ATaylorCEngFIET/f14_CADC/original_docs/toc-illustrations.pdf

t-l
t-f

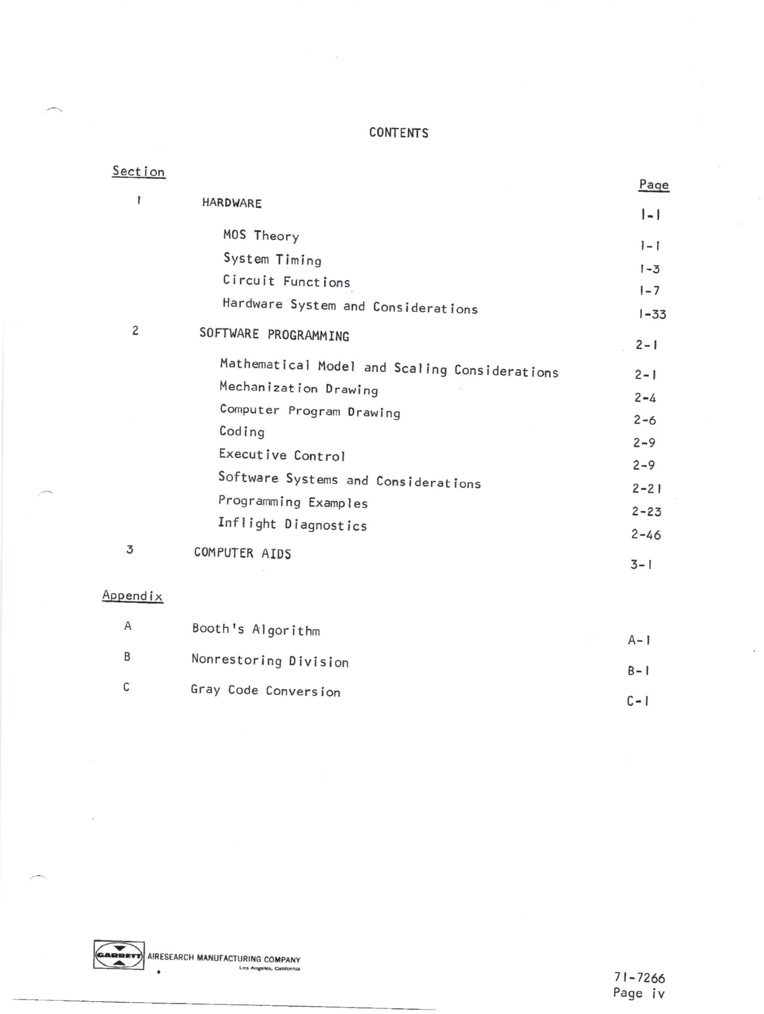
[picture p2: page 1]

Sect i on

I

Append ix

2

CONTE}TTS

HARDWARE

MOS Theory
Systern Timing
Circuit Functions.
Hardware System and Considerat ions

SO FTT,'ARE PROGRAI,IH ING
Mathematical Model and Scal ing Considerations
l.lechan i zat i on D rawi ng
Cornpute.r program Drawing

Cod i ng
Execut ive Control
Software Systems and Considerations Progranrning ExampIes
Infl ight D iagnost ics

COI,IPUTER AIDS

Booth rs Al gor ithm

Nonrestoring Division

Gray Code Convers ion

AIRESEARCH TIAIIUFACTURIT'G COUPA'IY

Paqe

t-5
l-7
t -35
2-l
?-l
2-4
2-6
2-9
2-9
2-?'
2-23
2-46
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
7 t -7266
Page iv

(6^lttq6llMa

t-l

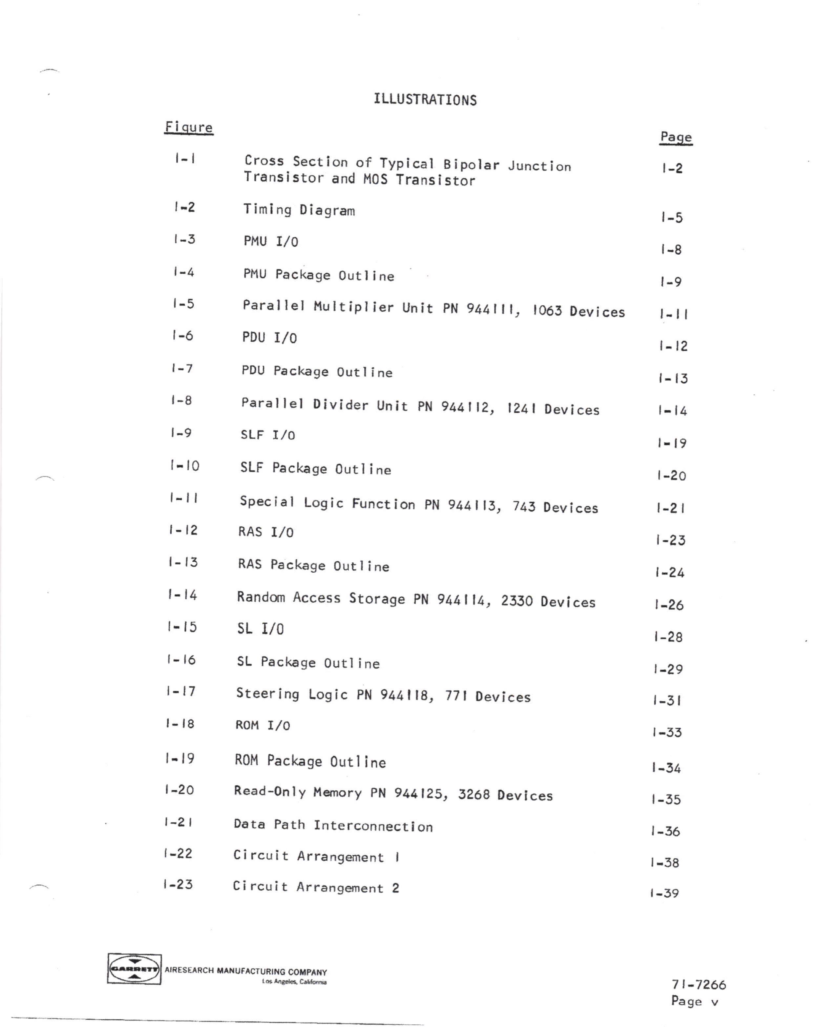
[picture p3: page 2]

Fi oure

ILLUSTRATIONS

### Cross Section of Typical Bipolar Junction Transistor and H0S Transistor

Timi ng Diagram

PMU I/O

PMU Package Outline

## Paral lel ttultipl ier Unit pN g44lll, 1063 Devices

PDU I/O

PDU Package Outline
Paral lel Divider Unit pN gi4llZ, 124 t Devices

SLF I,/O

SLF Package Outl ine
Special Logic Function pN g44llS, 745 Devices

RAS I/O

RAS Package Outline

Randorn Access Storage pN g44l14, Z33O Devices

SL I/O

SL Package 0utl ine
Steering Logic PN g44llg, 771 Devices

ROM I/O

R0t'1 Package Outline
Read-Only Hernory pN 9441A5, 126g Devlces Data Path Interconnection
Ci rcuit Arrange.rnent I
Circuit Arrangement 2

A'RESEARCH MAI{Uf ACTURING COI!PANY

Paqe
t-2

t -?,
l-3
t-4
t-5
t-6
t-7
l-8
t-9
t- l0

## r-il

t- t2
l- t3
t- t4
t- t5
l- t6
t-t7
t- t8
l- t9

t-20
t-2t

1-22
t-23

t-5
l-8
t-9
t- I I
t-t2

t- t3
t- t4
t- t9

I -20
t-2t

| -25
,-24
t-26

| -28
t-29
r-3 I

r -55

I -34
I -35

I -56

I -58
r -59

7 t-7266
Page v

t 6 &edq C.lCorE

2-t

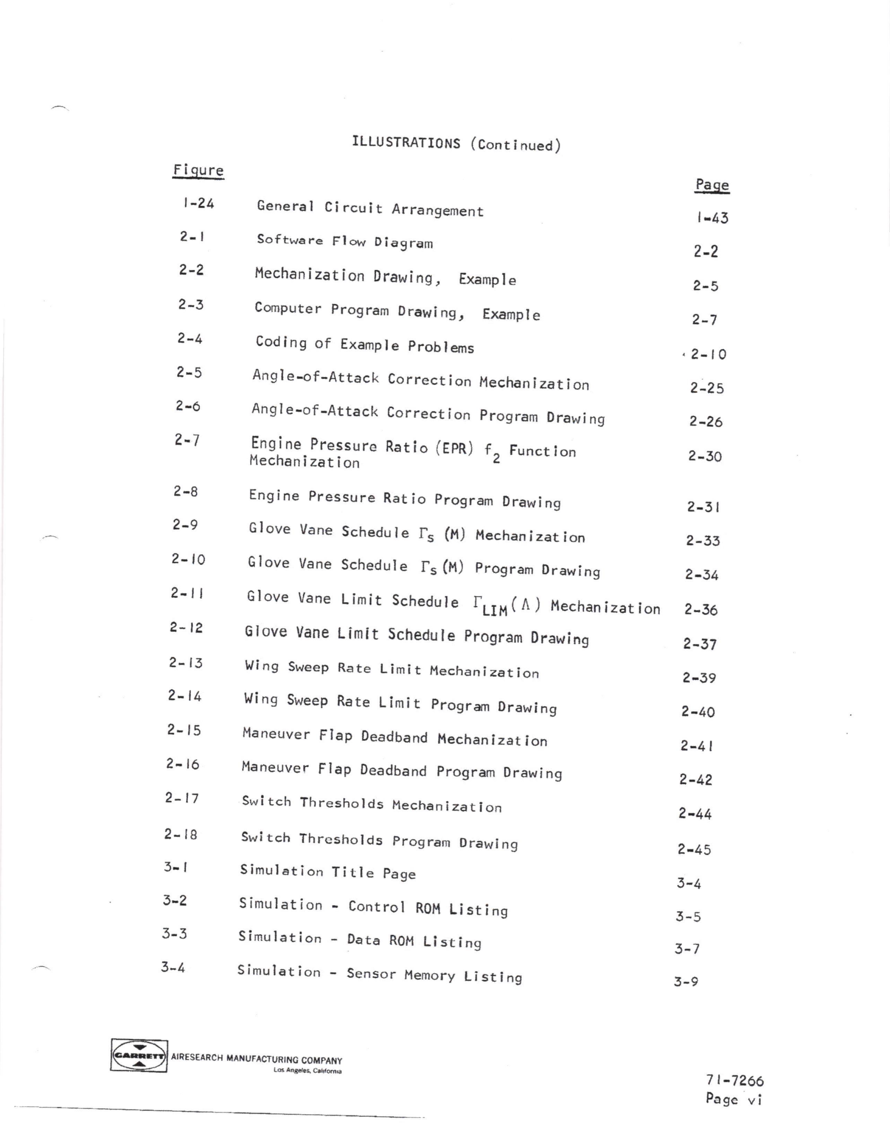
[picture p4: page 3]

Fiqure
t-24

z-2
2-3
2-4

2-5
z-6

2-7

ILLUSTRATIONS (Cont i nued)

General Ci rcuit Arrangement Softwore Flor Diagram

Mechanization Drawing, Example Conrputer program Drawi ng, E:<ampl e

Coding of Example problems Angle-of-Attack Correct ion Mechan izat ion Angle-of-Attack Correction program Drawing

## ,*:;f ,ljff:X." Rat i o (EPR) r, Funct ion

Engine Pressure Ratio program Drawing Glove Vane Schedule fu (H) Hectranization

GIove Vane Schedule f, (m) program Drawing
Glove Vane Limit Schedule lltm ( A ) t{echanizat ion Glove uane Llmlt schedule program Drawing

ly'ing Sweep Rate Limit Hechanization

Wing Sweep Rate Limit progranr Drawing

Haneuver FIap Deadband Mechanizat ion

Haneuver Flap Deadband program Drawing Swi tch Thresholds Hechanizat Ion

Switsh Thresholds program Drawing Simuletion Title page
Simulation - Control R0fi Listing Simulation - Data ROH Listing Simulation - Sensor l.temory Listing

A'RESEANCH MANUFASTURING COTTPATIY

Paqe
| -45
2-2
2-5

2-7
,2-t0

2-2s
2-26

2-30

?-8
2-9
2-t0
2-tI

2- t2

2- 13
2-,4

2- t5
2- t6

2- t7

2- l8
5-t

3-2
3-3
3-4

2-3t

2-33
2-34

2-36

2-37
2-39
2-40
2-4t

2-42

2-44

2-45
3-4
5-5

3-7
5-9

7 t-7266
Page vi

L6 tua+a 61rffi6

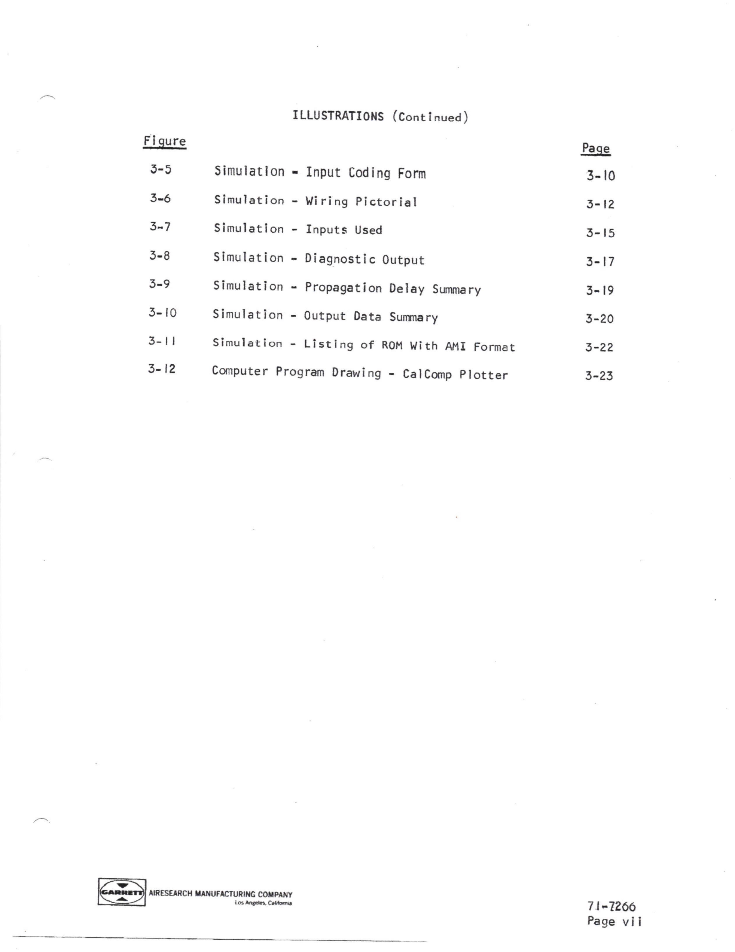
[picture p5: page 4]

Fi qure

5-5

5-6

3-7

5-8
3-9
5- t0
3-il

3- t2

Paqe
3- t0
3- tz
3- 15

3- l7

3- 19

5-20

3-?2
3-23

ILLUSTRATIONS (Cont i nued)

Simulation - Input Coding Form

Simulation - l/i ri n9 pictorial Simulation - Inputs Used
Simulation - Diagnostic Output
Simulation - Propagation Delay Summary Simulation - 0utput Oata Sunmary

### Simulat ion - List i ng of ROl,l u/i th AMI Format

Computer Program Drawing - CalComp plotter

ATRESETRCH tllr{ufAcruRttac collpAr{y
7.1-1266
Page vi i

tG }Eraa C.fbnc
