ATaylorCEngFIET/f14_CADC/sim_results.txt

# ** Note: (vsim-220) 'C:/questa_base64_2025.3/win64/../modelsim.ini' is used as the ini file.
# vsim -batch -t ns work.cadc_top_tb -do "run 50us; quit -f" 
# Start time: 17:16:37 on Feb 21,2026
# ** Note: (vsim-3812) Design is being optimized...
# ** Note: (vopt-220) 'C:/questa_base64_2025.3/win64/../modelsim.ini' is used as the ini file.
# ** Warning: (vopt-133) Unable to remove directory "C:/Users/aptay/Dropbox/adiuvo/f14-CADC/work/@_opt".
# ** Note: (vsim-12126) Error and warning message counts have been restored: Errors=0, Warnings=1.
# //  QuestaSim Base Edition-64
# //  Version 2025.3 win64 Sep 15 2025
# //
# // Unpublished work. Copyright 2025 Siemens
# //
# // This material contains trade secrets or otherwise confidential information
# // owned by Siemens Industry Software Inc. or its affiliates (collectively,
# // "SISW"), or its licensors. Access to and use of this information is strictly
# // limited as set forth in the Customer's applicable agreements with SISW.
# //
# // This material may not be copied, distributed, or otherwise disclosed outside
# // of the Customer's facilities without the express written permission of SISW,
# // and may not be used in any way not expressly authorized by SISW.
# //
# Loading std.standard
# Loading std.textio(body)
# Loading ieee.std_logic_1164(body)
# Loading ieee.numeric_std(body)
# Loading work.cadc_top_tb(bench)#1
# Loading work.cadc_top(structural)#1
# 
# run 50us
# ** Note: ======================================
#    Time: 0 ns  Iteration: 0  Instance: /cadc_top_tb
# ** Note: F-14A CADC Polynomial Computation Test
#    Time: 0 ns  Iteration: 0  Instance: /cadc_top_tb
# ** Note: ======================================
#    Time: 0 ns  Iteration: 0  Instance: /cadc_top_tb
# ** Note: Polynomial: E = a3*X^3 + a2*X^2 + a1*X + a0
#    Time: 0 ns  Iteration: 0  Instance: /cadc_top_tb
# ** Note: Coefficients: a3=0.125, a2=0.25, a1=0.375, a0=0.0625
#    Time: 0 ns  Iteration: 0  Instance: /cadc_top_tb
# ** Note: Input X = sensor_ps (Q1.19 fractional format)
#    Time: 0 ns  Iteration: 0  Instance: /cadc_top_tb
# ** Note: 
#    Time: 0 ns  Iteration: 0  Instance: /cadc_top_tb
# ** Note: TOP-T-001: System Reset Test
#    Time: 0 ns  Iteration: 0  Instance: /cadc_top_tb
# ** Warning: NUMERIC_STD.TO_INTEGER: metavalue detected, returning 0
#    Time: 0 ns  Iteration: 0  Instance: /cadc_top_tb/uut/u_ras
# ** Warning: NUMERIC_STD.TO_INTEGER: metavalue detected, returning 0
#    Time: 0 ns  Iteration: 0  Instance: /cadc_top_tb/uut
# ** Warning: NUMERIC_STD.TO_INTEGER: metavalue detected, returning 0
#    Time: 0 ns  Iteration: 1  Instance: /cadc_top_tb/uut
# ** Warning: NUMERIC_STD.TO_INTEGER: metavalue detected, returning 0
#    Time: 0 ns  Iteration: 1  Instance: /cadc_top_tb/uut/u_ras
# ** Warning: NUMERIC_STD.TO_INTEGER: metavalue detected, returning 0
#    Time: 0 ns  Iteration: 2  Instance: /cadc_top_tb/uut/u_ras
# ** Note:   PASSED: Outputs zero after reset
#    Time: 241 ns  Iteration: 0  Instance: /cadc_top_tb
# ** Note: 
#    Time: 241 ns  Iteration: 0  Instance: /cadc_top_tb
# ** Note: TOP-T-002: Polynomial with X = 0.5 (0x40000)
#    Time: 241 ns  Iteration: 0  Instance: /cadc_top_tb
# ** Note:   Input X = 0x40000 (0.5)
#    Time: 4231 ns  Iteration: 0  Instance: /cadc_top_tb
# ** Note:   Result E = 0x2A000
#    Time: 4231 ns  Iteration: 0  Instance: /cadc_top_tb
# ** Note:   PASSED: Polynomial computed non-zero result
#    Time: 4231 ns  Iteration: 0  Instance: /cadc_top_tb
# ** Note: 
#    Time: 4231 ns  Iteration: 0  Instance: /cadc_top_tb
# ** Note: TOP-T-003: Result Stability Check
#    Time: 4231 ns  Iteration: 0  Instance: /cadc_top_tb
# ** Note:   PASSED: Result stable after halt (0x2A000)
#    Time: 6231 ns  Iteration: 0  Instance: /cadc_top_tb
# ** Note: 
#    Time: 6231 ns  Iteration: 0  Instance: /cadc_top_tb
# ** Note: TOP-T-004: Polynomial with X = 0.25 (0x20000)
#    Time: 6231 ns  Iteration: 0  Instance: /cadc_top_tb
# ** Note:   Input X = 0x20000 (0.25)
#    Time: 10371 ns  Iteration: 0  Instance: /cadc_top_tb
# ** Note:   Result E = 0x16400
#    Time: 10371 ns  Iteration: 0  Instance: /cadc_top_tb
# ** Note:   PASSED: Different input produces different result
#    Time: 10371 ns  Iteration: 0  Instance: /cadc_top_tb
# ** Note: 
#    Time: 10371 ns  Iteration: 0  Instance: /cadc_top_tb
# ** Note: TOP-T-005: Polynomial with X = 0.75 (0x60000)
#    Time: 10371 ns  Iteration: 0  Instance: /cadc_top_tb
# ** Note:   Input X = 0x60000 (0.75)
#    Time: 14511 ns  Iteration: 0  Instance: /cadc_top_tb
# ** Note:   Result E = 0x44C00
#    Time: 14511 ns  Iteration: 0  Instance: /cadc_top_tb
# ** Note:   PASSED: Non-zero result for X=0.75
#    Time: 14511 ns  Iteration: 0  Instance: /cadc_top_tb
# ** Note: 
#    Time: 14511 ns  Iteration: 0  Instance: /cadc_top_tb
# ** Note: TOP-T-006: Channel Inactive Output Gating
#    Time: 14511 ns  Iteration: 0  Instance: /cadc_top_tb
# ** Note:   PASSED: Output gated to zero when channel inactive
#    Time: 14612 ns  Iteration: 0  Instance: /cadc_top_tb
# ** Note: 
#    Time: 14652 ns  Iteration: 0  Instance: /cadc_top_tb
# ** Note: TOP-T-007: Extended Run (1000 cycles)
#    Time: 14652 ns  Iteration: 0  Instance: /cadc_top_tb
# ** Note:   PASSED: System ran 1000 cycles without lockup
#    Time: 34651 ns  Iteration: 0  Instance: /cadc_top_tb
# ** Note: 
#    Time: 34651 ns  Iteration: 0  Instance: /cadc_top_tb
# ** Note: TOP-T-008: Fail Detect Signal
#    Time: 34651 ns  Iteration: 0  Instance: /cadc_top_tb
# ** Note:   PASSED: No failure detected
#    Time: 34651 ns  Iteration: 0  Instance: /cadc_top_tb
# ** Note: 
#    Time: 34851 ns  Iteration: 0  Instance: /cadc_top_tb
# ** Note: ======================================
#    Time: 34851 ns  Iteration: 0  Instance: /cadc_top_tb
# ** Note: CADC Polynomial Testbench Complete
#    Time: 34851 ns  Iteration: 0  Instance: /cadc_top_tb
# ** Note: ======================================
#    Time: 34851 ns  Iteration: 0  Instance: /cadc_top_tb
# ** Note: Tests run: 7
#    Time: 34851 ns  Iteration: 0  Instance: /cadc_top_tb
# ** Note: Failures:  0
#    Time: 34851 ns  Iteration: 0  Instance: /cadc_top_tb
# ** Note: RESULT: ALL TESTS PASSED
#    Time: 34851 ns  Iteration: 0  Instance: /cadc_top_tb
# ** Note: ======================================
#    Time: 34851 ns  Iteration: 0  Instance: /cadc_top_tb
# ** Note: 
#    Time: 34851 ns  Iteration: 0  Instance: /cadc_top_tb
# ** Note: Note: This testbench verifies the polynomial microprogram
#    Time: 34851 ns  Iteration: 0  Instance: /cadc_top_tb
# ** Note: from Section 2 of Ray Holt's CADC documentation.
#    Time: 34851 ns  Iteration: 0  Instance: /cadc_top_tb
# ** Note: E = a3*X^3 + a2*X^2 + a1*X + a0 computed via Horner's method.
#    Time: 34851 ns  Iteration: 0  Instance: /cadc_top_tb
# ** Failure: sim complete
#    Time: 34851 ns  Iteration: 0  Process: /cadc_top_tb/stim File: tb/cadc_top_tb.vhd
# Break in Process stim at tb/cadc_top_tb.vhd line 309
# Stopped at tb/cadc_top_tb.vhd line 309
# quit -f
# End time: 17:16:39 on Feb 21,2026, Elapsed time: 0:00:02
# Errors: 1, Warnings: 6
