ATaylorCEngFIET/f14_CADC/implementation/vivado_proj/cadc_cmoda7.gen/sources_1/bd/cadc_system/ip/cadc_system_jtag_axi_0_0/synth/cadc_system_jtag_axi_0_0.vhd

-- (c) Copyright 1986-2022 Xilinx, Inc. All Rights Reserved.
-- (c) Copyright 2022-2026 Advanced Micro Devices, Inc. All rights reserved.
-- 
-- This file contains confidential and proprietary information
-- of AMD and is protected under U.S. and international copyright
-- and other intellectual property laws.
-- 
-- DISCLAIMER
-- This disclaimer is not a license and does not grant any
-- rights to the materials distributed herewith. Except as
-- otherwise provided in a valid license issued to you by
-- AMD, and to the maximum extent permitted by applicable
-- law: (1) THESE MATERIALS ARE MADE AVAILABLE "AS IS" AND
-- WITH ALL FAULTS, AND AMD HEREBY DISCLAIMS ALL WARRANTIES
-- AND CONDITIONS, EXPRESS, IMPLIED, OR STATUTORY, INCLUDING
-- BUT NOT LIMITED TO WARRANTIES OF MERCHANTABILITY, NON-
-- INFRINGEMENT, OR FITNESS FOR ANY PARTICULAR PURPOSE; and
-- (2) AMD shall not be liable (whether in contract or tort,
-- including negligence, or under any other theory of
-- liability) for any loss or damage of any kind or nature
-- related to, arising under or in connection with these
-- materials, including for any direct, or any indirect,
-- special, incidental, or consequential loss or damage
-- (including loss of data, profits, goodwill, or any type of
-- loss or damage suffered as a result of any action brought
-- by a third party) even if such damage or loss was
-- reasonably foreseeable or AMD had been advised of the
-- possibility of the same.
-- 
-- CRITICAL APPLICATIONS
-- AMD products are not designed or intended to be fail-
-- safe, or for use in any application requiring fail-safe
-- performance, such as life-support or safety devices or
-- systems, Class III medical devices, nuclear facilities,
-- applications related to the deployment of airbags, or any
-- other applications that could lead to death, personal
-- injury, or severe property or environmental damage
-- (individually and collectively, "Critical
-- Applications"). Customer assumes the sole risk and
-- liability of any use of AMD products in Critical
-- Applications, subject only to applicable laws and
-- regulations governing limitations on product liability.
-- 
-- THIS COPYRIGHT NOTICE AND DISCLAIMER MUST BE RETAINED AS
-- PART OF THIS FILE AT ALL TIMES.
-- 
-- DO NOT MODIFY THIS FILE.

-- IP VLNV: xilinx.com:ip:jtag_axi:1.2
-- IP Revision: 22

LIBRARY ieee;
USE ieee.std_logic_1164.ALL;
USE ieee.numeric_std.ALL;

LIBRARY jtag_axi;
USE jtag_axi.jtag_axi_v1_2_22_jtag_axi;

ENTITY cadc_system_jtag_axi_0_0 IS
  PORT (
    aclk : IN STD_LOGIC;
    aresetn : IN STD_LOGIC;
    m_axi_awaddr : OUT STD_LOGIC_VECTOR(31 DOWNTO 0);
    m_axi_awprot : OUT STD_LOGIC_VECTOR(2 DOWNTO 0);
    m_axi_awvalid : OUT STD_LOGIC;
    m_axi_awready : IN STD_LOGIC;
    m_axi_wdata : OUT STD_LOGIC_VECTOR(31 DOWNTO 0);
    m_axi_wstrb : OUT STD_LOGIC_VECTOR(3 DOWNTO 0);
    m_axi_wvalid : OUT STD_LOGIC;
    m_axi_wready : IN STD_LOGIC;
    m_axi_bresp : IN STD_LOGIC_VECTOR(1 DOWNTO 0);
    m_axi_bvalid : IN STD_LOGIC;
    m_axi_bready : OUT STD_LOGIC;
    m_axi_araddr : OUT STD_LOGIC_VECTOR(31 DOWNTO 0);
    m_axi_arprot : OUT STD_LOGIC_VECTOR(2 DOWNTO 0);
    m_axi_arvalid : OUT STD_LOGIC;
    m_axi_arready : IN STD_LOGIC;
    m_axi_rdata : IN STD_LOGIC_VECTOR(31 DOWNTO 0);
    m_axi_rresp : IN STD_LOGIC_VECTOR(1 DOWNTO 0);
    m_axi_rvalid : IN STD_LOGIC;
    m_axi_rready : OUT STD_LOGIC
  );
END cadc_system_jtag_axi_0_0;

ARCHITECTURE cadc_system_jtag_axi_0_0_arch OF cadc_system_jtag_axi_0_0 IS
  ATTRIBUTE DowngradeIPIdentifiedWarnings : STRING;
  ATTRIBUTE DowngradeIPIdentifiedWarnings OF cadc_system_jtag_axi_0_0_arch: ARCHITECTURE IS "yes";
  COMPONENT jtag_axi_v1_2_22_jtag_axi IS
    GENERIC (
      RD_TXN_QUEUE_LENGTH : INTEGER;
      WR_TXN_QUEUE_LENGTH : INTEGER;
      M_AXI_ID_WIDTH : INTEGER;
      M_AXI_ADDR_WIDTH : INTEGER;
      FAMILY : STRING;
      M_AXI_DATA_WIDTH : INTEGER;
      M_HAS_BURST : INTEGER;
      PROTOCOL : INTEGER
    );
    PORT (
      aclk : IN STD_LOGIC;
      aresetn : IN STD_LOGIC;
      m_axi_awid : OUT STD_LOGIC_VECTOR(0 DOWNTO 0);
      m_axi_awaddr : OUT STD_LOGIC_VECTOR(31 DOWNTO 0);
      m_axi_awlen : OUT STD_LOGIC_VECTOR(7 DOWNTO 0);
      m_axi_awsize : OUT STD_LOGIC_VECTOR(2 DOWNTO 0);
      m_axi_awburst : OUT STD_LOGIC_VECTOR(1 DOWNTO 0);
      m_axi_awlock : OUT STD_LOGIC;
      m_axi_awcache : OUT STD_LOGIC_VECTOR(3 DOWNTO 0);
      m_axi_awprot : OUT STD_LOGIC_VECTOR(2 DOWNTO 0);
      m_axi_awqos : OUT STD_LOGIC_VECTOR(3 DOWNTO 0);
      m_axi_awvalid : OUT STD_LOGIC;
      m_axi_awready : IN STD_LOGIC;
      m_axi_wdata : OUT STD_LOGIC_VECTOR(31 DOWNTO 0);
      m_axi_wstrb : OUT STD_LOGIC_VECTOR(3 DOWNTO 0);
      m_axi_wlast : OUT STD_LOGIC;
      m_axi_wvalid : OUT STD_LOGIC;
      m_axi_wready : IN STD_LOGIC;
      m_axi_bid : IN STD_LOGIC_VECTOR(0 DOWNTO 0);
      m_axi_bresp : IN STD_LOGIC_VECTOR(1 DOWNTO 0);
      m_axi_bvalid : IN STD_LOGIC;
      m_axi_bready : OUT STD_LOGIC;
      m_axi_arid : OUT STD_LOGIC_VECTOR(0 DOWNTO 0);
      m_axi_araddr : OUT STD_LOGIC_VECTOR(31 DOWNTO 0);
      m_axi_arlen : OUT STD_LOGIC_VECTOR(7 DOWNTO 0);
      m_axi_arsize : OUT STD_LOGIC_VECTOR(2 DOWNTO 0);
      m_axi_arburst : OUT STD_LOGIC_VECTOR(1 DOWNTO 0);
      m_axi_arlock : OUT STD_LOGIC;
      m_axi_arcache : OUT STD_LOGIC_VECTOR(3 DOWNTO 0);
      m_axi_arprot : OUT STD_LOGIC_VECTOR(2 DOWNTO 0);
      m_axi_arqos : OUT STD_LOGIC_VECTOR(3 DOWNTO 0);
      m_axi_arvalid : OUT STD_LOGIC;
      m_axi_arready : IN STD_LOGIC;
      m_axi_rid : IN STD_LOGIC_VECTOR(0 DOWNTO 0);
      m_axi_rdata : IN STD_LOGIC_VECTOR(31 DOWNTO 0);
      m_axi_rresp : IN STD_LOGIC_VECTOR(1 DOWNTO 0);
      m_axi_rlast : IN STD_LOGIC;
      m_axi_rvalid : IN STD_LOGIC;
      m_axi_rready : OUT STD_LOGIC
    );
  END COMPONENT jtag_axi_v1_2_22_jtag_axi;
  ATTRIBUTE X_CORE_INFO : STRING;
  ATTRIBUTE X_CORE_INFO OF cadc_system_jtag_axi_0_0_arch: ARCHITECTURE IS "jtag_axi_v1_2_22_jtag_axi,Vivado 2025.1";
  ATTRIBUTE CHECK_LICENSE_TYPE : STRING;
  ATTRIBUTE CHECK_LICENSE_TYPE OF cadc_system_jtag_axi_0_0_arch : ARCHITECTURE IS "cadc_system_jtag_axi_0_0,jtag_axi_v1_2_22_jtag_axi,{}";
  ATTRIBUTE CORE_GENERATION_INFO : STRING;
  ATTRIBUTE CORE_GENERATION_INFO OF cadc_system_jtag_axi_0_0_arch: ARCHITECTURE IS "cadc_system_jtag_axi_0_0,jtag_axi_v1_2_22_jtag_axi,{x_ipProduct=Vivado 2025.1,x_ipVendor=xilinx.com,x_ipLibrary=ip,x_ipName=jtag_axi,x_ipVersion=1.2,x_ipCoreRevision=22,x_ipLanguage=VHDL,x_ipSimLanguage=MIXED,RD_TXN_QUEUE_LENGTH=1,WR_TXN_QUEUE_LENGTH=1,M_AXI_ID_WIDTH=1,M_AXI_ADDR_WIDTH=32,FAMILY=artix7,M_AXI_DATA_WIDTH=32,M_HAS_BURST=1,PROTOCOL=2}";
  ATTRIBUTE X_INTERFACE_INFO : STRING;
  ATTRIBUTE X_INTERFACE_MODE : STRING;
  ATTRIBUTE X_INTERFACE_PARAMETER : STRING;
  ATTRIBUTE X_INTERFACE_INFO OF aclk: SIGNAL IS "xilinx.com:signal:clock:1.0 signal_clock CLK";
  ATTRIBUTE X_INTERFACE_MODE OF aclk: SIGNAL IS "slave signal_clock";
  ATTRIBUTE X_INTERFACE_PARAMETER OF aclk: SIGNAL IS "XIL_INTERFACENAME signal_clock, ASSOCIATED_BUSIF M_AXI, ASSOCIATED_RESET aresetn, FREQ_HZ 100000000, FREQ_TOLERANCE_HZ 0, PHASE 0.0, CLK_DOMAIN /clk_wiz_0_clk_out1, INSERT_VIP 0";
  ATTRIBUTE X_INTERFACE_INFO OF aresetn: SIGNAL IS "xilinx.com:signal:reset:1.0 signal_reset RST";
  ATTRIBUTE X_INTERFACE_MODE OF aresetn: SIGNAL IS "slave signal_reset";
  ATTRIBUTE X_INTERFACE_PARAMETER OF aresetn: SIGNAL IS "XIL_INTERFACENAME signal_reset, POLARITY ACTIVE_LOW, INSERT_VIP 0";
  ATTRIBUTE X_INTERFACE_INFO OF m_axi_araddr: SIGNAL IS "xilinx.com:interface:aximm:1.0 M_AXI ARADDR";
  ATTRIBUTE X_INTERFACE_INFO OF m_axi_arprot: SIGNAL IS "xilinx.com:interface:aximm:1.0 M_AXI ARPROT";
  ATTRIBUTE X_INTERFACE_INFO OF m_axi_arready: SIGNAL IS "xilinx.com:interface:aximm:1.0 M_AXI ARREADY";
  ATTRIBUTE X_INTERFACE_INFO OF m_axi_arvalid: SIGNAL IS "xilinx.com:interface:aximm:1.0 M_AXI ARVALID";
  ATTRIBUTE X_INTERFACE_INFO OF m_axi_awaddr: SIGNAL IS "xilinx.com:interface:aximm:1.0 M_AXI AWADDR";
  ATTRIBUTE X_INTERFACE_MODE OF m_axi_awaddr: SIGNAL IS "master M_AXI";
  ATTRIBUTE X_INTERFACE_PARAMETER OF m_axi_awaddr: SIGNAL IS "XIL_INTERFACENAME M_AXI, AWUSER_WIDTH 0, ARUSER_WIDTH 0, WUSER_WIDTH 0, BUSER_WIDTH 0, RUSER_WIDTH 0, SUPPORTS_NARROW_BURST 0, DATA_WIDTH 32, PROTOCOL AXI4LITE, FREQ_HZ 100000000, ID_WIDTH 0, ADDR_WIDTH 32, READ_WRITE_MODE READ_WRITE, HAS_BURST 0, HAS_LOCK 0, HAS_PROT 1, HAS_CACHE 0, HAS_QOS 0, HAS_REGION 0, HAS_WSTRB 1, HAS_BRESP 1, HAS_RRESP 1, NUM_READ_OUTSTANDING 1, NUM_WRITE_OUTSTANDING 1, MAX_BURST_LENGTH 1, PHASE 0.0, CLK_DOMAIN /clk_wiz_0_clk_out1, NUM_READ_THREADS 1, NUM_WRITE_THREADS 1" & 
", RUSER_BITS_PER_BYTE 0, WUSER_BITS_PER_BYTE 0, INSERT_VIP 0";
  ATTRIBUTE X_INTERFACE_INFO OF m_axi_awprot: SIGNAL IS "xilinx.com:interface:aximm:1.0 M_AXI AWPROT";
  ATTRIBUTE X_INTERFACE_INFO OF m_axi_awready: SIGNAL IS "xilinx.com:interface:aximm:1.0 M_AXI AWREADY";
  ATTRIBUTE X_INTERFACE_INFO OF m_axi_awvalid: SIGNAL IS "xilinx.com:interface:aximm:1.0 M_AXI AWVALID";
  ATTRIBUTE X_INTERFACE_INFO OF m_axi_bready: SIGNAL IS "xilinx.com:interface:aximm:1.0 M_AXI BREADY";
  ATTRIBUTE X_INTERFACE_INFO OF m_axi_bresp: SIGNAL IS "xilinx.com:interface:aximm:1.0 M_AXI BRESP";
  ATTRIBUTE X_INTERFACE_INFO OF m_axi_bvalid: SIGNAL IS "xilinx.com:interface:aximm:1.0 M_AXI BVALID";
  ATTRIBUTE X_INTERFACE_INFO OF m_axi_rdata: SIGNAL IS "xilinx.com:interface:aximm:1.0 M_AXI RDATA";
  ATTRIBUTE X_INTERFACE_INFO OF m_axi_rready: SIGNAL IS "xilinx.com:interface:aximm:1.0 M_AXI RREADY";
  ATTRIBUTE X_INTERFACE_INFO OF m_axi_rresp: SIGNAL IS "xilinx.com:interface:aximm:1.0 M_AXI RRESP";
  ATTRIBUTE X_INTERFACE_INFO OF m_axi_rvalid: SIGNAL IS "xilinx.com:interface:aximm:1.0 M_AXI RVALID";
  ATTRIBUTE X_INTERFACE_INFO OF m_axi_wdata: SIGNAL IS "xilinx.com:interface:aximm:1.0 M_AXI WDATA";
  ATTRIBUTE X_INTERFACE_INFO OF m_axi_wready: SIGNAL IS "xilinx.com:interface:aximm:1.0 M_AXI WREADY";
  ATTRIBUTE X_INTERFACE_INFO OF m_axi_wstrb: SIGNAL IS "xilinx.com:interface:aximm:1.0 M_AXI WSTRB";
  ATTRIBUTE X_INTERFACE_INFO OF m_axi_wvalid: SIGNAL IS "xilinx.com:interface:aximm:1.0 M_AXI WVALID";
BEGIN
  U0 : jtag_axi_v1_2_22_jtag_axi
    GENERIC MAP (
      RD_TXN_QUEUE_LENGTH => 1,
      WR_TXN_QUEUE_LENGTH => 1,
      M_AXI_ID_WIDTH => 1,
      M_AXI_ADDR_WIDTH => 32,
      FAMILY => "artix7",
      M_AXI_DATA_WIDTH => 32,
      M_HAS_BURST => 1,
      PROTOCOL => 2
    )
    PORT MAP (
      aclk => aclk,
      aresetn => aresetn,
      m_axi_awaddr => m_axi_awaddr,
      m_axi_awprot => m_axi_awprot,
      m_axi_awvalid => m_axi_awvalid,
      m_axi_awready => m_axi_awready,
      m_axi_wdata => m_axi_wdata,
      m_axi_wstrb => m_axi_wstrb,
      m_axi_wvalid => m_axi_wvalid,
      m_axi_wready => m_axi_wready,
      m_axi_bid => STD_LOGIC_VECTOR(TO_UNSIGNED(0, 1)),
      m_axi_bresp => m_axi_bresp,
      m_axi_bvalid => m_axi_bvalid,
      m_axi_bready => m_axi_bready,
      m_axi_araddr => m_axi_araddr,
      m_axi_arprot => m_axi_arprot,
      m_axi_arvalid => m_axi_arvalid,
      m_axi_arready => m_axi_arready,
      m_axi_rid => STD_LOGIC_VECTOR(TO_UNSIGNED(0, 1)),
      m_axi_rdata => m_axi_rdata,
      m_axi_rresp => m_axi_rresp,
      m_axi_rlast => '0',
      m_axi_rvalid => m_axi_rvalid,
      m_axi_rready => m_axi_rready
    );
END cadc_system_jtag_axi_0_0_arch;
