ATaylorCEngFIET/f14_CADC/implementation/vivado_proj/cadc_cmoda7.gen/sources_1/bd/cadc_system/ipshared/7557/hdl/jtag_axi_v1_2_rfs.v

`pragma protect begin_protected
`pragma protect version = 1
`pragma protect encrypt_agent = "XILINX"
`pragma protect encrypt_agent_info = "Xilinx Encryption Tool 2025.1"
`pragma protect key_keyowner = "Synopsys", key_keyname = "SNPS-VCS-RSA-2", key_method = "rsa"
`pragma protect encoding = (enctype = "BASE64", line_length = 76, bytes = 128)
`pragma protect key_block
ZGBOdjFNDZWih9i7dViy5O4mfCX+KM+Jpl4+JuIUXGEIPd5EPpiX8YepIw1J/GGQxY7KBQyt/UwM
0B+6RXHqRFr8BO1f55n3qZpqcjwILhKKKiiUX/GJztyetWYOkSSv74/XryytAfQsJq+Cr5ncBP51
zHhuoBwfCs4BAlHvj6U=

`pragma protect key_keyowner = "Aldec", key_keyname = "ALDEC15_001", key_method = "rsa"
`pragma protect encoding = (enctype = "BASE64", line_length = 76, bytes = 256)
`pragma protect key_block
XKLNMtQJsKxqBqkNTtiRIK8u7HvyPgw/vy5O5sWmLIf+es+o57mVUxIPbv0qZnI4zrl58aly0iRT
znUwMjY4d+9FkVAy+sbofwK/+wQ0AzBNoIIC0Ct01GgqGxyo6m1NlpZMpKcsKpjKNOMANrjMyPA7
+XKn4nADd2rZE0fEYMJsrjLJwhGXQEgEiPUFOQb2LIRNtgG54Bb/U4VWqZazQb25ITGJR+yyKeX6
LmEiH3JxSncA9FEVQIoL8HiX1U+EfV5TgPzR3w12rqqR5/XqG/N7Pqe2vzlgi8+Ve77IsujtPYF6
Ik4foGpcOrp5q8pHa0o+TEGkEO6EL3dQ1+S0FQ==

`pragma protect key_keyowner = "Mentor Graphics Corporation", key_keyname = "MGC-VELOCE-RSA", key_method = "rsa"
`pragma protect encoding = (enctype = "BASE64", line_length = 76, bytes = 128)
`pragma protect key_block
RhbWOpxu+RTRy58hi6+6V12xRfpvM9cFoN9is+mo8a7cAwL6XA+8oz0UE6sSHS/3+AcYSp2AJS+O
eAkGZQ4IA7LCxILlEasaC0d3j61mE4XOmJ0Q+LEKKf5u9RXx7FDMKlJ4rXwhRjZm60/88FEx/rKR
EIqiTPA2XdTJtolGNzQ=

`pragma protect key_keyowner = "Mentor Graphics Corporation", key_keyname = "MGC-VERIF-SIM-RSA-2", key_method = "rsa"
`pragma protect encoding = (enctype = "BASE64", line_length = 76, bytes = 256)
`pragma protect key_block
EGb0g7u4UEditTgM0lWo5kj2nxkYrbql3HeYfdAuONOmKoktkCsw4KYtUz2vxunr4RN4LphzR2dC
L9Ts5SEuCBeR8f0TQrN9u1bVJea//siuk/8Dv4PXCE+fR+Ef6ukh8nLoCdQhJo+ljZsUAmQiX618
DQDg/7Yox2gTc0gPeSsaz/ikaw1IFZfNyI12dGDCjXjHTW9hiwTv0NB42S0PT5OYFlMk03SkgVtP
oehfv3W3ceZBjGjgvsz3tP8e8tkrEU0bZfC1DbpW4V21ZKblYCKvpLVszXubFHA26FbYSTpw7+0n
qahu5ggFvGaqTW6H99/iHPaIRx47IgLFDsW26A==

`pragma protect key_keyowner = "Real Intent", key_keyname = "RI-RSA-KEY-1", key_method = "rsa"
`pragma protect encoding = (enctype = "BASE64", line_length = 76, bytes = 256)
`pragma protect key_block
cWzuEgz57Qfhb7y9vZdxqR2RGRWDk1aU2fpqFwXKfcLh7dlGCtkVTjII8kuZVnCvx4XJsH5w6+Qi
2yQ293hI3YvdpHA77xb4JhFkI8hgQZ/ADHW2nbV6q2Vab90IJ9NIX8EnczmzXqsSGDXV3moALtjw
AszbwoSXSnbRp2WFgeSyPlGU1LObNZcRh3DC8V0R59kWaulbFa8O8WWt+/7BUBTnD4UDT0ZuDC1C
McX+vuQ6UmSX+fawfef+Cp9axdb0Pc46Boq/OCYR5w7UDKwGbfDag2zxiSbfnQB0pbcMlSa499Zp
t8C8BdugAIX7pIG6bGvMgt6Ey4v2dKsK7ronPQ==

`pragma protect key_keyowner = "Metrics Technologies Inc.", key_keyname = "DSim", key_method = "rsa"
`pragma protect encoding = (enctype = "BASE64", line_length = 76, bytes = 256)
`pragma protect key_block
eJpJBQrWFdi/Yf4LplAk08EjhOZ1lGNFXhEgWCPtV/2rR6xrZwzFLPfDl2JwKIeG+B0s18jzt1wO
vwpOeXSJ0pxAeDwOaaqo+/mLNal8FiYtTRuOGSW2vStq9+EEghPDB+e/N1l+r7buqGEymqxmPjM/
vb3SNwD5/RDQUlagcB/ywVM79LTLXKN6QoviMDEP2OcTq7YgMwqkad7reJHhQlKFoa3qjsGzph3t
xyzIbKswlBOSxCWs2oCXpLhdIkJ7Dwfg9IeIXpzlePKqrfpt/pkIKUcXHwWlw/4Zy1ACIp4mu+63
AOkDKoFg9MdhwEj/rpEX5YUqPR/oA5o1GYXHzw==

`pragma protect key_keyowner = "Xilinx", key_keyname = "xilinxt_2025.1-2029.x", key_method = "rsa"
`pragma protect encoding = (enctype = "BASE64", line_length = 76, bytes = 256)
`pragma protect key_block
YN3VSrgq7xJ8XenE6gJGJY45gUYLxm5QlMbBhoSkScHAUya/mrLJMCHE27K31Lck0bJ+kSpiZbj9
t+w7WNxw58bp1LVekANKRksd30YGfaVx+t9Fjef3AIkFQaMmKVq7gGkT22wzzWBM4E0B3fGFpnRL
rzJpPxFjI76OD3vX0ub/5mdz/WzbMZeYWO/SeOI1wcCY2O2mCP5+ncM+XMQSlf2uIZ7SsiqqUgPJ
MldlN10QmE+TawDq20qDexERSxEyKabKF/SQLj9AnjnfJ2yeQINGd9dAkS3B1y145ydQzTbzFlT0
cQ9oT3JF7sV+51gqugfvfX8M7lLEicCHLTPy+A==

`pragma protect key_keyowner = "Atrenta", key_keyname = "ATR-SG-RSA-1", key_method = "rsa"
`pragma protect encoding = (enctype = "BASE64", line_length = 76, bytes = 384)
`pragma protect key_block
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

`pragma protect key_keyowner = "Cadence Design Systems.", key_keyname = "CDS_RSA_KEY_VER_1", key_method = "rsa"
`pragma protect encoding = (enctype = "BASE64", line_length = 76, bytes = 256)
`pragma protect key_block
OYyuyiJyPFjJkLQA6ixRFr2ZOidh6L3PfY4uAneYpAy2Bz0Hlo29QclVVOUgyKANidTyBhD0wHnM
EQnd+TJhHwah60Zr6UE4mJdyFmlynPrajfLjrhvwkAfV9OYULoDW6Qqb/lubEZrK2M55yLJJ9Y3Q
S8baFI4eLS4uFF5IIcz+vNNt8ZO2jjQRBXEAnF7NNC6u+tfHf5QpuRmWumhTy3ANLkcY7xWdRSVC
fNHPzatD9bLCPGSWMeJQywDsCzx1nbq+qdsNui27GEEl8VM+1bNJlCXgE8mz0ex66mitc9LBRSxk
FYwtb80GCX6zwdynbKtcMWNjHPbrM15LUllFIQ==

`pragma protect key_keyowner = "Synplicity", key_keyname = "SYNP15_1", key_method = "rsa"
`pragma protect encoding = (enctype = "BASE64", line_length = 76, bytes = 256)
`pragma protect key_block
tdU03a9p5sZtsIuBz/RlwGGAcNGokSnO+97OJUXiO/UbQ7rztkm11m8sD+zo6Kuo46jlA0T1APkx
FwPzNVAPIaM8FrMoNjb1VGvp27EODfGSsckGgP4gTMXJwSEB4inxHk2pdxQTsoykASSI78NRtIVA
ZF1mR4Z4MXkXapmKk9si/Qv8pr+a+RpbVRUvm7umr9+37YY9shu+1icEJ7WAAPKDWbxD9awwiCA3
DndTD0DYL+wdx4kQr/CHbUxoSm7DjahJLaSAYl/TSCJBQtb1Zr1YDwLHbw9RNkKXGWHzg0yQJHCE
dPtR/t+gTOI0knXEQ81hHZXeY1L4jMTQXhQAtA==

`pragma protect key_keyowner = "Mentor Graphics Corporation", key_keyname = "MGC-PREC-RSA", key_method = "rsa"
`pragma protect encoding = (enctype = "BASE64", line_length = 76, bytes = 256)
`pragma protect key_block
eIC98GX7EhBlHCxKJEJZ5bcsL4Wqeuy/QJRYgB2PSXAVMe+JQKNxZxUOgQ51ItJXdvF1lfLe2Ney
jOUpOVu3ZQGxWlAsUtYFDxy9Qhu3QpeZsuMSwYrB3L6+yxKmshhRpt3VpUWogdWBzN+7DJAo8ltA
faqawMjbNxwnZu2rytQrkU4pHrg64FgDn6ONsmX4zKmHL+o+eb5GVuecPrNp/cwU5piwR9Mz1ihV
hGSshnJFdu2nRFLH9lLNxMV414oe4s4mD0IUuraNvE0dUAEAHJU+5RMqIEOqfAAdOzs91nPsBZDb
H/EjD1DgmACBNT4Lt5eGTgrXjwBsTDkXk33yHQ==

`pragma protect data_method = "AES128-CBC"
`pragma protect encoding = (enctype = "BASE64", line_length = 76, bytes = 8080)
`pragma protect data_block
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
`pragma protect end_protected
