ATaylorCEngFIET/f14_CADC/implementation/vivado_proj/cadc_cmoda7.gen/sources_1/bd/cadc_system/synth/cadc_system.vhd

--Copyright 1986-2022 Xilinx, Inc. All Rights Reserved.
--Copyright 2022-2025 Advanced Micro Devices, Inc. All Rights Reserved.
----------------------------------------------------------------------------------
--Tool Version: Vivado v.2025.1 (win64) Build 6140274 Thu May 22 00:12:29 MDT 2025
--Date        : Sun Feb 22 20:57:40 2026
--Host        : Adiuvo_Adam running 64-bit major release  (build 9200)
--Command     : generate_target cadc_system.bd
--Design      : cadc_system
--Purpose     : IP block netlist
----------------------------------------------------------------------------------
library IEEE;
use IEEE.STD_LOGIC_1164.ALL;
library UNISIM;
use UNISIM.VCOMPONENTS.ALL;
entity m00_couplers_imp_1D76A4Z is
  port (
    M_ACLK : in STD_LOGIC;
    M_ARESETN : in STD_LOGIC;
    M_AXI_araddr : out STD_LOGIC_VECTOR ( 31 downto 0 );
    M_AXI_arready : in STD_LOGIC;
    M_AXI_arvalid : out STD_LOGIC;
    M_AXI_awaddr : out STD_LOGIC_VECTOR ( 31 downto 0 );
    M_AXI_awready : in STD_LOGIC;
    M_AXI_awvalid : out STD_LOGIC;
    M_AXI_bready : out STD_LOGIC;
    M_AXI_bresp : in STD_LOGIC_VECTOR ( 1 downto 0 );
    M_AXI_bvalid : in STD_LOGIC;
    M_AXI_rdata : in STD_LOGIC_VECTOR ( 31 downto 0 );
    M_AXI_rready : out STD_LOGIC;
    M_AXI_rresp : in STD_LOGIC_VECTOR ( 1 downto 0 );
    M_AXI_rvalid : in STD_LOGIC;
    M_AXI_wdata : out STD_LOGIC_VECTOR ( 31 downto 0 );
    M_AXI_wready : in STD_LOGIC;
    M_AXI_wstrb : out STD_LOGIC_VECTOR ( 3 downto 0 );
    M_AXI_wvalid : out STD_LOGIC;
    S_ACLK : in STD_LOGIC;
    S_ARESETN : in STD_LOGIC;
    S_AXI_araddr : in STD_LOGIC_VECTOR ( 31 downto 0 );
    S_AXI_arready : out STD_LOGIC;
    S_AXI_arvalid : in STD_LOGIC;
    S_AXI_awaddr : in STD_LOGIC_VECTOR ( 31 downto 0 );
    S_AXI_awready : out STD_LOGIC;
    S_AXI_awvalid : in STD_LOGIC;
    S_AXI_bready : in STD_LOGIC;
    S_AXI_bresp : out STD_LOGIC_VECTOR ( 1 downto 0 );
    S_AXI_bvalid : out STD_LOGIC;
    S_AXI_rdata : out STD_LOGIC_VECTOR ( 31 downto 0 );
    S_AXI_rready : in STD_LOGIC;
    S_AXI_rresp : out STD_LOGIC_VECTOR ( 1 downto 0 );
    S_AXI_rvalid : out STD_LOGIC;
    S_AXI_wdata : in STD_LOGIC_VECTOR ( 31 downto 0 );
    S_AXI_wready : out STD_LOGIC;
    S_AXI_wstrb : in STD_LOGIC_VECTOR ( 3 downto 0 );
    S_AXI_wvalid : in STD_LOGIC
  );
end m00_couplers_imp_1D76A4Z;

architecture STRUCTURE of m00_couplers_imp_1D76A4Z is
  signal \^m_axi_araddr\ : STD_LOGIC_VECTOR ( 31 downto 0 );
  signal \^m_axi_arvalid\ : STD_LOGIC;
  signal \^m_axi_awaddr\ : STD_LOGIC_VECTOR ( 31 downto 0 );
  signal \^m_axi_awvalid\ : STD_LOGIC;
  signal \^m_axi_bready\ : STD_LOGIC;
  signal \^m_axi_rready\ : STD_LOGIC;
  signal \^m_axi_wdata\ : STD_LOGIC_VECTOR ( 31 downto 0 );
  signal \^m_axi_wstrb\ : STD_LOGIC_VECTOR ( 3 downto 0 );
  signal \^m_axi_wvalid\ : STD_LOGIC;
  signal \^s_axi_arready\ : STD_LOGIC;
  signal \^s_axi_awready\ : STD_LOGIC;
  signal \^s_axi_bresp\ : STD_LOGIC_VECTOR ( 1 downto 0 );
  signal \^s_axi_bvalid\ : STD_LOGIC;
  signal \^s_axi_rdata\ : STD_LOGIC_VECTOR ( 31 downto 0 );
  signal \^s_axi_rresp\ : STD_LOGIC_VECTOR ( 1 downto 0 );
  signal \^s_axi_rvalid\ : STD_LOGIC;
  signal \^s_axi_wready\ : STD_LOGIC;
begin
  M_AXI_araddr(31 downto 0) <= \^m_axi_araddr\(31 downto 0);
  M_AXI_arvalid <= \^m_axi_arvalid\;
  M_AXI_awaddr(31 downto 0) <= \^m_axi_awaddr\(31 downto 0);
  M_AXI_awvalid <= \^m_axi_awvalid\;
  M_AXI_bready <= \^m_axi_bready\;
  M_AXI_rready <= \^m_axi_rready\;
  M_AXI_wdata(31 downto 0) <= \^m_axi_wdata\(31 downto 0);
  M_AXI_wstrb(3 downto 0) <= \^m_axi_wstrb\(3 downto 0);
  M_AXI_wvalid <= \^m_axi_wvalid\;
  S_AXI_arready <= \^s_axi_arready\;
  S_AXI_awready <= \^s_axi_awready\;
  S_AXI_bresp(1 downto 0) <= \^s_axi_bresp\(1 downto 0);
  S_AXI_bvalid <= \^s_axi_bvalid\;
  S_AXI_rdata(31 downto 0) <= \^s_axi_rdata\(31 downto 0);
  S_AXI_rresp(1 downto 0) <= \^s_axi_rresp\(1 downto 0);
  S_AXI_rvalid <= \^s_axi_rvalid\;
  S_AXI_wready <= \^s_axi_wready\;
  \^m_axi_araddr\(31 downto 0) <= S_AXI_araddr(31 downto 0);
  \^m_axi_arvalid\ <= S_AXI_arvalid;
  \^m_axi_awaddr\(31 downto 0) <= S_AXI_awaddr(31 downto 0);
  \^m_axi_awvalid\ <= S_AXI_awvalid;
  \^m_axi_bready\ <= S_AXI_bready;
  \^m_axi_rready\ <= S_AXI_rready;
  \^m_axi_wdata\(31 downto 0) <= S_AXI_wdata(31 downto 0);
  \^m_axi_wstrb\(3 downto 0) <= S_AXI_wstrb(3 downto 0);
  \^m_axi_wvalid\ <= S_AXI_wvalid;
  \^s_axi_arready\ <= M_AXI_arready;
  \^s_axi_awready\ <= M_AXI_awready;
  \^s_axi_bresp\(1 downto 0) <= M_AXI_bresp(1 downto 0);
  \^s_axi_bvalid\ <= M_AXI_bvalid;
  \^s_axi_rdata\(31 downto 0) <= M_AXI_rdata(31 downto 0);
  \^s_axi_rresp\(1 downto 0) <= M_AXI_rresp(1 downto 0);
  \^s_axi_rvalid\ <= M_AXI_rvalid;
  \^s_axi_wready\ <= M_AXI_wready;
end STRUCTURE;
library IEEE;
use IEEE.STD_LOGIC_1164.ALL;
library UNISIM;
use UNISIM.VCOMPONENTS.ALL;
entity m01_couplers_imp_CWXMJ1 is
  port (
    M_ACLK : in STD_LOGIC;
    M_ARESETN : in STD_LOGIC;
    M_AXI_araddr : out STD_LOGIC_VECTOR ( 31 downto 0 );
    M_AXI_arready : in STD_LOGIC;
    M_AXI_arvalid : out STD_LOGIC;
    M_AXI_awaddr : out STD_LOGIC_VECTOR ( 31 downto 0 );
    M_AXI_awready : in STD_LOGIC;
    M_AXI_awvalid : out STD_LOGIC;
    M_AXI_bready : out STD_LOGIC;
    M_AXI_bresp : in STD_LOGIC_VECTOR ( 1 downto 0 );
    M_AXI_bvalid : in STD_LOGIC;
    M_AXI_rdata : in STD_LOGIC_VECTOR ( 31 downto 0 );
    M_AXI_rready : out STD_LOGIC;
    M_AXI_rresp : in STD_LOGIC_VECTOR ( 1 downto 0 );
    M_AXI_rvalid : in STD_LOGIC;
    M_AXI_wdata : out STD_LOGIC_VECTOR ( 31 downto 0 );
    M_AXI_wready : in STD_LOGIC;
    M_AXI_wstrb : out STD_LOGIC_VECTOR ( 3 downto 0 );
    M_AXI_wvalid : out STD_LOGIC;
    S_ACLK : in STD_LOGIC;
    S_ARESETN : in STD_LOGIC;
    S_AXI_araddr : in STD_LOGIC_VECTOR ( 31 downto 0 );
    S_AXI_arready : out STD_LOGIC;
    S_AXI_arvalid : in STD_LOGIC;
    S_AXI_awaddr : in STD_LOGIC_VECTOR ( 31 downto 0 );
    S_AXI_awready : out STD_LOGIC;
    S_AXI_awvalid : in STD_LOGIC;
    S_AXI_bready : in STD_LOGIC;
    S_AXI_bresp : out STD_LOGIC_VECTOR ( 1 downto 0 );
    S_AXI_bvalid : out STD_LOGIC;
    S_AXI_rdata : out STD_LOGIC_VECTOR ( 31 downto 0 );
    S_AXI_rready : in STD_LOGIC;
    S_AXI_rresp : out STD_LOGIC_VECTOR ( 1 downto 0 );
    S_AXI_rvalid : out STD_LOGIC;
    S_AXI_wdata : in STD_LOGIC_VECTOR ( 31 downto 0 );
    S_AXI_wready : out STD_LOGIC;
    S_AXI_wstrb : in STD_LOGIC_VECTOR ( 3 downto 0 );
    S_AXI_wvalid : in STD_LOGIC
  );
end m01_couplers_imp_CWXMJ1;

architecture STRUCTURE of m01_couplers_imp_CWXMJ1 is
  signal \^m_axi_araddr\ : STD_LOGIC_VECTOR ( 31 downto 0 );
  signal \^m_axi_arvalid\ : STD_LOGIC;
  signal \^m_axi_awaddr\ : STD_LOGIC_VECTOR ( 31 downto 0 );
  signal \^m_axi_awvalid\ : STD_LOGIC;
  signal \^m_axi_bready\ : STD_LOGIC;
  signal \^m_axi_rready\ : STD_LOGIC;
  signal \^m_axi_wdata\ : STD_LOGIC_VECTOR ( 31 downto 0 );
  signal \^m_axi_wstrb\ : STD_LOGIC_VECTOR ( 3 downto 0 );
  signal \^m_axi_wvalid\ : STD_LOGIC;
  signal \^s_axi_arready\ : STD_LOGIC;
  signal \^s_axi_awready\ : STD_LOGIC;
  signal \^s_axi_bresp\ : STD_LOGIC_VECTOR ( 1 downto 0 );
  signal \^s_axi_bvalid\ : STD_LOGIC;
  signal \^s_axi_rdata\ : STD_LOGIC_VECTOR ( 31 downto 0 );
  signal \^s_axi_rresp\ : STD_LOGIC_VECTOR ( 1 downto 0 );
  signal \^s_axi_rvalid\ : STD_LOGIC;
  signal \^s_axi_wready\ : STD_LOGIC;
begin
  M_AXI_araddr(31 downto 0) <= \^m_axi_araddr\(31 downto 0);
  M_AXI_arvalid <= \^m_axi_arvalid\;
  M_AXI_awaddr(31 downto 0) <= \^m_axi_awaddr\(31 downto 0);
  M_AXI_awvalid <= \^m_axi_awvalid\;
  M_AXI_bready <= \^m_axi_bready\;
  M_AXI_rready <= \^m_axi_rready\;
  M_AXI_wdata(31 downto 0) <= \^m_axi_wdata\(31 downto 0);
  M_AXI_wstrb(3 downto 0) <= \^m_axi_wstrb\(3 downto 0);
  M_AXI_wvalid <= \^m_axi_wvalid\;
  S_AXI_arready <= \^s_axi_arready\;
  S_AXI_awready <= \^s_axi_awready\;
  S_AXI_bresp(1 downto 0) <= \^s_axi_bresp\(1 downto 0);
  S_AXI_bvalid <= \^s_axi_bvalid\;
  S_AXI_rdata(31 downto 0) <= \^s_axi_rdata\(31 downto 0);
  S_AXI_rresp(1 downto 0) <= \^s_axi_rresp\(1 downto 0);
  S_AXI_rvalid <= \^s_axi_rvalid\;
  S_AXI_wready <= \^s_axi_wready\;
  \^m_axi_araddr\(31 downto 0) <= S_AXI_araddr(31 downto 0);
  \^m_axi_arvalid\ <= S_AXI_arvalid;
  \^m_axi_awaddr\(31 downto 0) <= S_AXI_awaddr(31 downto 0);
  \^m_axi_awvalid\ <= S_AXI_awvalid;
  \^m_axi_bready\ <= S_AXI_bready;
  \^m_axi_rready\ <= S_AXI_rready;
  \^m_axi_wdata\(31 downto 0) <= S_AXI_wdata(31 downto 0);
  \^m_axi_wstrb\(3 downto 0) <= S_AXI_wstrb(3 downto 0);
  \^m_axi_wvalid\ <= S_AXI_wvalid;
  \^s_axi_arready\ <= M_AXI_arready;
  \^s_axi_awready\ <= M_AXI_awready;
  \^s_axi_bresp\(1 downto 0) <= M_AXI_bresp(1 downto 0);
  \^s_axi_bvalid\ <= M_AXI_bvalid;
  \^s_axi_rdata\(31 downto 0) <= M_AXI_rdata(31 downto 0);
  \^s_axi_rresp\(1 downto 0) <= M_AXI_rresp(1 downto 0);
  \^s_axi_rvalid\ <= M_AXI_rvalid;
  \^s_axi_wready\ <= M_AXI_wready;
end STRUCTURE;
library IEEE;
use IEEE.STD_LOGIC_1164.ALL;
library UNISIM;
use UNISIM.VCOMPONENTS.ALL;
entity m02_couplers_imp_NQV5BI is
  port (
    M_ACLK : in STD_LOGIC;
    M_ARESETN : in STD_LOGIC;
    M_AXI_araddr : out STD_LOGIC_VECTOR ( 31 downto 0 );
    M_AXI_arready : in STD_LOGIC;
    M_AXI_arvalid : out STD_LOGIC;
    M_AXI_awaddr : out STD_LOGIC_VECTOR ( 31 downto 0 );
    M_AXI_awready : in STD_LOGIC;
    M_AXI_awvalid : out STD_LOGIC;
    M_AXI_bready : out STD_LOGIC;
    M_AXI_bresp : in STD_LOGIC_VECTOR ( 1 downto 0 );
    M_AXI_bvalid : in STD_LOGIC;
    M_AXI_rdata : in STD_LOGIC_VECTOR ( 31 downto 0 );
    M_AXI_rready : out STD_LOGIC;
    M_AXI_rresp : in STD_LOGIC_VECTOR ( 1 downto 0 );
    M_AXI_rvalid : in STD_LOGIC;
    M_AXI_wdata : out STD_LOGIC_VECTOR ( 31 downto 0 );
    M_AXI_wready : in STD_LOGIC;
    M_AXI_wstrb : out STD_LOGIC_VECTOR ( 3 downto 0 );
    M_AXI_wvalid : out STD_LOGIC;
    S_ACLK : in STD_LOGIC;
    S_ARESETN : in STD_LOGIC;
    S_AXI_araddr : in STD_LOGIC_VECTOR ( 31 downto 0 );
    S_AXI_arready : out STD_LOGIC;
    S_AXI_arvalid : in STD_LOGIC;
    S_AXI_awaddr : in STD_LOGIC_VECTOR ( 31 downto 0 );
    S_AXI_awready : out STD_LOGIC;
    S_AXI_awvalid : in STD_LOGIC;
    S_AXI_bready : in STD_LOGIC;
    S_AXI_bresp : out STD_LOGIC_VECTOR ( 1 downto 0 );
    S_AXI_bvalid : out STD_LOGIC;
    S_AXI_rdata : out STD_LOGIC_VECTOR ( 31 downto 0 );
    S_AXI_rready : in STD_LOGIC;
    S_AXI_rresp : out STD_LOGIC_VECTOR ( 1 downto 0 );
    S_AXI_rvalid : out STD_LOGIC;
    S_AXI_wdata : in STD_LOGIC_VECTOR ( 31 downto 0 );
    S_AXI_wready : out STD_LOGIC;
    S_AXI_wstrb : in STD_LOGIC_VECTOR ( 3 downto 0 );
    S_AXI_wvalid : in STD_LOGIC
  );
end m02_couplers_imp_NQV5BI;

architecture STRUCTURE of m02_couplers_imp_NQV5BI is
  signal \^m_axi_araddr\ : STD_LOGIC_VECTOR ( 31 downto 0 );
  signal \^m_axi_arvalid\ : STD_LOGIC;
  signal \^m_axi_awaddr\ : STD_LOGIC_VECTOR ( 31 downto 0 );
  signal \^m_axi_awvalid\ : STD_LOGIC;
  signal \^m_axi_bready\ : STD_LOGIC;
  signal \^m_axi_rready\ : STD_LOGIC;
  signal \^m_axi_wdata\ : STD_LOGIC_VECTOR ( 31 downto 0 );
  signal \^m_axi_wstrb\ : STD_LOGIC_VECTOR ( 3 downto 0 );
  signal \^m_axi_wvalid\ : STD_LOGIC;
  signal \^s_axi_arready\ : STD_LOGIC;
  signal \^s_axi_awready\ : STD_LOGIC;
  signal \^s_axi_bresp\ : STD_LOGIC_VECTOR ( 1 downto 0 );
  signal \^s_axi_bvalid\ : STD_LOGIC;
  signal \^s_axi_rdata\ : STD_LOGIC_VECTOR ( 31 downto 0 );
  signal \^s_axi_rresp\ : STD_LOGIC_VECTOR ( 1 downto 0 );
  signal \^s_axi_rvalid\ : STD_LOGIC;
  signal \^s_axi_wready\ : STD_LOGIC;
begin
  M_AXI_araddr(31 downto 0) <= \^m_axi_araddr\(31 downto 0);
  M_AXI_arvalid <= \^m_axi_arvalid\;
  M_AXI_awaddr(31 downto 0) <= \^m_axi_awaddr\(31 downto 0);
  M_AXI_awvalid <= \^m_axi_awvalid\;
  M_AXI_bready <= \^m_axi_bready\;
  M_AXI_rready <= \^m_axi_rready\;
  M_AXI_wdata(31 downto 0) <= \^m_axi_wdata\(31 downto 0);
  M_AXI_wstrb(3 downto 0) <= \^m_axi_wstrb\(3 downto 0);
  M_AXI_wvalid <= \^m_axi_wvalid\;
  S_AXI_arready <= \^s_axi_arready\;
  S_AXI_awready <= \^s_axi_awready\;
  S_AXI_bresp(1 downto 0) <= \^s_axi_bresp\(1 downto 0);
  S_AXI_bvalid <= \^s_axi_bvalid\;
  S_AXI_rdata(31 downto 0) <= \^s_axi_rdata\(31 downto 0);
  S_AXI_rresp(1 downto 0) <= \^s_axi_rresp\(1 downto 0);
  S_AXI_rvalid <= \^s_axi_rvalid\;
  S_AXI_wready <= \^s_axi_wready\;
  \^m_axi_araddr\(31 downto 0) <= S_AXI_araddr(31 downto 0);
  \^m_axi_arvalid\ <= S_AXI_arvalid;
  \^m_axi_awaddr\(31 downto 0) <= S_AXI_awaddr(31 downto 0);
  \^m_axi_awvalid\ <= S_AXI_awvalid;
  \^m_axi_bready\ <= S_AXI_bready;
  \^m_axi_rready\ <= S_AXI_rready;
  \^m_axi_wdata\(31 downto 0) <= S_AXI_wdata(31 downto 0);
  \^m_axi_wstrb\(3 downto 0) <= S_AXI_wstrb(3 downto 0);
  \^m_axi_wvalid\ <= S_AXI_wvalid;
  \^s_axi_arready\ <= M_AXI_arready;
  \^s_axi_awready\ <= M_AXI_awready;
  \^s_axi_bresp\(1 downto 0) <= M_AXI_bresp(1 downto 0);
  \^s_axi_bvalid\ <= M_AXI_bvalid;
  \^s_axi_rdata\(31 downto 0) <= M_AXI_rdata(31 downto 0);
  \^s_axi_rresp\(1 downto 0) <= M_AXI_rresp(1 downto 0);
  \^s_axi_rvalid\ <= M_AXI_rvalid;
  \^s_axi_wready\ <= M_AXI_wready;
end STRUCTURE;
library IEEE;
use IEEE.STD_LOGIC_1164.ALL;
library UNISIM;
use UNISIM.VCOMPONENTS.ALL;
entity m03_couplers_imp_1K4U0C0 is
  port (
    M_ACLK : in STD_LOGIC;
    M_ARESETN : in STD_LOGIC;
    M_AXI_araddr : out STD_LOGIC_VECTOR ( 31 downto 0 );
    M_AXI_arready : in STD_LOGIC;
    M_AXI_arvalid : out STD_LOGIC;
    M_AXI_awaddr : out STD_LOGIC_VECTOR ( 31 downto 0 );
    M_AXI_awready : in STD_LOGIC;
    M_AXI_awvalid : out STD_LOGIC;
    M_AXI_bready : out STD_LOGIC;
    M_AXI_bresp : in STD_LOGIC_VECTOR ( 1 downto 0 );
    M_AXI_bvalid : in STD_LOGIC;
    M_AXI_rdata : in STD_LOGIC_VECTOR ( 31 downto 0 );
    M_AXI_rready : out STD_LOGIC;
    M_AXI_rresp : in STD_LOGIC_VECTOR ( 1 downto 0 );
    M_AXI_rvalid : in STD_LOGIC;
    M_AXI_wdata : out STD_LOGIC_VECTOR ( 31 downto 0 );
    M_AXI_wready : in STD_LOGIC;
    M_AXI_wstrb : out STD_LOGIC_VECTOR ( 3 downto 0 );
    M_AXI_wvalid : out STD_LOGIC;
    S_ACLK : in STD_LOGIC;
    S_ARESETN : in STD_LOGIC;
    S_AXI_araddr : in STD_LOGIC_VECTOR ( 31 downto 0 );
    S_AXI_arready : out STD_LOGIC;
    S_AXI_arvalid : in STD_LOGIC;
    S_AXI_awaddr : in STD_LOGIC_VECTOR ( 31 downto 0 );
    S_AXI_awready : out STD_LOGIC;
    S_AXI_awvalid : in STD_LOGIC;
    S_AXI_bready : in STD_LOGIC;
    S_AXI_bresp : out STD_LOGIC_VECTOR ( 1 downto 0 );
    S_AXI_bvalid : out STD_LOGIC;
    S_AXI_rdata : out STD_LOGIC_VECTOR ( 31 downto 0 );
    S_AXI_rready : in STD_LOGIC;
    S_AXI_rresp : out STD_LOGIC_VECTOR ( 1 downto 0 );
    S_AXI_rvalid : out STD_LOGIC;
    S_AXI_wdata : in STD_LOGIC_VECTOR ( 31 downto 0 );
    S_AXI_wready : out STD_LOGIC;
    S_AXI_wstrb : in STD_LOGIC_VECTOR ( 3 downto 0 );
    S_AXI_wvalid : in STD_LOGIC
  );
end m03_couplers_imp_1K4U0C0;

architecture STRUCTURE of m03_couplers_imp_1K4U0C0 is
  signal \^m_axi_araddr\ : STD_LOGIC_VECTOR ( 31 downto 0 );
  signal \^m_axi_arvalid\ : STD_LOGIC;
  signal \^m_axi_awaddr\ : STD_LOGIC_VECTOR ( 31 downto 0 );
  signal \^m_axi_awvalid\ : STD_LOGIC;
  signal \^m_axi_bready\ : STD_LOGIC;
  signal \^m_axi_rready\ : STD_LOGIC;
  signal \^m_axi_wdata\ : STD_LOGIC_VECTOR ( 31 downto 0 );
  signal \^m_axi_wstrb\ : STD_LOGIC_VECTOR ( 3 downto 0 );
  signal \^m_axi_wvalid\ : STD_LOGIC;
  signal \^s_axi_arready\ : STD_LOGIC;
  signal \^s_axi_awready\ : STD_LOGIC;
  signal \^s_axi_bresp\ : STD_LOGIC_VECTOR ( 1 downto 0 );
  signal \^s_axi_bvalid\ : STD_LOGIC;
  signal \^s_axi_rdata\ : STD_LOGIC_VECTOR ( 31 downto 0 );
  signal \^s_axi_rresp\ : STD_LOGIC_VECTOR ( 1 downto 0 );
  signal \^s_axi_rvalid\ : STD_LOGIC;
  signal \^s_axi_wready\ : STD_LOGIC;
begin
  M_AXI_araddr(31 downto 0) <= \^m_axi_araddr\(31 downto 0);
  M_AXI_arvalid <= \^m_axi_arvalid\;
  M_AXI_awaddr(31 downto 0) <= \^m_axi_awaddr\(31 downto 0);
  M_AXI_awvalid <= \^m_axi_awvalid\;
  M_AXI_bready <= \^m_axi_bready\;
  M_AXI_rready <= \^m_axi_rready\;
  M_AXI_wdata(31 downto 0) <= \^m_axi_wdata\(31 downto 0);
  M_AXI_wstrb(3 downto 0) <= \^m_axi_wstrb\(3 downto 0);
  M_AXI_wvalid <= \^m_axi_wvalid\;
  S_AXI_arready <= \^s_axi_arready\;
  S_AXI_awready <= \^s_axi_awready\;
  S_AXI_bresp(1 downto 0) <= \^s_axi_bresp\(1 downto 0);
  S_AXI_bvalid <= \^s_axi_bvalid\;
  S_AXI_rdata(31 downto 0) <= \^s_axi_rdata\(31 downto 0);
  S_AXI_rresp(1 downto 0) <= \^s_axi_rresp\(1 downto 0);
  S_AXI_rvalid <= \^s_axi_rvalid\;
  S_AXI_wready <= \^s_axi_wready\;
  \^m_axi_araddr\(31 downto 0) <= S_AXI_araddr(31 downto 0);
  \^m_axi_arvalid\ <= S_AXI_arvalid;
  \^m_axi_awaddr\(31 downto 0) <= S_AXI_awaddr(31 downto 0);
  \^m_axi_awvalid\ <= S_AXI_awvalid;
  \^m_axi_bready\ <= S_AXI_bready;
  \^m_axi_rready\ <= S_AXI_rready;
  \^m_axi_wdata\(31 downto 0) <= S_AXI_wdata(31 downto 0);
  \^m_axi_wstrb\(3 downto 0) <= S_AXI_wstrb(3 downto 0);
  \^m_axi_wvalid\ <= S_AXI_wvalid;
  \^s_axi_arready\ <= M_AXI_arready;
  \^s_axi_awready\ <= M_AXI_awready;
  \^s_axi_bresp\(1 downto 0) <= M_AXI_bresp(1 downto 0);
  \^s_axi_bvalid\ <= M_AXI_bvalid;
  \^s_axi_rdata\(31 downto 0) <= M_AXI_rdata(31 downto 0);
  \^s_axi_rresp\(1 downto 0) <= M_AXI_rresp(1 downto 0);
  \^s_axi_rvalid\ <= M_AXI_rvalid;
  \^s_axi_wready\ <= M_AXI_wready;
end STRUCTURE;
library IEEE;
use IEEE.STD_LOGIC_1164.ALL;
library UNISIM;
use UNISIM.VCOMPONENTS.ALL;
entity m04_couplers_imp_19EQ6W8 is
  port (
    M_ACLK : in STD_LOGIC;
    M_ARESETN : in STD_LOGIC;
    M_AXI_araddr : out STD_LOGIC_VECTOR ( 31 downto 0 );
    M_AXI_arready : in STD_LOGIC;
    M_AXI_arvalid : out STD_LOGIC;
    M_AXI_awaddr : out STD_LOGIC_VECTOR ( 31 downto 0 );
    M_AXI_awready : in STD_LOGIC;
    M_AXI_awvalid : out STD_LOGIC;
    M_AXI_bready : out STD_LOGIC;
    M_AXI_bresp : in STD_LOGIC_VECTOR ( 1 downto 0 );
    M_AXI_bvalid : in STD_LOGIC;
    M_AXI_rdata : in STD_LOGIC_VECTOR ( 31 downto 0 );
    M_AXI_rready : out STD_LOGIC;
    M_AXI_rresp : in STD_LOGIC_VECTOR ( 1 downto 0 );
    M_AXI_rvalid : in STD_LOGIC;
    M_AXI_wdata : out STD_LOGIC_VECTOR ( 31 downto 0 );
    M_AXI_wready : in STD_LOGIC;
    M_AXI_wstrb : out STD_LOGIC_VECTOR ( 3 downto 0 );
    M_AXI_wvalid : out STD_LOGIC;
    S_ACLK : in STD_LOGIC;
    S_ARESETN : in STD_LOGIC;
    S_AXI_araddr : in STD_LOGIC_VECTOR ( 31 downto 0 );
    S_AXI_arready : out STD_LOGIC;
    S_AXI_arvalid : in STD_LOGIC;
    S_AXI_awaddr : in STD_LOGIC_VECTOR ( 31 downto 0 );
    S_AXI_awready : out STD_LOGIC;
    S_AXI_awvalid : in STD_LOGIC;
    S_AXI_bready : in STD_LOGIC;
    S_AXI_bresp : out STD_LOGIC_VECTOR ( 1 downto 0 );
    S_AXI_bvalid : out STD_LOGIC;
    S_AXI_rdata : out STD_LOGIC_VECTOR ( 31 downto 0 );
    S_AXI_rready : in STD_LOGIC;
    S_AXI_rresp : out STD_LOGIC_VECTOR ( 1 downto 0 );
    S_AXI_rvalid : out STD_LOGIC;
    S_AXI_wdata : in STD_LOGIC_VECTOR ( 31 downto 0 );
    S_AXI_wready : out STD_LOGIC;
    S_AXI_wstrb : in STD_LOGIC_VECTOR ( 3 downto 0 );
    S_AXI_wvalid : in STD_LOGIC
  );
end m04_couplers_imp_19EQ6W8;

architecture STRUCTURE of m04_couplers_imp_19EQ6W8 is
  signal \^m_axi_araddr\ : STD_LOGIC_VECTOR ( 31 downto 0 );
  signal \^m_axi_arvalid\ : STD_LOGIC;
  signal \^m_axi_awaddr\ : STD_LOGIC_VECTOR ( 31 downto 0 );
  signal \^m_axi_awvalid\ : STD_LOGIC;
  signal \^m_axi_bready\ : STD_LOGIC;
  signal \^m_axi_rready\ : STD_LOGIC;
  signal \^m_axi_wdata\ : STD_LOGIC_VECTOR ( 31 downto 0 );
  signal \^m_axi_wstrb\ : STD_LOGIC_VECTOR ( 3 downto 0 );
  signal \^m_axi_wvalid\ : STD_LOGIC;
  signal \^s_axi_arready\ : STD_LOGIC;
  signal \^s_axi_awready\ : STD_LOGIC;
  signal \^s_axi_bresp\ : STD_LOGIC_VECTOR ( 1 downto 0 );
  signal \^s_axi_bvalid\ : STD_LOGIC;
  signal \^s_axi_rdata\ : STD_LOGIC_VECTOR ( 31 downto 0 );
  signal \^s_axi_rresp\ : STD_LOGIC_VECTOR ( 1 downto 0 );
  signal \^s_axi_rvalid\ : STD_LOGIC;
  signal \^s_axi_wready\ : STD_LOGIC;
begin
  M_AXI_araddr(31 downto 0) <= \^m_axi_araddr\(31 downto 0);
  M_AXI_arvalid <= \^m_axi_arvalid\;
  M_AXI_awaddr(31 downto 0) <= \^m_axi_awaddr\(31 downto 0);
  M_AXI_awvalid <= \^m_axi_awvalid\;
  M_AXI_bready <= \^m_axi_bready\;
  M_AXI_rready <= \^m_axi_rready\;
  M_AXI_wdata(31 downto 0) <= \^m_axi_wdata\(31 downto 0);
  M_AXI_wstrb(3 downto 0) <= \^m_axi_wstrb\(3 downto 0);
  M_AXI_wvalid <= \^m_axi_wvalid\;
  S_AXI_arready <= \^s_axi_arready\;
  S_AXI_awready <= \^s_axi_awready\;
  S_AXI_bresp(1 downto 0) <= \^s_axi_bresp\(1 downto 0);
  S_AXI_bvalid <= \^s_axi_bvalid\;
  S_AXI_rdata(31 downto 0) <= \^s_axi_rdata\(31 downto 0);
  S_AXI_rresp(1 downto 0) <= \^s_axi_rresp\(1 downto 0);
  S_AXI_rvalid <= \^s_axi_rvalid\;
  S_AXI_wready <= \^s_axi_wready\;
  \^m_axi_araddr\(31 downto 0) <= S_AXI_araddr(31 downto 0);
  \^m_axi_arvalid\ <= S_AXI_arvalid;
  \^m_axi_awaddr\(31 downto 0) <= S_AXI_awaddr(31 downto 0);
  \^m_axi_awvalid\ <= S_AXI_awvalid;
  \^m_axi_bready\ <= S_AXI_bready;
  \^m_axi_rready\ <= S_AXI_rready;
  \^m_axi_wdata\(31 downto 0) <= S_AXI_wdata(31 downto 0);
  \^m_axi_wstrb\(3 downto 0) <= S_AXI_wstrb(3 downto 0);
  \^m_axi_wvalid\ <= S_AXI_wvalid;
  \^s_axi_arready\ <= M_AXI_arready;
  \^s_axi_awready\ <= M_AXI_awready;
  \^s_axi_bresp\(1 downto 0) <= M_AXI_bresp(1 downto 0);
  \^s_axi_bvalid\ <= M_AXI_bvalid;
  \^s_axi_rdata\(31 downto 0) <= M_AXI_rdata(31 downto 0);
  \^s_axi_rresp\(1 downto 0) <= M_AXI_rresp(1 downto 0);
  \^s_axi_rvalid\ <= M_AXI_rvalid;
  \^s_axi_wready\ <= M_AXI_wready;
end STRUCTURE;
library IEEE;
use IEEE.STD_LOGIC_1164.ALL;
library UNISIM;
use UNISIM.VCOMPONENTS.ALL;
entity s00_couplers_imp_PW3YDF is
  port (
    M_ACLK : in STD_LOGIC;
    M_ARESETN : in STD_LOGIC;
    M_AXI_araddr : out STD_LOGIC_VECTOR ( 31 downto 0 );
    M_AXI_arprot : out STD_LOGIC_VECTOR ( 2 downto 0 );
    M_AXI_arready : in STD_LOGIC_VECTOR ( 0 to 0 );
    M_AXI_arvalid : out STD_LOGIC_VECTOR ( 0 to 0 );
    M_AXI_awaddr : out STD_LOGIC_VECTOR ( 31 downto 0 );
    M_AXI_awprot : out STD_LOGIC_VECTOR ( 2 downto 0 );
    M_AXI_awready : in STD_LOGIC_VECTOR ( 0 to 0 );
    M_AXI_awvalid : out STD_LOGIC_VECTOR ( 0 to 0 );
    M_AXI_bready : out STD_LOGIC_VECTOR ( 0 to 0 );
    M_AXI_bresp : in STD_LOGIC_VECTOR ( 1 downto 0 );
    M_AXI_bvalid : in STD_LOGIC_VECTOR ( 0 to 0 );
    M_AXI_rdata : in STD_LOGIC_VECTOR ( 31 downto 0 );
    M_AXI_rready : out STD_LOGIC_VECTOR ( 0 to 0 );
    M_AXI_rresp : in STD_LOGIC_VECTOR ( 1 downto 0 );
    M_AXI_rvalid : in STD_LOGIC_VECTOR ( 0 to 0 );
    M_AXI_wdata : out STD_LOGIC_VECTOR ( 31 downto 0 );
    M_AXI_wready : in STD_LOGIC_VECTOR ( 0 to 0 );
    M_AXI_wstrb : out STD_LOGIC_VECTOR ( 3 downto 0 );
    M_AXI_wvalid : out STD_LOGIC_VECTOR ( 0 to 0 );
    S_ACLK : in STD_LOGIC;
    S_ARESETN : in STD_LOGIC;
    S_AXI_araddr : in STD_LOGIC_VECTOR ( 31 downto 0 );
    S_AXI_arprot : in STD_LOGIC_VECTOR ( 2 downto 0 );
    S_AXI_arready : out STD_LOGIC_VECTOR ( 0 to 0 );
    S_AXI_arvalid : in STD_LOGIC_VECTOR ( 0 to 0 );
    S_AXI_awaddr : in STD_LOGIC_VECTOR ( 31 downto 0 );
    S_AXI_awprot : in STD_LOGIC_VECTOR ( 2 downto 0 );
    S_AXI_awready : out STD_LOGIC_VECTOR ( 0 to 0 );
    S_AXI_awvalid : in STD_LOGIC_VECTOR ( 0 to 0 );
    S_AXI_bready : in STD_LOGIC_VECTOR ( 0 to 0 );
    S_AXI_bresp : out STD_LOGIC_VECTOR ( 1 downto 0 );
    S_AXI_bvalid : out STD_LOGIC_VECTOR ( 0 to 0 );
    S_AXI_rdata : out STD_LOGIC_VECTOR ( 31 downto 0 );
    S_AXI_rready : in STD_LOGIC_VECTOR ( 0 to 0 );
    S_AXI_rresp : out STD_LOGIC_VECTOR ( 1 downto 0 );
    S_AXI_rvalid : out STD_LOGIC_VECTOR ( 0 to 0 );
    S_AXI_wdata : in STD_LOGIC_VECTOR ( 31 downto 0 );
    S_AXI_wready : out STD_LOGIC_VECTOR ( 0 to 0 );
    S_AXI_wstrb : in STD_LOGIC_VECTOR ( 3 downto 0 );
    S_AXI_wvalid : in STD_LOGIC_VECTOR ( 0 to 0 )
  );
end s00_couplers_imp_PW3YDF;

architecture STRUCTURE of s00_couplers_imp_PW3YDF is
  signal \^m_axi_araddr\ : STD_LOGIC_VECTOR ( 31 downto 0 );
  signal \^m_axi_arprot\ : STD_LOGIC_VECTOR ( 2 downto 0 );
  signal \^m_axi_arvalid\ : STD_LOGIC_VECTOR ( 0 to 0 );
  signal \^m_axi_awaddr\ : STD_LOGIC_VECTOR ( 31 downto 0 );
  signal \^m_axi_awprot\ : STD_LOGIC_VECTOR ( 2 downto 0 );
  signal \^m_axi_awvalid\ : STD_LOGIC_VECTOR ( 0 to 0 );
  signal \^m_axi_bready\ : STD_LOGIC_VECTOR ( 0 to 0 );
  signal \^m_axi_rready\ : STD_LOGIC_VECTOR ( 0 to 0 );
  signal \^m_axi_wdata\ : STD_LOGIC_VECTOR ( 31 downto 0 );
  signal \^m_axi_wstrb\ : STD_LOGIC_VECTOR ( 3 downto 0 );
  signal \^m_axi_wvalid\ : STD_LOGIC_VECTOR ( 0 to 0 );
  signal \^s_axi_arready\ : STD_LOGIC_VECTOR ( 0 to 0 );
  signal \^s_axi_awready\ : STD_LOGIC_VECTOR ( 0 to 0 );
  signal \^s_axi_bresp\ : STD_LOGIC_VECTOR ( 1 downto 0 );
  signal \^s_axi_bvalid\ : STD_LOGIC_VECTOR ( 0 to 0 );
  signal \^s_axi_rdata\ : STD_LOGIC_VECTOR ( 31 downto 0 );
  signal \^s_axi_rresp\ : STD_LOGIC_VECTOR ( 1 downto 0 );
  signal \^s_axi_rvalid\ : STD_LOGIC_VECTOR ( 0 to 0 );
  signal \^s_axi_wready\ : STD_LOGIC_VECTOR ( 0 to 0 );
begin
  M_AXI_araddr(31 downto 0) <= \^m_axi_araddr\(31 downto 0);
  M_AXI_arprot(2 downto 0) <= \^m_axi_arprot\(2 downto 0);
  M_AXI_arvalid(0) <= \^m_axi_arvalid\(0);
  M_AXI_awaddr(31 downto 0) <= \^m_axi_awaddr\(31 downto 0);
  M_AXI_awprot(2 downto 0) <= \^m_axi_awprot\(2 downto 0);
  M_AXI_awvalid(0) <= \^m_axi_awvalid\(0);
  M_AXI_bready(0) <= \^m_axi_bready\(0);
  M_AXI_rready(0) <= \^m_axi_rready\(0);
  M_AXI_wdata(31 downto 0) <= \^m_axi_wdata\(31 downto 0);
  M_AXI_wstrb(3 downto 0) <= \^m_axi_wstrb\(3 downto 0);
  M_AXI_wvalid(0) <= \^m_axi_wvalid\(0);
  S_AXI_arready(0) <= \^s_axi_arready\(0);
  S_AXI_awready(0) <= \^s_axi_awready\(0);
  S_AXI_bresp(1 downto 0) <= \^s_axi_bresp\(1 downto 0);
  S_AXI_bvalid(0) <= \^s_axi_bvalid\(0);
  S_AXI_rdata(31 downto 0) <= \^s_axi_rdata\(31 downto 0);
  S_AXI_rresp(1 downto 0) <= \^s_axi_rresp\(1 downto 0);
  S_AXI_rvalid(0) <= \^s_axi_rvalid\(0);
  S_AXI_wready(0) <= \^s_axi_wready\(0);
  \^m_axi_araddr\(31 downto 0) <= S_AXI_araddr(31 downto 0);
  \^m_axi_arprot\(2 downto 0) <= S_AXI_arprot(2 downto 0);
  \^m_axi_arvalid\(0) <= S_AXI_arvalid(0);
  \^m_axi_awaddr\(31 downto 0) <= S_AXI_awaddr(31 downto 0);
  \^m_axi_awprot\(2 downto 0) <= S_AXI_awprot(2 downto 0);
  \^m_axi_awvalid\(0) <= S_AXI_awvalid(0);
  \^m_axi_bready\(0) <= S_AXI_bready(0);
  \^m_axi_rready\(0) <= S_AXI_rready(0);
  \^m_axi_wdata\(31 downto 0) <= S_AXI_wdata(31 downto 0);
  \^m_axi_wstrb\(3 downto 0) <= S_AXI_wstrb(3 downto 0);
  \^m_axi_wvalid\(0) <= S_AXI_wvalid(0);
  \^s_axi_arready\(0) <= M_AXI_arready(0);
  \^s_axi_awready\(0) <= M_AXI_awready(0);
  \^s_axi_bresp\(1 downto 0) <= M_AXI_bresp(1 downto 0);
  \^s_axi_bvalid\(0) <= M_AXI_bvalid(0);
  \^s_axi_rdata\(31 downto 0) <= M_AXI_rdata(31 downto 0);
  \^s_axi_rresp\(1 downto 0) <= M_AXI_rresp(1 downto 0);
  \^s_axi_rvalid\(0) <= M_AXI_rvalid(0);
  \^s_axi_wready\(0) <= M_AXI_wready(0);
end STRUCTURE;
library IEEE;
use IEEE.STD_LOGIC_1164.ALL;
library UNISIM;
use UNISIM.VCOMPONENTS.ALL;
entity cadc_system_axi_interconnect_0_0 is
  port (
    ACLK : in STD_LOGIC;
    ARESETN : in STD_LOGIC;
    M00_ACLK : in STD_LOGIC;
    M00_ARESETN : in STD_LOGIC;
    M00_AXI_araddr : out STD_LOGIC_VECTOR ( 31 downto 0 );
    M00_AXI_arready : in STD_LOGIC;
    M00_AXI_arvalid : out STD_LOGIC;
    M00_AXI_awaddr : out STD_LOGIC_VECTOR ( 31 downto 0 );
    M00_AXI_awready : in STD_LOGIC;
    M00_AXI_awvalid : out STD_LOGIC;
    M00_AXI_bready : out STD_LOGIC;
    M00_AXI_bresp : in STD_LOGIC_VECTOR ( 1 downto 0 );
    M00_AXI_bvalid : in STD_LOGIC;
    M00_AXI_rdata : in STD_LOGIC_VECTOR ( 31 downto 0 );
    M00_AXI_rready : out STD_LOGIC;
    M00_AXI_rresp : in STD_LOGIC_VECTOR ( 1 downto 0 );
    M00_AXI_rvalid : in STD_LOGIC;
    M00_AXI_wdata : out STD_LOGIC_VECTOR ( 31 downto 0 );
    M00_AXI_wready : in STD_LOGIC;
    M00_AXI_wstrb : out STD_LOGIC_VECTOR ( 3 downto 0 );
    M00_AXI_wvalid : out STD_LOGIC;
    M01_ACLK : in STD_LOGIC;
    M01_ARESETN : in STD_LOGIC;
    M01_AXI_araddr : out STD_LOGIC_VECTOR ( 31 downto 0 );
    M01_AXI_arready : in STD_LOGIC;
    M01_AXI_arvalid : out STD_LOGIC;
    M01_AXI_awaddr : out STD_LOGIC_VECTOR ( 31 downto 0 );
    M01_AXI_awready : in STD_LOGIC;
    M01_AXI_awvalid : out STD_LOGIC;
    M01_AXI_bready : out STD_LOGIC;
    M01_AXI_bresp : in STD_LOGIC_VECTOR ( 1 downto 0 );
    M01_AXI_bvalid : in STD_LOGIC;
    M01_AXI_rdata : in STD_LOGIC_VECTOR ( 31 downto 0 );
    M01_AXI_rready : out STD_LOGIC;
    M01_AXI_rresp : in STD_LOGIC_VECTOR ( 1 downto 0 );
    M01_AXI_rvalid : in STD_LOGIC;
    M01_AXI_wdata : out STD_LOGIC_VECTOR ( 31 downto 0 );
    M01_AXI_wready : in STD_LOGIC;
    M01_AXI_wstrb : out STD_LOGIC_VECTOR ( 3 downto 0 );
    M01_AXI_wvalid : out STD_LOGIC;
    M02_ACLK : in STD_LOGIC;
    M02_ARESETN : in STD_LOGIC;
    M02_AXI_araddr : out STD_LOGIC_VECTOR ( 31 downto 0 );
    M02_AXI_arready : in STD_LOGIC;
    M02_AXI_arvalid : out STD_LOGIC;
    M02_AXI_awaddr : out STD_LOGIC_VECTOR ( 31 downto 0 );
    M02_AXI_awready : in STD_LOGIC;
    M02_AXI_awvalid : out STD_LOGIC;
    M02_AXI_bready : out STD_LOGIC;
    M02_AXI_bresp : in STD_LOGIC_VECTOR ( 1 downto 0 );
    M02_AXI_bvalid : in STD_LOGIC;
    M02_AXI_rdata : in STD_LOGIC_VECTOR ( 31 downto 0 );
    M02_AXI_rready : out STD_LOGIC;
    M02_AXI_rresp : in STD_LOGIC_VECTOR ( 1 downto 0 );
    M02_AXI_rvalid : in STD_LOGIC;
    M02_AXI_wdata : out STD_LOGIC_VECTOR ( 31 downto 0 );
    M02_AXI_wready : in STD_LOGIC;
    M02_AXI_wstrb : out STD_LOGIC_VECTOR ( 3 downto 0 );
    M02_AXI_wvalid : out STD_LOGIC;
    M03_ACLK : in STD_LOGIC;
    M03_ARESETN : in STD_LOGIC;
    M03_AXI_araddr : out STD_LOGIC_VECTOR ( 31 downto 0 );
    M03_AXI_arready : in STD_LOGIC;
    M03_AXI_arvalid : out STD_LOGIC;
    M03_AXI_awaddr : out STD_LOGIC_VECTOR ( 31 downto 0 );
    M03_AXI_awready : in STD_LOGIC;
    M03_AXI_awvalid : out STD_LOGIC;
    M03_AXI_bready : out STD_LOGIC;
    M03_AXI_bresp : in STD_LOGIC_VECTOR ( 1 downto 0 );
    M03_AXI_bvalid : in STD_LOGIC;
    M03_AXI_rdata : in STD_LOGIC_VECTOR ( 31 downto 0 );
    M03_AXI_rready : out STD_LOGIC;
    M03_AXI_rresp : in STD_LOGIC_VECTOR ( 1 downto 0 );
    M03_AXI_rvalid : in STD_LOGIC;
    M03_AXI_wdata : out STD_LOGIC_VECTOR ( 31 downto 0 );
    M03_AXI_wready : in STD_LOGIC;
    M03_AXI_wstrb : out STD_LOGIC_VECTOR ( 3 downto 0 );
    M03_AXI_wvalid : out STD_LOGIC;
    M04_ACLK : in STD_LOGIC;
    M04_ARESETN : in STD_LOGIC;
    M04_AXI_araddr : out STD_LOGIC_VECTOR ( 31 downto 0 );
    M04_AXI_arready : in STD_LOGIC;
    M04_AXI_arvalid : out STD_LOGIC;
    M04_AXI_awaddr : out STD_LOGIC_VECTOR ( 31 downto 0 );
    M04_AXI_awready : in STD_LOGIC;
    M04_AXI_awvalid : out STD_LOGIC;
    M04_AXI_bready : out STD_LOGIC;
    M04_AXI_bresp : in STD_LOGIC_VECTOR ( 1 downto 0 );
    M04_AXI_bvalid : in STD_LOGIC;
    M04_AXI_rdata : in STD_LOGIC_VECTOR ( 31 downto 0 );
    M04_AXI_rready : out STD_LOGIC;
    M04_AXI_rresp : in STD_LOGIC_VECTOR ( 1 downto 0 );
    M04_AXI_rvalid : in STD_LOGIC;
    M04_AXI_wdata : out STD_LOGIC_VECTOR ( 31 downto 0 );
    M04_AXI_wready : in STD_LOGIC;
    M04_AXI_wstrb : out STD_LOGIC_VECTOR ( 3 downto 0 );
    M04_AXI_wvalid : out STD_LOGIC;
    S00_ACLK : in STD_LOGIC;
    S00_ARESETN : in STD_LOGIC;
    S00_AXI_araddr : in STD_LOGIC_VECTOR ( 31 downto 0 );
    S00_AXI_arprot : in STD_LOGIC_VECTOR ( 2 downto 0 );
    S00_AXI_arready : out STD_LOGIC_VECTOR ( 0 to 0 );
    S00_AXI_arvalid : in STD_LOGIC_VECTOR ( 0 to 0 );
    S00_AXI_awaddr : in STD_LOGIC_VECTOR ( 31 downto 0 );
    S00_AXI_awprot : in STD_LOGIC_VECTOR ( 2 downto 0 );
    S00_AXI_awready : out STD_LOGIC_VECTOR ( 0 to 0 );
    S00_AXI_awvalid : in STD_LOGIC_VECTOR ( 0 to 0 );
    S00_AXI_bready : in STD_LOGIC_VECTOR ( 0 to 0 );
    S00_AXI_bresp : out STD_LOGIC_VECTOR ( 1 downto 0 );
    S00_AXI_bvalid : out STD_LOGIC_VECTOR ( 0 to 0 );
    S00_AXI_rdata : out STD_LOGIC_VECTOR ( 31 downto 0 );
    S00_AXI_rready : in STD_LOGIC_VECTOR ( 0 to 0 );
    S00_AXI_rresp : out STD_LOGIC_VECTOR ( 1 downto 0 );
    S00_AXI_rvalid : out STD_LOGIC_VECTOR ( 0 to 0 );
    S00_AXI_wdata : in STD_LOGIC_VECTOR ( 31 downto 0 );
    S00_AXI_wready : out STD_LOGIC_VECTOR ( 0 to 0 );
    S00_AXI_wstrb : in STD_LOGIC_VECTOR ( 3 downto 0 );
    S00_AXI_wvalid : in STD_LOGIC_VECTOR ( 0 to 0 )
  );
end cadc_system_axi_interconnect_0_0;

architecture STRUCTURE of cadc_system_axi_interconnect_0_0 is
  component cadc_system_axi_interconnect_0_imp_xbar_0 is
  port (
    aclk : in STD_LOGIC;
    aresetn : in STD_LOGIC;
    s_axi_awaddr : in STD_LOGIC_VECTOR ( 31 downto 0 );
    s_axi_awprot : in STD_LOGIC_VECTOR ( 2 downto 0 );
    s_axi_awvalid : in STD_LOGIC_VECTOR ( 0 to 0 );
    s_axi_awready : out STD_LOGIC_VECTOR ( 0 to 0 );
    s_axi_wdata : in STD_LOGIC_VECTOR ( 31 downto 0 );
    s_axi_wstrb : in STD_LOGIC_VECTOR ( 3 downto 0 );
    s_axi_wvalid : in STD_LOGIC_VECTOR ( 0 to 0 );
    s_axi_wready : out STD_LOGIC_VECTOR ( 0 to 0 );
    s_axi_bresp : out STD_LOGIC_VECTOR ( 1 downto 0 );
    s_axi_bvalid : out STD_LOGIC_VECTOR ( 0 to 0 );
    s_axi_bready : in STD_LOGIC_VECTOR ( 0 to 0 );
    s_axi_araddr : in STD_LOGIC_VECTOR ( 31 downto 0 );
    s_axi_arprot : in STD_LOGIC_VECTOR ( 2 downto 0 );
    s_axi_arvalid : in STD_LOGIC_VECTOR ( 0 to 0 );
    s_axi_arready : out STD_LOGIC_VECTOR ( 0 to 0 );
    s_axi_rdata : out STD_LOGIC_VECTOR ( 31 downto 0 );
    s_axi_rresp : out STD_LOGIC_VECTOR ( 1 downto 0 );
    s_axi_rvalid : out STD_LOGIC_VECTOR ( 0 to 0 );
    s_axi_rready : in STD_LOGIC_VECTOR ( 0 to 0 );
    m_axi_awaddr : out STD_LOGIC_VECTOR ( 159 downto 0 );
    m_axi_awprot : out STD_LOGIC_VECTOR ( 14 downto 0 );
    m_axi_awvalid : out STD_LOGIC_VECTOR ( 4 downto 0 );
    m_axi_awready : in STD_LOGIC_VECTOR ( 4 downto 0 );
    m_axi_wdata : out STD_LOGIC_VECTOR ( 159 downto 0 );
    m_axi_wstrb : out STD_LOGIC_VECTOR ( 19 downto 0 );
    m_axi_wvalid : out STD_LOGIC_VECTOR ( 4 downto 0 );
    m_axi_wready : in STD_LOGIC_VECTOR ( 4 downto 0 );
    m_axi_bresp : in STD_LOGIC_VECTOR ( 9 downto 0 );
    m_axi_bvalid : in STD_LOGIC_VECTOR ( 4 downto 0 );
    m_axi_bready : out STD_LOGIC_VECTOR ( 4 downto 0 );
    m_axi_araddr : out STD_LOGIC_VECTOR ( 159 downto 0 );
    m_axi_arprot : out STD_LOGIC_VECTOR ( 14 downto 0 );
    m_axi_arvalid : out STD_LOGIC_VECTOR ( 4 downto 0 );
    m_axi_arready : in STD_LOGIC_VECTOR ( 4 downto 0 );
    m_axi_rdata : in STD_LOGIC_VECTOR ( 159 downto 0 );
    m_axi_rresp : in STD_LOGIC_VECTOR ( 9 downto 0 );
    m_axi_rvalid : in STD_LOGIC_VECTOR ( 4 downto 0 );
    m_axi_rready : out STD_LOGIC_VECTOR ( 4 downto 0 )
  );
  end component cadc_system_axi_interconnect_0_imp_xbar_0;
  signal s00_couplers_to_xbar_ARADDR : STD_LOGIC_VECTOR ( 31 downto 0 );
  signal s00_couplers_to_xbar_ARPROT : STD_LOGIC_VECTOR ( 2 downto 0 );
  signal s00_couplers_to_xbar_ARREADY : STD_LOGIC_VECTOR ( 0 to 0 );
  signal s00_couplers_to_xbar_ARVALID : STD_LOGIC_VECTOR ( 0 to 0 );
  signal s00_couplers_to_xbar_AWADDR : STD_LOGIC_VECTOR ( 31 downto 0 );
  signal s00_couplers_to_xbar_AWPROT : STD_LOGIC_VECTOR ( 2 downto 0 );
  signal s00_couplers_to_xbar_AWREADY : STD_LOGIC_VECTOR ( 0 to 0 );
  signal s00_couplers_to_xbar_AWVALID : STD_LOGIC_VECTOR ( 0 to 0 );
  signal s00_couplers_to_xbar_BREADY : STD_LOGIC_VECTOR ( 0 to 0 );
  signal s00_couplers_to_xbar_BRESP : STD_LOGIC_VECTOR ( 1 downto 0 );
  signal s00_couplers_to_xbar_BVALID : STD_LOGIC_VECTOR ( 0 to 0 );
  signal s00_couplers_to_xbar_RDATA : STD_LOGIC_VECTOR ( 31 downto 0 );
  signal s00_couplers_to_xbar_RREADY : STD_LOGIC_VECTOR ( 0 to 0 );
  signal s00_couplers_to_xbar_RRESP : STD_LOGIC_VECTOR ( 1 downto 0 );
  signal s00_couplers_to_xbar_RVALID : STD_LOGIC_VECTOR ( 0 to 0 );
  signal s00_couplers_to_xbar_WDATA : STD_LOGIC_VECTOR ( 31 downto 0 );
  signal s00_couplers_to_xbar_WREADY : STD_LOGIC_VECTOR ( 0 to 0 );
  signal s00_couplers_to_xbar_WSTRB : STD_LOGIC_VECTOR ( 3 downto 0 );
  signal s00_couplers_to_xbar_WVALID : STD_LOGIC_VECTOR ( 0 to 0 );
  signal xbar_to_m00_couplers_ARADDR : STD_LOGIC_VECTOR ( 31 downto 0 );
  signal xbar_to_m00_couplers_ARREADY : STD_LOGIC;
  signal xbar_to_m00_couplers_ARVALID : STD_LOGIC_VECTOR ( 0 to 0 );
  signal xbar_to_m00_couplers_AWADDR : STD_LOGIC_VECTOR ( 31 downto 0 );
  signal xbar_to_m00_couplers_AWREADY : STD_LOGIC;
  signal xbar_to_m00_couplers_AWVALID : STD_LOGIC_VECTOR ( 0 to 0 );
  signal xbar_to_m00_couplers_BREADY : STD_LOGIC_VECTOR ( 0 to 0 );
  signal xbar_to_m00_couplers_BRESP : STD_LOGIC_VECTOR ( 1 downto 0 );
  signal xbar_to_m00_couplers_BVALID : STD_LOGIC;
  signal xbar_to_m00_couplers_RDATA : STD_LOGIC_VECTOR ( 31 downto 0 );
  signal xbar_to_m00_couplers_RREADY : STD_LOGIC_VECTOR ( 0 to 0 );
  signal xbar_to_m00_couplers_RRESP : STD_LOGIC_VECTOR ( 1 downto 0 );
  signal xbar_to_m00_couplers_RVALID : STD_LOGIC;
  signal xbar_to_m00_couplers_WDATA : STD_LOGIC_VECTOR ( 31 downto 0 );
  signal xbar_to_m00_couplers_WREADY : STD_LOGIC;
  signal xbar_to_m00_couplers_WSTRB : STD_LOGIC_VECTOR ( 3 downto 0 );
  signal xbar_to_m00_couplers_WVALID : STD_LOGIC_VECTOR ( 0 to 0 );
  signal xbar_to_m01_couplers_ARADDR : STD_LOGIC_VECTOR ( 63 downto 32 );
  signal xbar_to_m01_couplers_ARREADY : STD_LOGIC;
  signal xbar_to_m01_couplers_ARVALID : STD_LOGIC_VECTOR ( 1 to 1 );
  signal xbar_to_m01_couplers_AWADDR : STD_LOGIC_VECTOR ( 63 downto 32 );
  signal xbar_to_m01_couplers_AWREADY : STD_LOGIC;
  signal xbar_to_m01_couplers_AWVALID : STD_LOGIC_VECTOR ( 1 to 1 );
  signal xbar_to_m01_couplers_BREADY : STD_LOGIC_VECTOR ( 1 to 1 );
  signal xbar_to_m01_couplers_BRESP : STD_LOGIC_VECTOR ( 1 downto 0 );
  signal xbar_to_m01_couplers_BVALID : STD_LOGIC;
  signal xbar_to_m01_couplers_RDATA : STD_LOGIC_VECTOR ( 31 downto 0 );
  signal xbar_to_m01_couplers_RREADY : STD_LOGIC_VECTOR ( 1 to 1 );
  signal xbar_to_m01_couplers_RRESP : STD_LOGIC_VECTOR ( 1 downto 0 );
  signal xbar_to_m01_couplers_RVALID : STD_LOGIC;
  signal xbar_to_m01_couplers_WDATA : STD_LOGIC_VECTOR ( 63 downto 32 );
  signal xbar_to_m01_couplers_WREADY : STD_LOGIC;
  signal xbar_to_m01_couplers_WSTRB : STD_LOGIC_VECTOR ( 7 downto 4 );
  signal xbar_to_m01_couplers_WVALID : STD_LOGIC_VECTOR ( 1 to 1 );
  signal xbar_to_m02_couplers_ARADDR : STD_LOGIC_VECTOR ( 95 downto 64 );
  signal xbar_to_m02_couplers_ARREADY : STD_LOGIC;
  signal xbar_to_m02_couplers_ARVALID : STD_LOGIC_VECTOR ( 2 to 2 );
  signal xbar_to_m02_couplers_AWADDR : STD_LOGIC_VECTOR ( 95 downto 64 );
  signal xbar_to_m02_couplers_AWREADY : STD_LOGIC;
  signal xbar_to_m02_couplers_AWVALID : STD_LOGIC_VECTOR ( 2 to 2 );
  signal xbar_to_m02_couplers_BREADY : STD_LOGIC_VECTOR ( 2 to 2 );
  signal xbar_to_m02_couplers_BRESP : STD_LOGIC_VECTOR ( 1 downto 0 );
  signal xbar_to_m02_couplers_BVALID : STD_LOGIC;
  signal xbar_to_m02_couplers_RDATA : STD_LOGIC_VECTOR ( 31 downto 0 );
  signal xbar_to_m02_couplers_RREADY : STD_LOGIC_VECTOR ( 2 to 2 );
  signal xbar_to_m02_couplers_RRESP : STD_LOGIC_VECTOR ( 1 downto 0 );
  signal xbar_to_m02_couplers_RVALID : STD_LOGIC;
  signal xbar_to_m02_couplers_WDATA : STD_LOGIC_VECTOR ( 95 downto 64 );
  signal xbar_to_m02_couplers_WREADY : STD_LOGIC;
  signal xbar_to_m02_couplers_WSTRB : STD_LOGIC_VECTOR ( 11 downto 8 );
  signal xbar_to_m02_couplers_WVALID : STD_LOGIC_VECTOR ( 2 to 2 );
  signal xbar_to_m03_couplers_ARADDR : STD_LOGIC_VECTOR ( 127 downto 96 );
  signal xbar_to_m03_couplers_ARREADY : STD_LOGIC;
  signal xbar_to_m03_couplers_ARVALID : STD_LOGIC_VECTOR ( 3 to 3 );
  signal xbar_to_m03_couplers_AWADDR : STD_LOGIC_VECTOR ( 127 downto 96 );
  signal xbar_to_m03_couplers_AWREADY : STD_LOGIC;
  signal xbar_to_m03_couplers_AWVALID : STD_LOGIC_VECTOR ( 3 to 3 );
  signal xbar_to_m03_couplers_BREADY : STD_LOGIC_VECTOR ( 3 to 3 );
  signal xbar_to_m03_couplers_BRESP : STD_LOGIC_VECTOR ( 1 downto 0 );
  signal xbar_to_m03_couplers_BVALID : STD_LOGIC;
  signal xbar_to_m03_couplers_RDATA : STD_LOGIC_VECTOR ( 31 downto 0 );
  signal xbar_to_m03_couplers_RREADY : STD_LOGIC_VECTOR ( 3 to 3 );
  signal xbar_to_m03_couplers_RRESP : STD_LOGIC_VECTOR ( 1 downto 0 );
  signal xbar_to_m03_couplers_RVALID : STD_LOGIC;
  signal xbar_to_m03_couplers_WDATA : STD_LOGIC_VECTOR ( 127 downto 96 );
  signal xbar_to_m03_couplers_WREADY : STD_LOGIC;
  signal xbar_to_m03_couplers_WSTRB : STD_LOGIC_VECTOR ( 15 downto 12 );
  signal xbar_to_m03_couplers_WVALID : STD_LOGIC_VECTOR ( 3 to 3 );
  signal xbar_to_m04_couplers_ARADDR : STD_LOGIC_VECTOR ( 159 downto 128 );
  signal xbar_to_m04_couplers_ARREADY : STD_LOGIC;
  signal xbar_to_m04_couplers_ARVALID : STD_LOGIC_VECTOR ( 4 to 4 );
  signal xbar_to_m04_couplers_AWADDR : STD_LOGIC_VECTOR ( 159 downto 128 );
  signal xbar_to_m04_couplers_AWREADY : STD_LOGIC;
  signal xbar_to_m04_couplers_AWVALID : STD_LOGIC_VECTOR ( 4 to 4 );
  signal xbar_to_m04_couplers_BREADY : STD_LOGIC_VECTOR ( 4 to 4 );
  signal xbar_to_m04_couplers_BRESP : STD_LOGIC_VECTOR ( 1 downto 0 );
  signal xbar_to_m04_couplers_BVALID : STD_LOGIC;
  signal xbar_to_m04_couplers_RDATA : STD_LOGIC_VECTOR ( 31 downto 0 );
  signal xbar_to_m04_couplers_RREADY : STD_LOGIC_VECTOR ( 4 to 4 );
  signal xbar_to_m04_couplers_RRESP : STD_LOGIC_VECTOR ( 1 downto 0 );
  signal xbar_to_m04_couplers_RVALID : STD_LOGIC;
  signal xbar_to_m04_couplers_WDATA : STD_LOGIC_VECTOR ( 159 downto 128 );
  signal xbar_to_m04_couplers_WREADY : STD_LOGIC;
  signal xbar_to_m04_couplers_WSTRB : STD_LOGIC_VECTOR ( 19 downto 16 );
  signal xbar_to_m04_couplers_WVALID : STD_LOGIC_VECTOR ( 4 to 4 );
  signal NLW_xbar_m_axi_arprot_UNCONNECTED : STD_LOGIC_VECTOR ( 14 downto 0 );
  signal NLW_xbar_m_axi_awprot_UNCONNECTED : STD_LOGIC_VECTOR ( 14 downto 0 );
begin
m00_couplers: entity work.m00_couplers_imp_1D76A4Z
     port map (
      M_ACLK => M00_ACLK,
      M_ARESETN => M00_ARESETN,
      M_AXI_araddr(31 downto 0) => M00_AXI_araddr(31 downto 0),
      M_AXI_arready => M00_AXI_arready,
      M_AXI_arvalid => M00_AXI_arvalid,
      M_AXI_awaddr(31 downto 0) => M00_AXI_awaddr(31 downto 0),
      M_AXI_awready => M00_AXI_awready,
      M_AXI_awvalid => M00_AXI_awvalid,
      M_AXI_bready => M00_AXI_bready,
      M_AXI_bresp(1 downto 0) => M00_AXI_bresp(1 downto 0),
      M_AXI_bvalid => M00_AXI_bvalid,
      M_AXI_rdata(31 downto 0) => M00_AXI_rdata(31 downto 0),
      M_AXI_rready => M00_AXI_rready,
      M_AXI_rresp(1 downto 0) => M00_AXI_rresp(1 downto 0),
      M_AXI_rvalid => M00_AXI_rvalid,
      M_AXI_wdata(31 downto 0) => M00_AXI_wdata(31 downto 0),
      M_AXI_wready => M00_AXI_wready,
      M_AXI_wstrb(3 downto 0) => M00_AXI_wstrb(3 downto 0),
      M_AXI_wvalid => M00_AXI_wvalid,
      S_ACLK => ACLK,
      S_ARESETN => ARESETN,
      S_AXI_araddr(31 downto 0) => xbar_to_m00_couplers_ARADDR(31 downto 0),
      S_AXI_arready => xbar_to_m00_couplers_ARREADY,
      S_AXI_arvalid => xbar_to_m00_couplers_ARVALID(0),
      S_AXI_awaddr(31 downto 0) => xbar_to_m00_couplers_AWADDR(31 downto 0),
      S_AXI_awready => xbar_to_m00_couplers_AWREADY,
      S_AXI_awvalid => xbar_to_m00_couplers_AWVALID(0),
      S_AXI_bready => xbar_to_m00_couplers_BREADY(0),
      S_AXI_bresp(1 downto 0) => xbar_to_m00_couplers_BRESP(1 downto 0),
      S_AXI_bvalid => xbar_to_m00_couplers_BVALID,
      S_AXI_rdata(31 downto 0) => xbar_to_m00_couplers_RDATA(31 downto 0),
      S_AXI_rready => xbar_to_m00_couplers_RREADY(0),
      S_AXI_rresp(1 downto 0) => xbar_to_m00_couplers_RRESP(1 downto 0),
      S_AXI_rvalid => xbar_to_m00_couplers_RVALID,
      S_AXI_wdata(31 downto 0) => xbar_to_m00_couplers_WDATA(31 downto 0),
      S_AXI_wready => xbar_to_m00_couplers_WREADY,
      S_AXI_wstrb(3 downto 0) => xbar_to_m00_couplers_WSTRB(3 downto 0),
      S_AXI_wvalid => xbar_to_m00_couplers_WVALID(0)
    );
m01_couplers: entity work.m01_couplers_imp_CWXMJ1
     port map (
      M_ACLK => M01_ACLK,
      M_ARESETN => M01_ARESETN,
      M_AXI_araddr(31 downto 0) => M01_AXI_araddr(31 downto 0),
      M_AXI_arready => M01_AXI_arready,
      M_AXI_arvalid => M01_AXI_arvalid,
      M_AXI_awaddr(31 downto 0) => M01_AXI_awaddr(31 downto 0),
      M_AXI_awready => M01_AXI_awready,
      M_AXI_awvalid => M01_AXI_awvalid,
      M_AXI_bready => M01_AXI_bready,
      M_AXI_bresp(1 downto 0) => M01_AXI_bresp(1 downto 0),
      M_AXI_bvalid => M01_AXI_bvalid,
      M_AXI_rdata(31 downto 0) => M01_AXI_rdata(31 downto 0),
      M_AXI_rready => M01_AXI_rready,
      M_AXI_rresp(1 downto 0) => M01_AXI_rresp(1 downto 0),
      M_AXI_rvalid => M01_AXI_rvalid,
      M_AXI_wdata(31 downto 0) => M01_AXI_wdata(31 downto 0),
      M_AXI_wready => M01_AXI_wready,
      M_AXI_wstrb(3 downto 0) => M01_AXI_wstrb(3 downto 0),
      M_AXI_wvalid => M01_AXI_wvalid,
      S_ACLK => ACLK,
      S_ARESETN => ARESETN,
      S_AXI_araddr(31 downto 0) => xbar_to_m01_couplers_ARADDR(63 downto 32),
      S_AXI_arready => xbar_to_m01_couplers_ARREADY,
      S_AXI_arvalid => xbar_to_m01_couplers_ARVALID(1),
      S_AXI_awaddr(31 downto 0) => xbar_to_m01_couplers_AWADDR(63 downto 32),
      S_AXI_awready => xbar_to_m01_couplers_AWREADY,
      S_AXI_awvalid => xbar_to_m01_couplers_AWVALID(1),
      S_AXI_bready => xbar_to_m01_couplers_BREADY(1),
      S_AXI_bresp(1 downto 0) => xbar_to_m01_couplers_BRESP(1 downto 0),
      S_AXI_bvalid => xbar_to_m01_couplers_BVALID,
      S_AXI_rdata(31 downto 0) => xbar_to_m01_couplers_RDATA(31 downto 0),
      S_AXI_rready => xbar_to_m01_couplers_RREADY(1),
      S_AXI_rresp(1 downto 0) => xbar_to_m01_couplers_RRESP(1 downto 0),
      S_AXI_rvalid => xbar_to_m01_couplers_RVALID,
      S_AXI_wdata(31 downto 0) => xbar_to_m01_couplers_WDATA(63 downto 32),
      S_AXI_wready => xbar_to_m01_couplers_WREADY,
      S_AXI_wstrb(3 downto 0) => xbar_to_m01_couplers_WSTRB(7 downto 4),
      S_AXI_wvalid => xbar_to_m01_couplers_WVALID(1)
    );
m02_couplers: entity work.m02_couplers_imp_NQV5BI
     port map (
      M_ACLK => M02_ACLK,
      M_ARESETN => M02_ARESETN,
      M_AXI_araddr(31 downto 0) => M02_AXI_araddr(31 downto 0),
      M_AXI_arready => M02_AXI_arready,
      M_AXI_arvalid => M02_AXI_arvalid,
      M_AXI_awaddr(31 downto 0) => M02_AXI_awaddr(31 downto 0),
      M_AXI_awready => M02_AXI_awready,
      M_AXI_awvalid => M02_AXI_awvalid,
      M_AXI_bready => M02_AXI_bready,
      M_AXI_bresp(1 downto 0) => M02_AXI_bresp(1 downto 0),
      M_AXI_bvalid => M02_AXI_bvalid,
      M_AXI_rdata(31 downto 0) => M02_AXI_rdata(31 downto 0),
      M_AXI_rready => M02_AXI_rready,
      M_AXI_rresp(1 downto 0) => M02_AXI_rresp(1 downto 0),
      M_AXI_rvalid => M02_AXI_rvalid,
      M_AXI_wdata(31 downto 0) => M02_AXI_wdata(31 downto 0),
      M_AXI_wready => M02_AXI_wready,
      M_AXI_wstrb(3 downto 0) => M02_AXI_wstrb(3 downto 0),
      M_AXI_wvalid => M02_AXI_wvalid,
      S_ACLK => ACLK,
      S_ARESETN => ARESETN,
      S_AXI_araddr(31 downto 0) => xbar_to_m02_couplers_ARADDR(95 downto 64),
      S_AXI_arready => xbar_to_m02_couplers_ARREADY,
      S_AXI_arvalid => xbar_to_m02_couplers_ARVALID(2),
      S_AXI_awaddr(31 downto 0) => xbar_to_m02_couplers_AWADDR(95 downto 64),
      S_AXI_awready => xbar_to_m02_couplers_AWREADY,
      S_AXI_awvalid => xbar_to_m02_couplers_AWVALID(2),
      S_AXI_bready => xbar_to_m02_couplers_BREADY(2),
      S_AXI_bresp(1 downto 0) => xbar_to_m02_couplers_BRESP(1 downto 0),
      S_AXI_bvalid => xbar_to_m02_couplers_BVALID,
      S_AXI_rdata(31 downto 0) => xbar_to_m02_couplers_RDATA(31 downto 0),
      S_AXI_rready => xbar_to_m02_couplers_RREADY(2),
      S_AXI_rresp(1 downto 0) => xbar_to_m02_couplers_RRESP(1 downto 0),
      S_AXI_rvalid => xbar_to_m02_couplers_RVALID,
      S_AXI_wdata(31 downto 0) => xbar_to_m02_couplers_WDATA(95 downto 64),
      S_AXI_wready => xbar_to_m02_couplers_WREADY,
      S_AXI_wstrb(3 downto 0) => xbar_to_m02_couplers_WSTRB(11 downto 8),
      S_AXI_wvalid => xbar_to_m02_couplers_WVALID(2)
    );
m03_couplers: entity work.m03_couplers_imp_1K4U0C0
     port map (
      M_ACLK => M03_ACLK,
      M_ARESETN => M03_ARESETN,
      M_AXI_araddr(31 downto 0) => M03_AXI_araddr(31 downto 0),
      M_AXI_arready => M03_AXI_arready,
      M_AXI_arvalid => M03_AXI_arvalid,
      M_AXI_awaddr(31 downto 0) => M03_AXI_awaddr(31 downto 0),
      M_AXI_awready => M03_AXI_awready,
      M_AXI_awvalid => M03_AXI_awvalid,
      M_AXI_bready => M03_AXI_bready,
      M_AXI_bresp(1 downto 0) => M03_AXI_bresp(1 downto 0),
      M_AXI_bvalid => M03_AXI_bvalid,
      M_AXI_rdata(31 downto 0) => M03_AXI_rdata(31 downto 0),
      M_AXI_rready => M03_AXI_rready,
      M_AXI_rresp(1 downto 0) => M03_AXI_rresp(1 downto 0),
      M_AXI_rvalid => M03_AXI_rvalid,
      M_AXI_wdata(31 downto 0) => M03_AXI_wdata(31 downto 0),
      M_AXI_wready => M03_AXI_wready,
      M_AXI_wstrb(3 downto 0) => M03_AXI_wstrb(3 downto 0),
      M_AXI_wvalid => M03_AXI_wvalid,
      S_ACLK => ACLK,
      S_ARESETN => ARESETN,
      S_AXI_araddr(31 downto 0) => xbar_to_m03_couplers_ARADDR(127 downto 96),
      S_AXI_arready => xbar_to_m03_couplers_ARREADY,
      S_AXI_arvalid => xbar_to_m03_couplers_ARVALID(3),
      S_AXI_awaddr(31 downto 0) => xbar_to_m03_couplers_AWADDR(127 downto 96),
      S_AXI_awready => xbar_to_m03_couplers_AWREADY,
      S_AXI_awvalid => xbar_to_m03_couplers_AWVALID(3),
      S_AXI_bready => xbar_to_m03_couplers_BREADY(3),
      S_AXI_bresp(1 downto 0) => xbar_to_m03_couplers_BRESP(1 downto 0),
      S_AXI_bvalid => xbar_to_m03_couplers_BVALID,
      S_AXI_rdata(31 downto 0) => xbar_to_m03_couplers_RDATA(31 downto 0),
      S_AXI_rready => xbar_to_m03_couplers_RREADY(3),
      S_AXI_rresp(1 downto 0) => xbar_to_m03_couplers_RRESP(1 downto 0),
      S_AXI_rvalid => xbar_to_m03_couplers_RVALID,
      S_AXI_wdata(31 downto 0) => xbar_to_m03_couplers_WDATA(127 downto 96),
      S_AXI_wready => xbar_to_m03_couplers_WREADY,
      S_AXI_wstrb(3 downto 0) => xbar_to_m03_couplers_WSTRB(15 downto 12),
      S_AXI_wvalid => xbar_to_m03_couplers_WVALID(3)
    );
m04_couplers: entity work.m04_couplers_imp_19EQ6W8
     port map (
      M_ACLK => M04_ACLK,
      M_ARESETN => M04_ARESETN,
      M_AXI_araddr(31 downto 0) => M04_AXI_araddr(31 downto 0),
      M_AXI_arready => M04_AXI_arready,
      M_AXI_arvalid => M04_AXI_arvalid,
      M_AXI_awaddr(31 downto 0) => M04_AXI_awaddr(31 downto 0),
      M_AXI_awready => M04_AXI_awready,
      M_AXI_awvalid => M04_AXI_awvalid,
      M_AXI_bready => M04_AXI_bready,
      M_AXI_bresp(1 downto 0) => M04_AXI_bresp(1 downto 0),
      M_AXI_bvalid => M04_AXI_bvalid,
      M_AXI_rdata(31 downto 0) => M04_AXI_rdata(31 downto 0),
      M_AXI_rready => M04_AXI_rready,
      M_AXI_rresp(1 downto 0) => M04_AXI_rresp(1 downto 0),
      M_AXI_rvalid => M04_AXI_rvalid,
      M_AXI_wdata(31 downto 0) => M04_AXI_wdata(31 downto 0),
      M_AXI_wready => M04_AXI_wready,
      M_AXI_wstrb(3 downto 0) => M04_AXI_wstrb(3 downto 0),
      M_AXI_wvalid => M04_AXI_wvalid,
      S_ACLK => ACLK,
      S_ARESETN => ARESETN,
      S_AXI_araddr(31 downto 0) => xbar_to_m04_couplers_ARADDR(159 downto 128),
      S_AXI_arready => xbar_to_m04_couplers_ARREADY,
      S_AXI_arvalid => xbar_to_m04_couplers_ARVALID(4),
      S_AXI_awaddr(31 downto 0) => xbar_to_m04_couplers_AWADDR(159 downto 128),
      S_AXI_awready => xbar_to_m04_couplers_AWREADY,
      S_AXI_awvalid => xbar_to_m04_couplers_AWVALID(4),
      S_AXI_bready => xbar_to_m04_couplers_BREADY(4),
      S_AXI_bresp(1 downto 0) => xbar_to_m04_couplers_BRESP(1 downto 0),
      S_AXI_bvalid => xbar_to_m04_couplers_BVALID,
      S_AXI_rdata(31 downto 0) => xbar_to_m04_couplers_RDATA(31 downto 0),
      S_AXI_rready => xbar_to_m04_couplers_RREADY(4),
      S_AXI_rresp(1 downto 0) => xbar_to_m04_couplers_RRESP(1 downto 0),
      S_AXI_rvalid => xbar_to_m04_couplers_RVALID,
      S_AXI_wdata(31 downto 0) => xbar_to_m04_couplers_WDATA(159 downto 128),
      S_AXI_wready => xbar_to_m04_couplers_WREADY,
      S_AXI_wstrb(3 downto 0) => xbar_to_m04_couplers_WSTRB(19 downto 16),
      S_AXI_wvalid => xbar_to_m04_couplers_WVALID(4)
    );
s00_couplers: entity work.s00_couplers_imp_PW3YDF
     port map (
      M_ACLK => ACLK,
      M_ARESETN => ARESETN,
      M_AXI_araddr(31 downto 0) => s00_couplers_to_xbar_ARADDR(31 downto 0),
      M_AXI_arprot(2 downto 0) => s00_couplers_to_xbar_ARPROT(2 downto 0),
      M_AXI_arready(0) => s00_couplers_to_xbar_ARREADY(0),
      M_AXI_arvalid(0) => s00_couplers_to_xbar_ARVALID(0),
      M_AXI_awaddr(31 downto 0) => s00_couplers_to_xbar_AWADDR(31 downto 0),
      M_AXI_awprot(2 downto 0) => s00_couplers_to_xbar_AWPROT(2 downto 0),
      M_AXI_awready(0) => s00_couplers_to_xbar_AWREADY(0),
      M_AXI_awvalid(0) => s00_couplers_to_xbar_AWVALID(0),
      M_AXI_bready(0) => s00_couplers_to_xbar_BREADY(0),
      M_AXI_bresp(1 downto 0) => s00_couplers_to_xbar_BRESP(1 downto 0),
      M_AXI_bvalid(0) => s00_couplers_to_xbar_BVALID(0),
      M_AXI_rdata(31 downto 0) => s00_couplers_to_xbar_RDATA(31 downto 0),
      M_AXI_rready(0) => s00_couplers_to_xbar_RREADY(0),
      M_AXI_rresp(1 downto 0) => s00_couplers_to_xbar_RRESP(1 downto 0),
      M_AXI_rvalid(0) => s00_couplers_to_xbar_RVALID(0),
      M_AXI_wdata(31 downto 0) => s00_couplers_to_xbar_WDATA(31 downto 0),
      M_AXI_wready(0) => s00_couplers_to_xbar_WREADY(0),
      M_AXI_wstrb(3 downto 0) => s00_couplers_to_xbar_WSTRB(3 downto 0),
      M_AXI_wvalid(0) => s00_couplers_to_xbar_WVALID(0),
      S_ACLK => S00_ACLK,
      S_ARESETN => S00_ARESETN,
      S_AXI_araddr(31 downto 0) => S00_AXI_araddr(31 downto 0),
      S_AXI_arprot(2 downto 0) => S00_AXI_arprot(2 downto 0),
      S_AXI_arready(0) => S00_AXI_arready(0),
      S_AXI_arvalid(0) => S00_AXI_arvalid(0),
      S_AXI_awaddr(31 downto 0) => S00_AXI_awaddr(31 downto 0),
      S_AXI_awprot(2 downto 0) => S00_AXI_awprot(2 downto 0),
      S_AXI_awready(0) => S00_AXI_awready(0),
      S_AXI_awvalid(0) => S00_AXI_awvalid(0),
      S_AXI_bready(0) => S00_AXI_bready(0),
      S_AXI_bresp(1 downto 0) => S00_AXI_bresp(1 downto 0),
      S_AXI_bvalid(0) => S00_AXI_bvalid(0),
      S_AXI_rdata(31 downto 0) => S00_AXI_rdata(31 downto 0),
      S_AXI_rready(0) => S00_AXI_rready(0),
      S_AXI_rresp(1 downto 0) => S00_AXI_rresp(1 downto 0),
      S_AXI_rvalid(0) => S00_AXI_rvalid(0),
      S_AXI_wdata(31 downto 0) => S00_AXI_wdata(31 downto 0),
      S_AXI_wready(0) => S00_AXI_wready(0),
      S_AXI_wstrb(3 downto 0) => S00_AXI_wstrb(3 downto 0),
      S_AXI_wvalid(0) => S00_AXI_wvalid(0)
    );
xbar: component cadc_system_axi_interconnect_0_imp_xbar_0
     port map (
      aclk => ACLK,
      aresetn => ARESETN,
      m_axi_araddr(159 downto 128) => xbar_to_m04_couplers_ARADDR(159 downto 128),
      m_axi_araddr(127 downto 96) => xbar_to_m03_couplers_ARADDR(127 downto 96),
      m_axi_araddr(95 downto 64) => xbar_to_m02_couplers_ARADDR(95 downto 64),
      m_axi_araddr(63 downto 32) => xbar_to_m01_couplers_ARADDR(63 downto 32),
      m_axi_araddr(31 downto 0) => xbar_to_m00_couplers_ARADDR(31 downto 0),
      m_axi_arprot(14 downto 0) => NLW_xbar_m_axi_arprot_UNCONNECTED(14 downto 0),
      m_axi_arready(4) => xbar_to_m04_couplers_ARREADY,
      m_axi_arready(3) => xbar_to_m03_couplers_ARREADY,
      m_axi_arready(2) => xbar_to_m02_couplers_ARREADY,
      m_axi_arready(1) => xbar_to_m01_couplers_ARREADY,
      m_axi_arready(0) => xbar_to_m00_couplers_ARREADY,
      m_axi_arvalid(4) => xbar_to_m04_couplers_ARVALID(4),
      m_axi_arvalid(3) => xbar_to_m03_couplers_ARVALID(3),
      m_axi_arvalid(2) => xbar_to_m02_couplers_ARVALID(2),
      m_axi_arvalid(1) => xbar_to_m01_couplers_ARVALID(1),
      m_axi_arvalid(0) => xbar_to_m00_couplers_ARVALID(0),
      m_axi_awaddr(159 downto 128) => xbar_to_m04_couplers_AWADDR(159 downto 128),
      m_axi_awaddr(127 downto 96) => xbar_to_m03_couplers_AWADDR(127 downto 96),
      m_axi_awaddr(95 downto 64) => xbar_to_m02_couplers_AWADDR(95 downto 64),
      m_axi_awaddr(63 downto 32) => xbar_to_m01_couplers_AWADDR(63 downto 32),
      m_axi_awaddr(31 downto 0) => xbar_to_m00_couplers_AWADDR(31 downto 0),
      m_axi_awprot(14 downto 0) => NLW_xbar_m_axi_awprot_UNCONNECTED(14 downto 0),
      m_axi_awready(4) => xbar_to_m04_couplers_AWREADY,
      m_axi_awready(3) => xbar_to_m03_couplers_AWREADY,
      m_axi_awready(2) => xbar_to_m02_couplers_AWREADY,
      m_axi_awready(1) => xbar_to_m01_couplers_AWREADY,
      m_axi_awready(0) => xbar_to_m00_couplers_AWREADY,
      m_axi_awvalid(4) => xbar_to_m04_couplers_AWVALID(4),
      m_axi_awvalid(3) => xbar_to_m03_couplers_AWVALID(3),
      m_axi_awvalid(2) => xbar_to_m02_couplers_AWVALID(2),
      m_axi_awvalid(1) => xbar_to_m01_couplers_AWVALID(1),
      m_axi_awvalid(0) => xbar_to_m00_couplers_AWVALID(0),
      m_axi_bready(4) => xbar_to_m04_couplers_BREADY(4),
      m_axi_bready(3) => xbar_to_m03_couplers_BREADY(3),
      m_axi_bready(2) => xbar_to_m02_couplers_BREADY(2),
      m_axi_bready(1) => xbar_to_m01_couplers_BREADY(1),
      m_axi_bready(0) => xbar_to_m00_couplers_BREADY(0),
      m_axi_bresp(9 downto 8) => xbar_to_m04_couplers_BRESP(1 downto 0),
      m_axi_bresp(7 downto 6) => xbar_to_m03_couplers_BRESP(1 downto 0),
      m_axi_bresp(5 downto 4) => xbar_to_m02_couplers_BRESP(1 downto 0),
      m_axi_bresp(3 downto 2) => xbar_to_m01_couplers_BRESP(1 downto 0),
      m_axi_bresp(1 downto 0) => xbar_to_m00_couplers_BRESP(1 downto 0),
      m_axi_bvalid(4) => xbar_to_m04_couplers_BVALID,
      m_axi_bvalid(3) => xbar_to_m03_couplers_BVALID,
      m_axi_bvalid(2) => xbar_to_m02_couplers_BVALID,
      m_axi_bvalid(1) => xbar_to_m01_couplers_BVALID,
      m_axi_bvalid(0) => xbar_to_m00_couplers_BVALID,
      m_axi_rdata(159 downto 128) => xbar_to_m04_couplers_RDATA(31 downto 0),
      m_axi_rdata(127 downto 96) => xbar_to_m03_couplers_RDATA(31 downto 0),
      m_axi_rdata(95 downto 64) => xbar_to_m02_couplers_RDATA(31 downto 0),
      m_axi_rdata(63 downto 32) => xbar_to_m01_couplers_RDATA(31 downto 0),
      m_axi_rdata(31 downto 0) => xbar_to_m00_couplers_RDATA(31 downto 0),
      m_axi_rready(4) => xbar_to_m04_couplers_RREADY(4),
      m_axi_rready(3) => xbar_to_m03_couplers_RREADY(3),
      m_axi_rready(2) => xbar_to_m02_couplers_RREADY(2),
      m_axi_rready(1) => xbar_to_m01_couplers_RREADY(1),
      m_axi_rready(0) => xbar_to_m00_couplers_RREADY(0),
      m_axi_rresp(9 downto 8) => xbar_to_m04_couplers_RRESP(1 downto 0),
      m_axi_rresp(7 downto 6) => xbar_to_m03_couplers_RRESP(1 downto 0),
      m_axi_rresp(5 downto 4) => xbar_to_m02_couplers_RRESP(1 downto 0),
      m_axi_rresp(3 downto 2) => xbar_to_m01_couplers_RRESP(1 downto 0),
      m_axi_rresp(1 downto 0) => xbar_to_m00_couplers_RRESP(1 downto 0),
      m_axi_rvalid(4) => xbar_to_m04_couplers_RVALID,
      m_axi_rvalid(3) => xbar_to_m03_couplers_RVALID,
      m_axi_rvalid(2) => xbar_to_m02_couplers_RVALID,
      m_axi_rvalid(1) => xbar_to_m01_couplers_RVALID,
      m_axi_rvalid(0) => xbar_to_m00_couplers_RVALID,
      m_axi_wdata(159 downto 128) => xbar_to_m04_couplers_WDATA(159 downto 128),
      m_axi_wdata(127 downto 96) => xbar_to_m03_couplers_WDATA(127 downto 96),
      m_axi_wdata(95 downto 64) => xbar_to_m02_couplers_WDATA(95 downto 64),
      m_axi_wdata(63 downto 32) => xbar_to_m01_couplers_WDATA(63 downto 32),
      m_axi_wdata(31 downto 0) => xbar_to_m00_couplers_WDATA(31 downto 0),
      m_axi_wready(4) => xbar_to_m04_couplers_WREADY,
      m_axi_wready(3) => xbar_to_m03_couplers_WREADY,
      m_axi_wready(2) => xbar_to_m02_couplers_WREADY,
      m_axi_wready(1) => xbar_to_m01_couplers_WREADY,
      m_axi_wready(0) => xbar_to_m00_couplers_WREADY,
      m_axi_wstrb(19 downto 16) => xbar_to_m04_couplers_WSTRB(19 downto 16),
      m_axi_wstrb(15 downto 12) => xbar_to_m03_couplers_WSTRB(15 downto 12),
      m_axi_wstrb(11 downto 8) => xbar_to_m02_couplers_WSTRB(11 downto 8),
      m_axi_wstrb(7 downto 4) => xbar_to_m01_couplers_WSTRB(7 downto 4),
      m_axi_wstrb(3 downto 0) => xbar_to_m00_couplers_WSTRB(3 downto 0),
      m_axi_wvalid(4) => xbar_to_m04_couplers_WVALID(4),
      m_axi_wvalid(3) => xbar_to_m03_couplers_WVALID(3),
      m_axi_wvalid(2) => xbar_to_m02_couplers_WVALID(2),
      m_axi_wvalid(1) => xbar_to_m01_couplers_WVALID(1),
      m_axi_wvalid(0) => xbar_to_m00_couplers_WVALID(0),
      s_axi_araddr(31 downto 0) => s00_couplers_to_xbar_ARADDR(31 downto 0),
      s_axi_arprot(2 downto 0) => s00_couplers_to_xbar_ARPROT(2 downto 0),
      s_axi_arready(0) => s00_couplers_to_xbar_ARREADY(0),
      s_axi_arvalid(0) => s00_couplers_to_xbar_ARVALID(0),
      s_axi_awaddr(31 downto 0) => s00_couplers_to_xbar_AWADDR(31 downto 0),
      s_axi_awprot(2 downto 0) => s00_couplers_to_xbar_AWPROT(2 downto 0),
      s_axi_awready(0) => s00_couplers_to_xbar_AWREADY(0),
      s_axi_awvalid(0) => s00_couplers_to_xbar_AWVALID(0),
      s_axi_bready(0) => s00_couplers_to_xbar_BREADY(0),
      s_axi_bresp(1 downto 0) => s00_couplers_to_xbar_BRESP(1 downto 0),
      s_axi_bvalid(0) => s00_couplers_to_xbar_BVALID(0),
      s_axi_rdata(31 downto 0) => s00_couplers_to_xbar_RDATA(31 downto 0),
      s_axi_rready(0) => s00_couplers_to_xbar_RREADY(0),
      s_axi_rresp(1 downto 0) => s00_couplers_to_xbar_RRESP(1 downto 0),
      s_axi_rvalid(0) => s00_couplers_to_xbar_RVALID(0),
      s_axi_wdata(31 downto 0) => s00_couplers_to_xbar_WDATA(31 downto 0),
      s_axi_wready(0) => s00_couplers_to_xbar_WREADY(0),
      s_axi_wstrb(3 downto 0) => s00_couplers_to_xbar_WSTRB(3 downto 0),
      s_axi_wvalid(0) => s00_couplers_to_xbar_WVALID(0)
    );
end STRUCTURE;
library IEEE;
use IEEE.STD_LOGIC_1164.ALL;
library UNISIM;
use UNISIM.VCOMPONENTS.ALL;
entity cadc_system is
  port (
    sys_clk : in STD_LOGIC;
    sys_rst_n : in STD_LOGIC
  );
  attribute CORE_GENERATION_INFO : string;
  attribute CORE_GENERATION_INFO of cadc_system : entity is "cadc_system,IP_Integrator,{x_ipVendor=xilinx.com,x_ipLibrary=BlockDiagram,x_ipName=cadc_system,x_ipVersion=1.00.a,x_ipLanguage=VHDL,numBlks=20,numReposBlks=13,numNonXlnxBlks=0,numHierBlks=7,maxHierDepth=0,numSysgenBlks=0,numHlsBlks=0,numHdlrefBlks=2,numPkgbdBlks=0,bdsource=USER,synth_mode=Hierarchical}";
  attribute HW_HANDOFF : string;
  attribute HW_HANDOFF of cadc_system : entity is "cadc_system.hwdef";
end cadc_system;

architecture STRUCTURE of cadc_system is
  component cadc_system_clk_wiz_0_0 is
  port (
    resetn : in STD_LOGIC;
    clk_in1 : in STD_LOGIC;
    clk_out1 : out STD_LOGIC;
    locked : out STD_LOGIC;
    clk_out2 : out STD_LOGIC
  );
  end component cadc_system_clk_wiz_0_0;
  component cadc_system_proc_sys_reset_0_0 is
  port (
    slowest_sync_clk : in STD_LOGIC;
    ext_reset_in : in STD_LOGIC;
    aux_reset_in : in STD_LOGIC;
    mb_debug_sys_rst : in STD_LOGIC;
    dcm_locked : in STD_LOGIC;
    mb_reset : out STD_LOGIC;
    bus_struct_reset : out STD_LOGIC_VECTOR ( 0 to 0 );
    peripheral_reset : out STD_LOGIC_VECTOR ( 0 to 0 );
    interconnect_aresetn : out STD_LOGIC_VECTOR ( 0 to 0 );
    peripheral_aresetn : out STD_LOGIC_VECTOR ( 0 to 0 )
  );
  end component cadc_system_proc_sys_reset_0_0;
  component cadc_system_jtag_axi_0_0 is
  port (
    aclk : in STD_LOGIC;
    aresetn : in STD_LOGIC;
    m_axi_awaddr : out STD_LOGIC_VECTOR ( 31 downto 0 );
    m_axi_awprot : out STD_LOGIC_VECTOR ( 2 downto 0 );
    m_axi_awvalid : out STD_LOGIC;
    m_axi_awready : in STD_LOGIC;
    m_axi_wdata : out STD_LOGIC_VECTOR ( 31 downto 0 );
    m_axi_wstrb : out STD_LOGIC_VECTOR ( 3 downto 0 );
    m_axi_wvalid : out STD_LOGIC;
    m_axi_wready : in STD_LOGIC;
    m_axi_bresp : in STD_LOGIC_VECTOR ( 1 downto 0 );
    m_axi_bvalid : in STD_LOGIC;
    m_axi_bready : out STD_LOGIC;
    m_axi_araddr : out STD_LOGIC_VECTOR ( 31 downto 0 );
    m_axi_arprot : out STD_LOGIC_VECTOR ( 2 downto 0 );
    m_axi_arvalid : out STD_LOGIC;
    m_axi_arready : in STD_LOGIC;
    m_axi_rdata : in STD_LOGIC_VECTOR ( 31 downto 0 );
    m_axi_rresp : in STD_LOGIC_VECTOR ( 1 downto 0 );
    m_axi_rvalid : in STD_LOGIC;
    m_axi_rready : out STD_LOGIC
  );
  end component cadc_system_jtag_axi_0_0;
  component cadc_system_axi_gpio_ps_0 is
  port (
    s_axi_aclk : in STD_LOGIC;
    s_axi_aresetn : in STD_LOGIC;
    s_axi_awaddr : in STD_LOGIC_VECTOR ( 8 downto 0 );
    s_axi_awvalid : in STD_LOGIC;
    s_axi_awready : out STD_LOGIC;
    s_axi_wdata : in STD_LOGIC_VECTOR ( 31 downto 0 );
    s_axi_wstrb : in STD_LOGIC_VECTOR ( 3 downto 0 );
    s_axi_wvalid : in STD_LOGIC;
    s_axi_wready : out STD_LOGIC;
    s_axi_bresp : out STD_LOGIC_VECTOR ( 1 downto 0 );
    s_axi_bvalid : out STD_LOGIC;
    s_axi_bready : in STD_LOGIC;
    s_axi_araddr : in STD_LOGIC_VECTOR ( 8 downto 0 );
    s_axi_arvalid : in STD_LOGIC;
    s_axi_arready : out STD_LOGIC;
    s_axi_rdata : out STD_LOGIC_VECTOR ( 31 downto 0 );
    s_axi_rresp : out STD_LOGIC_VECTOR ( 1 downto 0 );
    s_axi_rvalid : out STD_LOGIC;
    s_axi_rready : in STD_LOGIC;
    gpio_io_o : out STD_LOGIC_VECTOR ( 19 downto 0 )
  );
  end component cadc_system_axi_gpio_ps_0;
  component cadc_system_axi_gpio_qc_0 is
  port (
    s_axi_aclk : in STD_LOGIC;
    s_axi_aresetn : in STD_LOGIC;
    s_axi_awaddr : in STD_LOGIC_VECTOR ( 8 downto 0 );
    s_axi_awvalid : in STD_LOGIC;
    s_axi_awready : out STD_LOGIC;
    s_axi_wdata : in STD_LOGIC_VECTOR ( 31 downto 0 );
    s_axi_wstrb : in STD_LOGIC_VECTOR ( 3 downto 0 );
    s_axi_wvalid : in STD_LOGIC;
    s_axi_wready : out STD_LOGIC;
    s_axi_bresp : out STD_LOGIC_VECTOR ( 1 downto 0 );
    s_axi_bvalid : out STD_LOGIC;
    s_axi_bready : in STD_LOGIC;
    s_axi_araddr : in STD_LOGIC_VECTOR ( 8 downto 0 );
    s_axi_arvalid : in STD_LOGIC;
    s_axi_arready : out STD_LOGIC;
    s_axi_rdata : out STD_LOGIC_VECTOR ( 31 downto 0 );
    s_axi_rresp : out STD_LOGIC_VECTOR ( 1 downto 0 );
    s_axi_rvalid : out STD_LOGIC;
    s_axi_rready : in STD_LOGIC;
    gpio_io_o : out STD_LOGIC_VECTOR ( 19 downto 0 )
  );
  end component cadc_system_axi_gpio_qc_0;
  component cadc_system_axi_gpio_tat_0 is
  port (
    s_axi_aclk : in STD_LOGIC;
    s_axi_aresetn : in STD_LOGIC;
    s_axi_awaddr : in STD_LOGIC_VECTOR ( 8 downto 0 );
    s_axi_awvalid : in STD_LOGIC;
    s_axi_awready : out STD_LOGIC;
    s_axi_wdata : in STD_LOGIC_VECTOR ( 31 downto 0 );
    s_axi_wstrb : in STD_LOGIC_VECTOR ( 3 downto 0 );
    s_axi_wvalid : in STD_LOGIC;
    s_axi_wready : out STD_LOGIC;
    s_axi_bresp : out STD_LOGIC_VECTOR ( 1 downto 0 );
    s_axi_bvalid : out STD_LOGIC;
    s_axi_bready : in STD_LOGIC;
    s_axi_araddr : in STD_LOGIC_VECTOR ( 8 downto 0 );
    s_axi_arvalid : in STD_LOGIC;
    s_axi_arready : out STD_LOGIC;
    s_axi_rdata : out STD_LOGIC_VECTOR ( 31 downto 0 );
    s_axi_rresp : out STD_LOGIC_VECTOR ( 1 downto 0 );
    s_axi_rvalid : out STD_LOGIC;
    s_axi_rready : in STD_LOGIC;
    gpio_io_o : out STD_LOGIC_VECTOR ( 19 downto 0 )
  );
  end component cadc_system_axi_gpio_tat_0;
  component cadc_system_axi_gpio_analog_0 is
  port (
    s_axi_aclk : in STD_LOGIC;
    s_axi_aresetn : in STD_LOGIC;
    s_axi_awaddr : in STD_LOGIC_VECTOR ( 8 downto 0 );
    s_axi_awvalid : in STD_LOGIC;
    s_axi_awready : out STD_LOGIC;
    s_axi_wdata : in STD_LOGIC_VECTOR ( 31 downto 0 );
    s_axi_wstrb : in STD_LOGIC_VECTOR ( 3 downto 0 );
    s_axi_wvalid : in STD_LOGIC;
    s_axi_wready : out STD_LOGIC;
    s_axi_bresp : out STD_LOGIC_VECTOR ( 1 downto 0 );
    s_axi_bvalid : out STD_LOGIC;
    s_axi_bready : in STD_LOGIC;
    s_axi_araddr : in STD_LOGIC_VECTOR ( 8 downto 0 );
    s_axi_arvalid : in STD_LOGIC;
    s_axi_arready : out STD_LOGIC;
    s_axi_rdata : out STD_LOGIC_VECTOR ( 31 downto 0 );
    s_axi_rresp : out STD_LOGIC_VECTOR ( 1 downto 0 );
    s_axi_rvalid : out STD_LOGIC;
    s_axi_rready : in STD_LOGIC;
    gpio_io_o : out STD_LOGIC_VECTOR ( 19 downto 0 )
  );
  end component cadc_system_axi_gpio_analog_0;
  component cadc_system_axi_gpio_digital_0 is
  port (
    s_axi_aclk : in STD_LOGIC;
    s_axi_aresetn : in STD_LOGIC;
    s_axi_awaddr : in STD_LOGIC_VECTOR ( 8 downto 0 );
    s_axi_awvalid : in STD_LOGIC;
    s_axi_awready : out STD_LOGIC;
    s_axi_wdata : in STD_LOGIC_VECTOR ( 31 downto 0 );
    s_axi_wstrb : in STD_LOGIC_VECTOR ( 3 downto 0 );
    s_axi_wvalid : in STD_LOGIC;
    s_axi_wready : out STD_LOGIC;
    s_axi_bresp : out STD_LOGIC_VECTOR ( 1 downto 0 );
    s_axi_bvalid : out STD_LOGIC;
    s_axi_bready : in STD_LOGIC;
    s_axi_araddr : in STD_LOGIC_VECTOR ( 8 downto 0 );
    s_axi_arvalid : in STD_LOGIC;
    s_axi_arready : out STD_LOGIC;
    s_axi_rdata : out STD_LOGIC_VECTOR ( 31 downto 0 );
    s_axi_rresp : out STD_LOGIC_VECTOR ( 1 downto 0 );
    s_axi_rvalid : out STD_LOGIC;
    s_axi_rready : in STD_LOGIC;
    gpio_io_o : out STD_LOGIC_VECTOR ( 19 downto 0 );
    gpio2_io_o : out STD_LOGIC_VECTOR ( 0 to 0 )
  );
  end component cadc_system_axi_gpio_digital_0;
  component cadc_system_clock_divider_0_0 is
  port (
    i_clk : in STD_LOGIC;
    i_rst_n : in STD_LOGIC;
    o_clk_div : out STD_LOGIC
  );
  end component cadc_system_clock_divider_0_0;
  component cadc_system_cadc_top_0_0 is
  port (
    i_clk_master : in STD_LOGIC;
    i_rst : in STD_LOGIC;
    i_sensor_ps : in STD_LOGIC_VECTOR ( 19 downto 0 );
    i_sensor_qc : in STD_LOGIC_VECTOR ( 19 downto 0 );
    i_sensor_tat : in STD_LOGIC_VECTOR ( 19 downto 0 );
    i_sensor_analog : in STD_LOGIC_VECTOR ( 19 downto 0 );
    i_sensor_digital : in STD_LOGIC_VECTOR ( 19 downto 0 );
    o_out_mach : out STD_LOGIC_VECTOR ( 19 downto 0 );
    o_out_alt : out STD_LOGIC_VECTOR ( 19 downto 0 );
    o_out_airspd : out STD_LOGIC_VECTOR ( 19 downto 0 );
    o_out_vspd : out STD_LOGIC_VECTOR ( 19 downto 0 );
    o_out_wing : out STD_LOGIC_VECTOR ( 19 downto 0 );
    o_out_flap : out STD_LOGIC_VECTOR ( 19 downto 0 );
    o_out_glove : out STD_LOGIC_VECTOR ( 19 downto 0 );
    o_bit_status : out STD_LOGIC;
    i_channel_active : in STD_LOGIC;
    o_fail_detect : out STD_LOGIC
  );
  end component cadc_system_cadc_top_0_0;
  component cadc_system_ila_0_0 is
  port (
    clk : in STD_LOGIC;
    probe0 : in STD_LOGIC_VECTOR ( 19 downto 0 );
    probe1 : in STD_LOGIC_VECTOR ( 31 downto 0 );
    probe2 : in STD_LOGIC_VECTOR ( 1 downto 0 );
    probe3 : in STD_LOGIC_VECTOR ( 19 downto 0 );
    probe4 : in STD_LOGIC_VECTOR ( 19 downto 0 );
    probe5 : in STD_LOGIC_VECTOR ( 31 downto 0 );
    probe6 : in STD_LOGIC_VECTOR ( 19 downto 0 );
    probe7 : in STD_LOGIC_VECTOR ( 0 to 0 );
    probe8 : in STD_LOGIC_VECTOR ( 0 to 0 );
    probe9 : in STD_LOGIC_VECTOR ( 0 to 0 );
    probe10 : in STD_LOGIC_VECTOR ( 31 downto 0 );
    probe11 : in STD_LOGIC_VECTOR ( 0 to 0 );
    probe12 : in STD_LOGIC_VECTOR ( 0 to 0 );
    probe13 : in STD_LOGIC_VECTOR ( 1 downto 0 );
    probe14 : in STD_LOGIC_VECTOR ( 31 downto 0 );
    probe15 : in STD_LOGIC_VECTOR ( 3 downto 0 );
    probe16 : in STD_LOGIC_VECTOR ( 0 to 0 );
    probe17 : in STD_LOGIC_VECTOR ( 2 downto 0 );
    probe18 : in STD_LOGIC_VECTOR ( 2 downto 0 );
    probe19 : in STD_LOGIC_VECTOR ( 0 to 0 );
    probe20 : in STD_LOGIC_VECTOR ( 0 to 0 );
    probe21 : in STD_LOGIC_VECTOR ( 7 downto 0 );
    probe22 : in STD_LOGIC_VECTOR ( 0 to 0 );
    probe23 : in STD_LOGIC_VECTOR ( 2 downto 0 );
    probe24 : in STD_LOGIC_VECTOR ( 1 downto 0 );
    probe25 : in STD_LOGIC_VECTOR ( 0 to 0 );
    probe26 : in STD_LOGIC_VECTOR ( 0 to 0 );
    probe27 : in STD_LOGIC_VECTOR ( 7 downto 0 );
    probe28 : in STD_LOGIC_VECTOR ( 2 downto 0 );
    probe29 : in STD_LOGIC_VECTOR ( 1 downto 0 );
    probe30 : in STD_LOGIC_VECTOR ( 0 to 0 );
    probe31 : in STD_LOGIC_VECTOR ( 3 downto 0 );
    probe32 : in STD_LOGIC_VECTOR ( 3 downto 0 );
    probe33 : in STD_LOGIC_VECTOR ( 3 downto 0 );
    probe34 : in STD_LOGIC_VECTOR ( 3 downto 0 );
    probe35 : in STD_LOGIC_VECTOR ( 0 to 0 );
    probe36 : in STD_LOGIC_VECTOR ( 3 downto 0 );
    probe37 : in STD_LOGIC_VECTOR ( 3 downto 0 );
    probe38 : in STD_LOGIC_VECTOR ( 0 to 0 );
    probe39 : in STD_LOGIC_VECTOR ( 0 to 0 );
    probe40 : in STD_LOGIC_VECTOR ( 0 to 0 );
    probe41 : in STD_LOGIC_VECTOR ( 0 to 0 );
    probe42 : in STD_LOGIC_VECTOR ( 0 to 0 );
    probe43 : in STD_LOGIC_VECTOR ( 0 to 0 )
  );
  end component cadc_system_ila_0_0;
  component cadc_system_util_vector_logic_0_0 is
  port (
    Op1 : in STD_LOGIC_VECTOR ( 0 to 0 );
    Res : out STD_LOGIC_VECTOR ( 0 to 0 )
  );
  end component cadc_system_util_vector_logic_0_0;
  signal axi_gpio_analog_gpio_io_o : STD_LOGIC_VECTOR ( 19 downto 0 );
  signal axi_gpio_digital_gpio2_io_o : STD_LOGIC_VECTOR ( 0 to 0 );
  signal axi_gpio_digital_gpio_io_o : STD_LOGIC_VECTOR ( 19 downto 0 );
  signal axi_gpio_ps_gpio_io_o : STD_LOGIC_VECTOR ( 19 downto 0 );
  signal axi_gpio_qc_gpio_io_o : STD_LOGIC_VECTOR ( 19 downto 0 );
  signal axi_gpio_tat_gpio_io_o : STD_LOGIC_VECTOR ( 19 downto 0 );
  signal axi_interconnect_0_M00_AXI_ARADDR : STD_LOGIC_VECTOR ( 31 downto 0 );
  signal axi_interconnect_0_M00_AXI_ARREADY : STD_LOGIC;
  signal axi_interconnect_0_M00_AXI_ARVALID : STD_LOGIC;
  signal axi_interconnect_0_M00_AXI_AWADDR : STD_LOGIC_VECTOR ( 31 downto 0 );
  signal axi_interconnect_0_M00_AXI_AWREADY : STD_LOGIC;
  signal axi_interconnect_0_M00_AXI_AWVALID : STD_LOGIC;
  signal axi_interconnect_0_M00_AXI_BREADY : STD_LOGIC;
  signal axi_interconnect_0_M00_AXI_BRESP : STD_LOGIC_VECTOR ( 1 downto 0 );
  signal axi_interconnect_0_M00_AXI_BVALID : STD_LOGIC;
  signal axi_interconnect_0_M00_AXI_RDATA : STD_LOGIC_VECTOR ( 31 downto 0 );
  signal axi_interconnect_0_M00_AXI_RREADY : STD_LOGIC;
  signal axi_interconnect_0_M00_AXI_RRESP : STD_LOGIC_VECTOR ( 1 downto 0 );
  signal axi_interconnect_0_M00_AXI_RVALID : STD_LOGIC;
  signal axi_interconnect_0_M00_AXI_WDATA : STD_LOGIC_VECTOR ( 31 downto 0 );
  signal axi_interconnect_0_M00_AXI_WREADY : STD_LOGIC;
  signal axi_interconnect_0_M00_AXI_WSTRB : STD_LOGIC_VECTOR ( 3 downto 0 );
  signal axi_interconnect_0_M00_AXI_WVALID : STD_LOGIC;
  signal axi_interconnect_0_M01_AXI_ARADDR : STD_LOGIC_VECTOR ( 31 downto 0 );
  signal axi_interconnect_0_M01_AXI_ARREADY : STD_LOGIC;
  signal axi_interconnect_0_M01_AXI_ARVALID : STD_LOGIC;
  signal axi_interconnect_0_M01_AXI_AWADDR : STD_LOGIC_VECTOR ( 31 downto 0 );
  signal axi_interconnect_0_M01_AXI_AWREADY : STD_LOGIC;
  signal axi_interconnect_0_M01_AXI_AWVALID : STD_LOGIC;
  signal axi_interconnect_0_M01_AXI_BREADY : STD_LOGIC;
  signal axi_interconnect_0_M01_AXI_BRESP : STD_LOGIC_VECTOR ( 1 downto 0 );
  signal axi_interconnect_0_M01_AXI_BVALID : STD_LOGIC;
  signal axi_interconnect_0_M01_AXI_RDATA : STD_LOGIC_VECTOR ( 31 downto 0 );
  signal axi_interconnect_0_M01_AXI_RREADY : STD_LOGIC;
  signal axi_interconnect_0_M01_AXI_RRESP : STD_LOGIC_VECTOR ( 1 downto 0 );
  signal axi_interconnect_0_M01_AXI_RVALID : STD_LOGIC;
  signal axi_interconnect_0_M01_AXI_WDATA : STD_LOGIC_VECTOR ( 31 downto 0 );
  signal axi_interconnect_0_M01_AXI_WREADY : STD_LOGIC;
  signal axi_interconnect_0_M01_AXI_WSTRB : STD_LOGIC_VECTOR ( 3 downto 0 );
  signal axi_interconnect_0_M01_AXI_WVALID : STD_LOGIC;
  signal axi_interconnect_0_M02_AXI_ARADDR : STD_LOGIC_VECTOR ( 31 downto 0 );
  signal axi_interconnect_0_M02_AXI_ARREADY : STD_LOGIC;
  signal axi_interconnect_0_M02_AXI_ARVALID : STD_LOGIC;
  signal axi_interconnect_0_M02_AXI_AWADDR : STD_LOGIC_VECTOR ( 31 downto 0 );
  signal axi_interconnect_0_M02_AXI_AWREADY : STD_LOGIC;
  signal axi_interconnect_0_M02_AXI_AWVALID : STD_LOGIC;
  signal axi_interconnect_0_M02_AXI_BREADY : STD_LOGIC;
  signal axi_interconnect_0_M02_AXI_BRESP : STD_LOGIC_VECTOR ( 1 downto 0 );
  signal axi_interconnect_0_M02_AXI_BVALID : STD_LOGIC;
  signal axi_interconnect_0_M02_AXI_RDATA : STD_LOGIC_VECTOR ( 31 downto 0 );
  signal axi_interconnect_0_M02_AXI_RREADY : STD_LOGIC;
  signal axi_interconnect_0_M02_AXI_RRESP : STD_LOGIC_VECTOR ( 1 downto 0 );
  signal axi_interconnect_0_M02_AXI_RVALID : STD_LOGIC;
  signal axi_interconnect_0_M02_AXI_WDATA : STD_LOGIC_VECTOR ( 31 downto 0 );
  signal axi_interconnect_0_M02_AXI_WREADY : STD_LOGIC;
  signal axi_interconnect_0_M02_AXI_WSTRB : STD_LOGIC_VECTOR ( 3 downto 0 );
  signal axi_interconnect_0_M02_AXI_WVALID : STD_LOGIC;
  signal axi_interconnect_0_M03_AXI_ARADDR : STD_LOGIC_VECTOR ( 31 downto 0 );
  signal axi_interconnect_0_M03_AXI_ARREADY : STD_LOGIC;
  signal axi_interconnect_0_M03_AXI_ARVALID : STD_LOGIC;
  signal axi_interconnect_0_M03_AXI_AWADDR : STD_LOGIC_VECTOR ( 31 downto 0 );
  signal axi_interconnect_0_M03_AXI_AWREADY : STD_LOGIC;
  signal axi_interconnect_0_M03_AXI_AWVALID : STD_LOGIC;
  signal axi_interconnect_0_M03_AXI_BREADY : STD_LOGIC;
  signal axi_interconnect_0_M03_AXI_BRESP : STD_LOGIC_VECTOR ( 1 downto 0 );
  signal axi_interconnect_0_M03_AXI_BVALID : STD_LOGIC;
  signal axi_interconnect_0_M03_AXI_RDATA : STD_LOGIC_VECTOR ( 31 downto 0 );
  signal axi_interconnect_0_M03_AXI_RREADY : STD_LOGIC;
  signal axi_interconnect_0_M03_AXI_RRESP : STD_LOGIC_VECTOR ( 1 downto 0 );
  signal axi_interconnect_0_M03_AXI_RVALID : STD_LOGIC;
  signal axi_interconnect_0_M03_AXI_WDATA : STD_LOGIC_VECTOR ( 31 downto 0 );
  signal axi_interconnect_0_M03_AXI_WREADY : STD_LOGIC;
  signal axi_interconnect_0_M03_AXI_WSTRB : STD_LOGIC_VECTOR ( 3 downto 0 );
  signal axi_interconnect_0_M03_AXI_WVALID : STD_LOGIC;
  signal axi_interconnect_0_M04_AXI_ARADDR : STD_LOGIC_VECTOR ( 31 downto 0 );
  signal axi_interconnect_0_M04_AXI_ARREADY : STD_LOGIC;
  signal axi_interconnect_0_M04_AXI_ARVALID : STD_LOGIC;
  signal axi_interconnect_0_M04_AXI_AWADDR : STD_LOGIC_VECTOR ( 31 downto 0 );
  signal axi_interconnect_0_M04_AXI_AWREADY : STD_LOGIC;
  signal axi_interconnect_0_M04_AXI_AWVALID : STD_LOGIC;
  signal axi_interconnect_0_M04_AXI_BREADY : STD_LOGIC;
  signal axi_interconnect_0_M04_AXI_BRESP : STD_LOGIC_VECTOR ( 1 downto 0 );
  signal axi_interconnect_0_M04_AXI_BVALID : STD_LOGIC;
  signal axi_interconnect_0_M04_AXI_RDATA : STD_LOGIC_VECTOR ( 31 downto 0 );
  signal axi_interconnect_0_M04_AXI_RREADY : STD_LOGIC;
  signal axi_interconnect_0_M04_AXI_RRESP : STD_LOGIC_VECTOR ( 1 downto 0 );
  signal axi_interconnect_0_M04_AXI_RVALID : STD_LOGIC;
  signal axi_interconnect_0_M04_AXI_WDATA : STD_LOGIC_VECTOR ( 31 downto 0 );
  signal axi_interconnect_0_M04_AXI_WREADY : STD_LOGIC;
  signal axi_interconnect_0_M04_AXI_WSTRB : STD_LOGIC_VECTOR ( 3 downto 0 );
  signal axi_interconnect_0_M04_AXI_WVALID : STD_LOGIC;
  signal cadc_top_0_o_bit_status : STD_LOGIC;
  signal cadc_top_0_o_fail_detect : STD_LOGIC;
  signal cadc_top_0_o_out_airspd : STD_LOGIC_VECTOR ( 19 downto 0 );
  signal cadc_top_0_o_out_alt : STD_LOGIC_VECTOR ( 19 downto 0 );
  signal cadc_top_0_o_out_flap : STD_LOGIC_VECTOR ( 19 downto 0 );
  signal cadc_top_0_o_out_glove : STD_LOGIC_VECTOR ( 19 downto 0 );
  signal cadc_top_0_o_out_mach : STD_LOGIC_VECTOR ( 19 downto 0 );
  signal cadc_top_0_o_out_vspd : STD_LOGIC_VECTOR ( 19 downto 0 );
  signal cadc_top_0_o_out_wing : STD_LOGIC_VECTOR ( 19 downto 0 );
  signal clk_wiz_0_clk_out1 : STD_LOGIC;
  signal clk_wiz_0_clk_out2 : STD_LOGIC;
  signal clk_wiz_0_locked : STD_LOGIC;
  signal clock_divider_0_o_clk_div : STD_LOGIC;
  signal jtag_axi_0_M_AXI_ARADDR : STD_LOGIC_VECTOR ( 31 downto 0 );
  signal jtag_axi_0_M_AXI_ARPROT : STD_LOGIC_VECTOR ( 2 downto 0 );
  signal jtag_axi_0_M_AXI_ARREADY : STD_LOGIC_VECTOR ( 0 to 0 );
  signal jtag_axi_0_M_AXI_ARVALID : STD_LOGIC;
  signal jtag_axi_0_M_AXI_AWADDR : STD_LOGIC_VECTOR ( 31 downto 0 );
  signal jtag_axi_0_M_AXI_AWPROT : STD_LOGIC_VECTOR ( 2 downto 0 );
  signal jtag_axi_0_M_AXI_AWREADY : STD_LOGIC_VECTOR ( 0 to 0 );
  signal jtag_axi_0_M_AXI_AWVALID : STD_LOGIC;
  signal jtag_axi_0_M_AXI_BREADY : STD_LOGIC;
  signal jtag_axi_0_M_AXI_BRESP : STD_LOGIC_VECTOR ( 1 downto 0 );
  signal jtag_axi_0_M_AXI_BVALID : STD_LOGIC_VECTOR ( 0 to 0 );
  signal jtag_axi_0_M_AXI_RDATA : STD_LOGIC_VECTOR ( 31 downto 0 );
  signal jtag_axi_0_M_AXI_RREADY : STD_LOGIC;
  signal jtag_axi_0_M_AXI_RRESP : STD_LOGIC_VECTOR ( 1 downto 0 );
  signal jtag_axi_0_M_AXI_RVALID : STD_LOGIC_VECTOR ( 0 to 0 );
  signal jtag_axi_0_M_AXI_WDATA : STD_LOGIC_VECTOR ( 31 downto 0 );
  signal jtag_axi_0_M_AXI_WREADY : STD_LOGIC_VECTOR ( 0 to 0 );
  signal jtag_axi_0_M_AXI_WSTRB : STD_LOGIC_VECTOR ( 3 downto 0 );
  signal jtag_axi_0_M_AXI_WVALID : STD_LOGIC;
  signal proc_sys_reset_0_interconnect_aresetn : STD_LOGIC_VECTOR ( 0 to 0 );
  signal proc_sys_reset_0_peripheral_aresetn : STD_LOGIC_VECTOR ( 0 to 0 );
  signal util_vector_logic_0_Res : STD_LOGIC_VECTOR ( 0 to 0 );
  signal NLW_proc_sys_reset_0_mb_reset_UNCONNECTED : STD_LOGIC;
  signal NLW_proc_sys_reset_0_bus_struct_reset_UNCONNECTED : STD_LOGIC_VECTOR ( 0 to 0 );
  signal NLW_proc_sys_reset_0_peripheral_reset_UNCONNECTED : STD_LOGIC_VECTOR ( 0 to 0 );
  attribute X_INTERFACE_INFO : string;
  attribute X_INTERFACE_INFO of sys_clk : signal is "xilinx.com:signal:clock:1.0 CLK.SYS_CLK CLK";
  attribute X_INTERFACE_PARAMETER : string;
  attribute X_INTERFACE_PARAMETER of sys_clk : signal is "XIL_INTERFACENAME CLK.SYS_CLK, CLK_DOMAIN cadc_system_sys_clk, FREQ_HZ 12000000, FREQ_TOLERANCE_HZ 0, INSERT_VIP 0, PHASE 0.0";
  attribute X_INTERFACE_INFO of sys_rst_n : signal is "xilinx.com:signal:reset:1.0 RST.SYS_RST_N RST";
  attribute X_INTERFACE_PARAMETER of sys_rst_n : signal is "XIL_INTERFACENAME RST.SYS_RST_N, INSERT_VIP 0, POLARITY ACTIVE_LOW";
begin
axi_gpio_analog: component cadc_system_axi_gpio_analog_0
     port map (
      gpio_io_o(19 downto 0) => axi_gpio_analog_gpio_io_o(19 downto 0),
      s_axi_aclk => clk_wiz_0_clk_out1,
      s_axi_araddr(8 downto 0) => axi_interconnect_0_M03_AXI_ARADDR(8 downto 0),
      s_axi_aresetn => proc_sys_reset_0_peripheral_aresetn(0),
      s_axi_arready => axi_interconnect_0_M03_AXI_ARREADY,
      s_axi_arvalid => axi_interconnect_0_M03_AXI_ARVALID,
      s_axi_awaddr(8 downto 0) => axi_interconnect_0_M03_AXI_AWADDR(8 downto 0),
      s_axi_awready => axi_interconnect_0_M03_AXI_AWREADY,
      s_axi_awvalid => axi_interconnect_0_M03_AXI_AWVALID,
      s_axi_bready => axi_interconnect_0_M03_AXI_BREADY,
      s_axi_bresp(1 downto 0) => axi_interconnect_0_M03_AXI_BRESP(1 downto 0),
      s_axi_bvalid => axi_interconnect_0_M03_AXI_BVALID,
      s_axi_rdata(31 downto 0) => axi_interconnect_0_M03_AXI_RDATA(31 downto 0),
      s_axi_rready => axi_interconnect_0_M03_AXI_RREADY,
      s_axi_rresp(1 downto 0) => axi_interconnect_0_M03_AXI_RRESP(1 downto 0),
      s_axi_rvalid => axi_interconnect_0_M03_AXI_RVALID,
      s_axi_wdata(31 downto 0) => axi_interconnect_0_M03_AXI_WDATA(31 downto 0),
      s_axi_wready => axi_interconnect_0_M03_AXI_WREADY,
      s_axi_wstrb(3 downto 0) => axi_interconnect_0_M03_AXI_WSTRB(3 downto 0),
      s_axi_wvalid => axi_interconnect_0_M03_AXI_WVALID
    );
axi_gpio_digital: component cadc_system_axi_gpio_digital_0
     port map (
      gpio2_io_o(0) => axi_gpio_digital_gpio2_io_o(0),
      gpio_io_o(19 downto 0) => axi_gpio_digital_gpio_io_o(19 downto 0),
      s_axi_aclk => clk_wiz_0_clk_out1,
      s_axi_araddr(8 downto 0) => axi_interconnect_0_M04_AXI_ARADDR(8 downto 0),
      s_axi_aresetn => proc_sys_reset_0_peripheral_aresetn(0),
      s_axi_arready => axi_interconnect_0_M04_AXI_ARREADY,
      s_axi_arvalid => axi_interconnect_0_M04_AXI_ARVALID,
      s_axi_awaddr(8 downto 0) => axi_interconnect_0_M04_AXI_AWADDR(8 downto 0),
      s_axi_awready => axi_interconnect_0_M04_AXI_AWREADY,
      s_axi_awvalid => axi_interconnect_0_M04_AXI_AWVALID,
      s_axi_bready => axi_interconnect_0_M04_AXI_BREADY,
      s_axi_bresp(1 downto 0) => axi_interconnect_0_M04_AXI_BRESP(1 downto 0),
      s_axi_bvalid => axi_interconnect_0_M04_AXI_BVALID,
      s_axi_rdata(31 downto 0) => axi_interconnect_0_M04_AXI_RDATA(31 downto 0),
      s_axi_rready => axi_interconnect_0_M04_AXI_RREADY,
      s_axi_rresp(1 downto 0) => axi_interconnect_0_M04_AXI_RRESP(1 downto 0),
      s_axi_rvalid => axi_interconnect_0_M04_AXI_RVALID,
      s_axi_wdata(31 downto 0) => axi_interconnect_0_M04_AXI_WDATA(31 downto 0),
      s_axi_wready => axi_interconnect_0_M04_AXI_WREADY,
      s_axi_wstrb(3 downto 0) => axi_interconnect_0_M04_AXI_WSTRB(3 downto 0),
      s_axi_wvalid => axi_interconnect_0_M04_AXI_WVALID
    );
axi_gpio_ps: component cadc_system_axi_gpio_ps_0
     port map (
      gpio_io_o(19 downto 0) => axi_gpio_ps_gpio_io_o(19 downto 0),
      s_axi_aclk => clk_wiz_0_clk_out1,
      s_axi_araddr(8 downto 0) => axi_interconnect_0_M00_AXI_ARADDR(8 downto 0),
      s_axi_aresetn => proc_sys_reset_0_peripheral_aresetn(0),
      s_axi_arready => axi_interconnect_0_M00_AXI_ARREADY,
      s_axi_arvalid => axi_interconnect_0_M00_AXI_ARVALID,
      s_axi_awaddr(8 downto 0) => axi_interconnect_0_M00_AXI_AWADDR(8 downto 0),
      s_axi_awready => axi_interconnect_0_M00_AXI_AWREADY,
      s_axi_awvalid => axi_interconnect_0_M00_AXI_AWVALID,
      s_axi_bready => axi_interconnect_0_M00_AXI_BREADY,
      s_axi_bresp(1 downto 0) => axi_interconnect_0_M00_AXI_BRESP(1 downto 0),
      s_axi_bvalid => axi_interconnect_0_M00_AXI_BVALID,
      s_axi_rdata(31 downto 0) => axi_interconnect_0_M00_AXI_RDATA(31 downto 0),
      s_axi_rready => axi_interconnect_0_M00_AXI_RREADY,
      s_axi_rresp(1 downto 0) => axi_interconnect_0_M00_AXI_RRESP(1 downto 0),
      s_axi_rvalid => axi_interconnect_0_M00_AXI_RVALID,
      s_axi_wdata(31 downto 0) => axi_interconnect_0_M00_AXI_WDATA(31 downto 0),
      s_axi_wready => axi_interconnect_0_M00_AXI_WREADY,
      s_axi_wstrb(3 downto 0) => axi_interconnect_0_M00_AXI_WSTRB(3 downto 0),
      s_axi_wvalid => axi_interconnect_0_M00_AXI_WVALID
    );
axi_gpio_qc: component cadc_system_axi_gpio_qc_0
     port map (
      gpio_io_o(19 downto 0) => axi_gpio_qc_gpio_io_o(19 downto 0),
      s_axi_aclk => clk_wiz_0_clk_out1,
      s_axi_araddr(8 downto 0) => axi_interconnect_0_M01_AXI_ARADDR(8 downto 0),
      s_axi_aresetn => proc_sys_reset_0_peripheral_aresetn(0),
      s_axi_arready => axi_interconnect_0_M01_AXI_ARREADY,
      s_axi_arvalid => axi_interconnect_0_M01_AXI_ARVALID,
      s_axi_awaddr(8 downto 0) => axi_interconnect_0_M01_AXI_AWADDR(8 downto 0),
      s_axi_awready => axi_interconnect_0_M01_AXI_AWREADY,
      s_axi_awvalid => axi_interconnect_0_M01_AXI_AWVALID,
      s_axi_bready => axi_interconnect_0_M01_AXI_BREADY,
      s_axi_bresp(1 downto 0) => axi_interconnect_0_M01_AXI_BRESP(1 downto 0),
      s_axi_bvalid => axi_interconnect_0_M01_AXI_BVALID,
      s_axi_rdata(31 downto 0) => axi_interconnect_0_M01_AXI_RDATA(31 downto 0),
      s_axi_rready => axi_interconnect_0_M01_AXI_RREADY,
      s_axi_rresp(1 downto 0) => axi_interconnect_0_M01_AXI_RRESP(1 downto 0),
      s_axi_rvalid => axi_interconnect_0_M01_AXI_RVALID,
      s_axi_wdata(31 downto 0) => axi_interconnect_0_M01_AXI_WDATA(31 downto 0),
      s_axi_wready => axi_interconnect_0_M01_AXI_WREADY,
      s_axi_wstrb(3 downto 0) => axi_interconnect_0_M01_AXI_WSTRB(3 downto 0),
      s_axi_wvalid => axi_interconnect_0_M01_AXI_WVALID
    );
axi_gpio_tat: component cadc_system_axi_gpio_tat_0
     port map (
      gpio_io_o(19 downto 0) => axi_gpio_tat_gpio_io_o(19 downto 0),
      s_axi_aclk => clk_wiz_0_clk_out1,
      s_axi_araddr(8 downto 0) => axi_interconnect_0_M02_AXI_ARADDR(8 downto 0),
      s_axi_aresetn => proc_sys_reset_0_peripheral_aresetn(0),
      s_axi_arready => axi_interconnect_0_M02_AXI_ARREADY,
      s_axi_arvalid => axi_interconnect_0_M02_AXI_ARVALID,
      s_axi_awaddr(8 downto 0) => axi_interconnect_0_M02_AXI_AWADDR(8 downto 0),
      s_axi_awready => axi_interconnect_0_M02_AXI_AWREADY,
      s_axi_awvalid => axi_interconnect_0_M02_AXI_AWVALID,
      s_axi_bready => axi_interconnect_0_M02_AXI_BREADY,
      s_axi_bresp(1 downto 0) => axi_interconnect_0_M02_AXI_BRESP(1 downto 0),
      s_axi_bvalid => axi_interconnect_0_M02_AXI_BVALID,
      s_axi_rdata(31 downto 0) => axi_interconnect_0_M02_AXI_RDATA(31 downto 0),
      s_axi_rready => axi_interconnect_0_M02_AXI_RREADY,
      s_axi_rresp(1 downto 0) => axi_interconnect_0_M02_AXI_RRESP(1 downto 0),
      s_axi_rvalid => axi_interconnect_0_M02_AXI_RVALID,
      s_axi_wdata(31 downto 0) => axi_interconnect_0_M02_AXI_WDATA(31 downto 0),
      s_axi_wready => axi_interconnect_0_M02_AXI_WREADY,
      s_axi_wstrb(3 downto 0) => axi_interconnect_0_M02_AXI_WSTRB(3 downto 0),
      s_axi_wvalid => axi_interconnect_0_M02_AXI_WVALID
    );
axi_interconnect_0: entity work.cadc_system_axi_interconnect_0_0
     port map (
      ACLK => clk_wiz_0_clk_out1,
      ARESETN => proc_sys_reset_0_interconnect_aresetn(0),
      M00_ACLK => clk_wiz_0_clk_out1,
      M00_ARESETN => proc_sys_reset_0_peripheral_aresetn(0),
      M00_AXI_araddr(31 downto 0) => axi_interconnect_0_M00_AXI_ARADDR(31 downto 0),
      M00_AXI_arready => axi_interconnect_0_M00_AXI_ARREADY,
      M00_AXI_arvalid => axi_interconnect_0_M00_AXI_ARVALID,
      M00_AXI_awaddr(31 downto 0) => axi_interconnect_0_M00_AXI_AWADDR(31 downto 0),
      M00_AXI_awready => axi_interconnect_0_M00_AXI_AWREADY,
      M00_AXI_awvalid => axi_interconnect_0_M00_AXI_AWVALID,
      M00_AXI_bready => axi_interconnect_0_M00_AXI_BREADY,
      M00_AXI_bresp(1 downto 0) => axi_interconnect_0_M00_AXI_BRESP(1 downto 0),
      M00_AXI_bvalid => axi_interconnect_0_M00_AXI_BVALID,
      M00_AXI_rdata(31 downto 0) => axi_interconnect_0_M00_AXI_RDATA(31 downto 0),
      M00_AXI_rready => axi_interconnect_0_M00_AXI_RREADY,
      M00_AXI_rresp(1 downto 0) => axi_interconnect_0_M00_AXI_RRESP(1 downto 0),
      M00_AXI_rvalid => axi_interconnect_0_M00_AXI_RVALID,
      M00_AXI_wdata(31 downto 0) => axi_interconnect_0_M00_AXI_WDATA(31 downto 0),
      M00_AXI_wready => axi_interconnect_0_M00_AXI_WREADY,
      M00_AXI_wstrb(3 downto 0) => axi_interconnect_0_M00_AXI_WSTRB(3 downto 0),
      M00_AXI_wvalid => axi_interconnect_0_M00_AXI_WVALID,
      M01_ACLK => clk_wiz_0_clk_out1,
      M01_ARESETN => proc_sys_reset_0_peripheral_aresetn(0),
      M01_AXI_araddr(31 downto 0) => axi_interconnect_0_M01_AXI_ARADDR(31 downto 0),
      M01_AXI_arready => axi_interconnect_0_M01_AXI_ARREADY,
      M01_AXI_arvalid => axi_interconnect_0_M01_AXI_ARVALID,
      M01_AXI_awaddr(31 downto 0) => axi_interconnect_0_M01_AXI_AWADDR(31 downto 0),
      M01_AXI_awready => axi_interconnect_0_M01_AXI_AWREADY,
      M01_AXI_awvalid => axi_interconnect_0_M01_AXI_AWVALID,
      M01_AXI_bready => axi_interconnect_0_M01_AXI_BREADY,
      M01_AXI_bresp(1 downto 0) => axi_interconnect_0_M01_AXI_BRESP(1 downto 0),
      M01_AXI_bvalid => axi_interconnect_0_M01_AXI_BVALID,
      M01_AXI_rdata(31 downto 0) => axi_interconnect_0_M01_AXI_RDATA(31 downto 0),
      M01_AXI_rready => axi_interconnect_0_M01_AXI_RREADY,
      M01_AXI_rresp(1 downto 0) => axi_interconnect_0_M01_AXI_RRESP(1 downto 0),
      M01_AXI_rvalid => axi_interconnect_0_M01_AXI_RVALID,
      M01_AXI_wdata(31 downto 0) => axi_interconnect_0_M01_AXI_WDATA(31 downto 0),
      M01_AXI_wready => axi_interconnect_0_M01_AXI_WREADY,
      M01_AXI_wstrb(3 downto 0) => axi_interconnect_0_M01_AXI_WSTRB(3 downto 0),
      M01_AXI_wvalid => axi_interconnect_0_M01_AXI_WVALID,
      M02_ACLK => clk_wiz_0_clk_out1,
      M02_ARESETN => proc_sys_reset_0_peripheral_aresetn(0),
      M02_AXI_araddr(31 downto 0) => axi_interconnect_0_M02_AXI_ARADDR(31 downto 0),
      M02_AXI_arready => axi_interconnect_0_M02_AXI_ARREADY,
      M02_AXI_arvalid => axi_interconnect_0_M02_AXI_ARVALID,
      M02_AXI_awaddr(31 downto 0) => axi_interconnect_0_M02_AXI_AWADDR(31 downto 0),
      M02_AXI_awready => axi_interconnect_0_M02_AXI_AWREADY,
      M02_AXI_awvalid => axi_interconnect_0_M02_AXI_AWVALID,
      M02_AXI_bready => axi_interconnect_0_M02_AXI_BREADY,
      M02_AXI_bresp(1 downto 0) => axi_interconnect_0_M02_AXI_BRESP(1 downto 0),
      M02_AXI_bvalid => axi_interconnect_0_M02_AXI_BVALID,
      M02_AXI_rdata(31 downto 0) => axi_interconnect_0_M02_AXI_RDATA(31 downto 0),
      M02_AXI_rready => axi_interconnect_0_M02_AXI_RREADY,
      M02_AXI_rresp(1 downto 0) => axi_interconnect_0_M02_AXI_RRESP(1 downto 0),
      M02_AXI_rvalid => axi_interconnect_0_M02_AXI_RVALID,
      M02_AXI_wdata(31 downto 0) => axi_interconnect_0_M02_AXI_WDATA(31 downto 0),
      M02_AXI_wready => axi_interconnect_0_M02_AXI_WREADY,
      M02_AXI_wstrb(3 downto 0) => axi_interconnect_0_M02_AXI_WSTRB(3 downto 0),
      M02_AXI_wvalid => axi_interconnect_0_M02_AXI_WVALID,
      M03_ACLK => clk_wiz_0_clk_out1,
      M03_ARESETN => proc_sys_reset_0_peripheral_aresetn(0),
      M03_AXI_araddr(31 downto 0) => axi_interconnect_0_M03_AXI_ARADDR(31 downto 0),
      M03_AXI_arready => axi_interconnect_0_M03_AXI_ARREADY,
      M03_AXI_arvalid => axi_interconnect_0_M03_AXI_ARVALID,
      M03_AXI_awaddr(31 downto 0) => axi_interconnect_0_M03_AXI_AWADDR(31 downto 0),
      M03_AXI_awready => axi_interconnect_0_M03_AXI_AWREADY,
      M03_AXI_awvalid => axi_interconnect_0_M03_AXI_AWVALID,
      M03_AXI_bready => axi_interconnect_0_M03_AXI_BREADY,
      M03_AXI_bresp(1 downto 0) => axi_interconnect_0_M03_AXI_BRESP(1 downto 0),
      M03_AXI_bvalid => axi_interconnect_0_M03_AXI_BVALID,
      M03_AXI_rdata(31 downto 0) => axi_interconnect_0_M03_AXI_RDATA(31 downto 0),
      M03_AXI_rready => axi_interconnect_0_M03_AXI_RREADY,
      M03_AXI_rresp(1 downto 0) => axi_interconnect_0_M03_AXI_RRESP(1 downto 0),
      M03_AXI_rvalid => axi_interconnect_0_M03_AXI_RVALID,
      M03_AXI_wdata(31 downto 0) => axi_interconnect_0_M03_AXI_WDATA(31 downto 0),
      M03_AXI_wready => axi_interconnect_0_M03_AXI_WREADY,
      M03_AXI_wstrb(3 downto 0) => axi_interconnect_0_M03_AXI_WSTRB(3 downto 0),
      M03_AXI_wvalid => axi_interconnect_0_M03_AXI_WVALID,
      M04_ACLK => clk_wiz_0_clk_out1,
      M04_ARESETN => proc_sys_reset_0_peripheral_aresetn(0),
      M04_AXI_araddr(31 downto 0) => axi_interconnect_0_M04_AXI_ARADDR(31 downto 0),
      M04_AXI_arready => axi_interconnect_0_M04_AXI_ARREADY,
      M04_AXI_arvalid => axi_interconnect_0_M04_AXI_ARVALID,
      M04_AXI_awaddr(31 downto 0) => axi_interconnect_0_M04_AXI_AWADDR(31 downto 0),
      M04_AXI_awready => axi_interconnect_0_M04_AXI_AWREADY,
      M04_AXI_awvalid => axi_interconnect_0_M04_AXI_AWVALID,
      M04_AXI_bready => axi_interconnect_0_M04_AXI_BREADY,
      M04_AXI_bresp(1 downto 0) => axi_interconnect_0_M04_AXI_BRESP(1 downto 0),
      M04_AXI_bvalid => axi_interconnect_0_M04_AXI_BVALID,
      M04_AXI_rdata(31 downto 0) => axi_interconnect_0_M04_AXI_RDATA(31 downto 0),
      M04_AXI_rready => axi_interconnect_0_M04_AXI_RREADY,
      M04_AXI_rresp(1 downto 0) => axi_interconnect_0_M04_AXI_RRESP(1 downto 0),
      M04_AXI_rvalid => axi_interconnect_0_M04_AXI_RVALID,
      M04_AXI_wdata(31 downto 0) => axi_interconnect_0_M04_AXI_WDATA(31 downto 0),
      M04_AXI_wready => axi_interconnect_0_M04_AXI_WREADY,
      M04_AXI_wstrb(3 downto 0) => axi_interconnect_0_M04_AXI_WSTRB(3 downto 0),
      M04_AXI_wvalid => axi_interconnect_0_M04_AXI_WVALID,
      S00_ACLK => clk_wiz_0_clk_out1,
      S00_ARESETN => proc_sys_reset_0_peripheral_aresetn(0),
      S00_AXI_araddr(31 downto 0) => jtag_axi_0_M_AXI_ARADDR(31 downto 0),
      S00_AXI_arprot(2 downto 0) => jtag_axi_0_M_AXI_ARPROT(2 downto 0),
      S00_AXI_arready(0) => jtag_axi_0_M_AXI_ARREADY(0),
      S00_AXI_arvalid(0) => jtag_axi_0_M_AXI_ARVALID,
      S00_AXI_awaddr(31 downto 0) => jtag_axi_0_M_AXI_AWADDR(31 downto 0),
      S00_AXI_awprot(2 downto 0) => jtag_axi_0_M_AXI_AWPROT(2 downto 0),
      S00_AXI_awready(0) => jtag_axi_0_M_AXI_AWREADY(0),
      S00_AXI_awvalid(0) => jtag_axi_0_M_AXI_AWVALID,
      S00_AXI_bready(0) => jtag_axi_0_M_AXI_BREADY,
      S00_AXI_bresp(1 downto 0) => jtag_axi_0_M_AXI_BRESP(1 downto 0),
      S00_AXI_bvalid(0) => jtag_axi_0_M_AXI_BVALID(0),
      S00_AXI_rdata(31 downto 0) => jtag_axi_0_M_AXI_RDATA(31 downto 0),
      S00_AXI_rready(0) => jtag_axi_0_M_AXI_RREADY,
      S00_AXI_rresp(1 downto 0) => jtag_axi_0_M_AXI_RRESP(1 downto 0),
      S00_AXI_rvalid(0) => jtag_axi_0_M_AXI_RVALID(0),
      S00_AXI_wdata(31 downto 0) => jtag_axi_0_M_AXI_WDATA(31 downto 0),
      S00_AXI_wready(0) => jtag_axi_0_M_AXI_WREADY(0),
      S00_AXI_wstrb(3 downto 0) => jtag_axi_0_M_AXI_WSTRB(3 downto 0),
      S00_AXI_wvalid(0) => jtag_axi_0_M_AXI_WVALID
    );
cadc_top_0: component cadc_system_cadc_top_0_0
     port map (
      i_channel_active => axi_gpio_digital_gpio2_io_o(0),
      i_clk_master => clock_divider_0_o_clk_div,
      i_rst => util_vector_logic_0_Res(0),
      i_sensor_analog(19 downto 0) => axi_gpio_analog_gpio_io_o(19 downto 0),
      i_sensor_digital(19 downto 0) => axi_gpio_digital_gpio_io_o(19 downto 0),
      i_sensor_ps(19 downto 0) => axi_gpio_ps_gpio_io_o(19 downto 0),
      i_sensor_qc(19 downto 0) => axi_gpio_qc_gpio_io_o(19 downto 0),
      i_sensor_tat(19 downto 0) => axi_gpio_tat_gpio_io_o(19 downto 0),
      o_bit_status => cadc_top_0_o_bit_status,
      o_fail_detect => cadc_top_0_o_fail_detect,
      o_out_airspd(19 downto 0) => cadc_top_0_o_out_airspd(19 downto 0),
      o_out_alt(19 downto 0) => cadc_top_0_o_out_alt(19 downto 0),
      o_out_flap(19 downto 0) => cadc_top_0_o_out_flap(19 downto 0),
      o_out_glove(19 downto 0) => cadc_top_0_o_out_glove(19 downto 0),
      o_out_mach(19 downto 0) => cadc_top_0_o_out_mach(19 downto 0),
      o_out_vspd(19 downto 0) => cadc_top_0_o_out_vspd(19 downto 0),
      o_out_wing(19 downto 0) => cadc_top_0_o_out_wing(19 downto 0)
    );
clk_wiz_0: component cadc_system_clk_wiz_0_0
     port map (
      clk_in1 => sys_clk,
      clk_out1 => clk_wiz_0_clk_out1,
      clk_out2 => clk_wiz_0_clk_out2,
      locked => clk_wiz_0_locked,
      resetn => sys_rst_n
    );
clock_divider_0: component cadc_system_clock_divider_0_0
     port map (
      i_clk => clk_wiz_0_clk_out2,
      i_rst_n => proc_sys_reset_0_peripheral_aresetn(0),
      o_clk_div => clock_divider_0_o_clk_div
    );
ila_0: component cadc_system_ila_0_0
     port map (
      clk => clk_wiz_0_clk_out1,
      probe0(19 downto 0) => cadc_top_0_o_out_mach(19 downto 0),
      probe1(31 downto 20) => B"000000000000",
      probe1(19 downto 0) => cadc_top_0_o_out_alt(19 downto 0),
      probe10(31 downto 0) => B"00000000000000000000000000000000",
      probe11(0) => '0',
      probe12(0) => '0',
      probe13(1 downto 0) => B"00",
      probe14(31 downto 0) => B"00000000000000000000000000000000",
      probe15(3 downto 0) => B"1111",
      probe16(0) => '0',
      probe17(2 downto 0) => B"000",
      probe18(2 downto 0) => B"000",
      probe19(0) => '0',
      probe2(1 downto 0) => cadc_top_0_o_out_airspd(1 downto 0),
      probe20(0) => '0',
      probe21(7 downto 0) => B"00000000",
      probe22(0) => '0',
      probe23(2 downto 0) => B"010",
      probe24(1 downto 0) => B"01",
      probe25(0) => '0',
      probe26(0) => '0',
      probe27(7 downto 0) => B"00000000",
      probe28(2 downto 0) => B"010",
      probe29(1 downto 0) => B"01",
      probe3(19 downto 0) => cadc_top_0_o_out_vspd(19 downto 0),
      probe30(0) => '0',
      probe31(3 downto 0) => B"0011",
      probe32(3 downto 0) => B"0011",
      probe33(3 downto 0) => B"0000",
      probe34(3 downto 0) => B"0000",
      probe35(0) => '0',
      probe36(3 downto 0) => B"0000",
      probe37(3 downto 0) => B"0000",
      probe38(0) => '0',
      probe39(0) => '0',
      probe4(19 downto 0) => cadc_top_0_o_out_wing(19 downto 0),
      probe40(0) => '0',
      probe41(0) => '0',
      probe42(0) => '0',
      probe43(0) => '0',
      probe5(31 downto 20) => B"000000000000",
      probe5(19 downto 0) => cadc_top_0_o_out_flap(19 downto 0),
      probe6(19 downto 0) => cadc_top_0_o_out_glove(19 downto 0),
      probe7(0) => cadc_top_0_o_bit_status,
      probe8(0) => cadc_top_0_o_fail_detect,
      probe9(0) => '0'
    );
jtag_axi_0: component cadc_system_jtag_axi_0_0
     port map (
      aclk => clk_wiz_0_clk_out1,
      aresetn => proc_sys_reset_0_peripheral_aresetn(0),
      m_axi_araddr(31 downto 0) => jtag_axi_0_M_AXI_ARADDR(31 downto 0),
      m_axi_arprot(2 downto 0) => jtag_axi_0_M_AXI_ARPROT(2 downto 0),
      m_axi_arready => jtag_axi_0_M_AXI_ARREADY(0),
      m_axi_arvalid => jtag_axi_0_M_AXI_ARVALID,
      m_axi_awaddr(31 downto 0) => jtag_axi_0_M_AXI_AWADDR(31 downto 0),
      m_axi_awprot(2 downto 0) => jtag_axi_0_M_AXI_AWPROT(2 downto 0),
      m_axi_awready => jtag_axi_0_M_AXI_AWREADY(0),
      m_axi_awvalid => jtag_axi_0_M_AXI_AWVALID,
      m_axi_bready => jtag_axi_0_M_AXI_BREADY,
      m_axi_bresp(1 downto 0) => jtag_axi_0_M_AXI_BRESP(1 downto 0),
      m_axi_bvalid => jtag_axi_0_M_AXI_BVALID(0),
      m_axi_rdata(31 downto 0) => jtag_axi_0_M_AXI_RDATA(31 downto 0),
      m_axi_rready => jtag_axi_0_M_AXI_RREADY,
      m_axi_rresp(1 downto 0) => jtag_axi_0_M_AXI_RRESP(1 downto 0),
      m_axi_rvalid => jtag_axi_0_M_AXI_RVALID(0),
      m_axi_wdata(31 downto 0) => jtag_axi_0_M_AXI_WDATA(31 downto 0),
      m_axi_wready => jtag_axi_0_M_AXI_WREADY(0),
      m_axi_wstrb(3 downto 0) => jtag_axi_0_M_AXI_WSTRB(3 downto 0),
      m_axi_wvalid => jtag_axi_0_M_AXI_WVALID
    );
proc_sys_reset_0: component cadc_system_proc_sys_reset_0_0
     port map (
      aux_reset_in => '1',
      bus_struct_reset(0) => NLW_proc_sys_reset_0_bus_struct_reset_UNCONNECTED(0),
      dcm_locked => clk_wiz_0_locked,
      ext_reset_in => sys_rst_n,
      interconnect_aresetn(0) => proc_sys_reset_0_interconnect_aresetn(0),
      mb_debug_sys_rst => '0',
      mb_reset => NLW_proc_sys_reset_0_mb_reset_UNCONNECTED,
      peripheral_aresetn(0) => proc_sys_reset_0_peripheral_aresetn(0),
      peripheral_reset(0) => NLW_proc_sys_reset_0_peripheral_reset_UNCONNECTED(0),
      slowest_sync_clk => clk_wiz_0_clk_out1
    );
util_vector_logic_0: component cadc_system_util_vector_logic_0_0
     port map (
      Op1(0) => proc_sys_reset_0_peripheral_aresetn(0),
      Res(0) => util_vector_logic_0_Res(0)
    );
end STRUCTURE;
