ATaylorCEngFIET/f14_CADC/hdl/ras.vhd

-------------------------------------------------------------------------------
-- RAS - Random Access Storage (PN 944114)
-- F-14A Central Air Data Computer - FPGA Implementation (Bit-Serial)
--
-- Scratchpad RAM with serial data interface and parallel addresses.
-- Addresses come from parallel microword (bits 24-29 read, 30-35 write).
-- Data shifts in/out during WO phase.
--
-- Timing:
--   WA T0: Latch read/write addresses from parallel microword
--   WO T0: Fetch read data to shift register
--   WO T0-T19: Shift out read data, shift in write data
--   WO T19: Write data to RAM if write enabled
-------------------------------------------------------------------------------

LIBRARY IEEE;
USE IEEE.STD_LOGIC_1164.ALL;
USE IEEE.NUMERIC_STD.ALL;

ENTITY ras IS
  GENERIC (
    g_addr_width : NATURAL := 6;
    g_data_width : NATURAL := 20
  );
  PORT (
    i_clk        : IN  STD_LOGIC;
    i_rst        : IN  STD_LOGIC;
    -- Timing inputs
    i_phi2       : IN  STD_LOGIC;   -- Shift on phi2
    i_word_type  : IN  STD_LOGIC;   -- '0'=WA, '1'=WO
    i_t0         : IN  STD_LOGIC;   -- First bit of word
    i_t19        : IN  STD_LOGIC;   -- Last bit of word
    -- Parallel address inputs (from microword)
    i_rd_addr    : IN  STD_LOGIC_VECTOR(g_addr_width-1 DOWNTO 0);
    i_wr_addr    : IN  STD_LOGIC_VECTOR(g_addr_width-1 DOWNTO 0);
    i_write_en   : IN  STD_LOGIC;   -- Write enable (from control)
    -- Serial data interface
    i_wr_data_bit: IN  STD_LOGIC;   -- Serial write data input (during WO)
    o_rd_data_bit: OUT STD_LOGIC    -- Serial read data output (during WO)
  );
END ENTITY ras;

ARCHITECTURE rtl OF ras IS

  TYPE t_mem IS ARRAY(0 TO 2**g_addr_width - 1)
    OF STD_LOGIC_VECTOR(g_data_width-1 DOWNTO 0);
  SIGNAL s_mem : t_mem := (OTHERS => (OTHERS => '0'));

  -- Latched addresses
  SIGNAL s_rd_addr  : STD_LOGIC_VECTOR(g_addr_width-1 DOWNTO 0) := (OTHERS => '0');
  SIGNAL s_wr_addr  : STD_LOGIC_VECTOR(g_addr_width-1 DOWNTO 0) := (OTHERS => '0');
  SIGNAL s_wr_en_lat: STD_LOGIC := '0';
  
  -- Data shift registers
  SIGNAL s_rd_sr    : STD_LOGIC_VECTOR(g_data_width-1 DOWNTO 0) := (OTHERS => '0');
  SIGNAL s_wr_sr    : STD_LOGIC_VECTOR(g_data_width-1 DOWNTO 0) := (OTHERS => '0');
  
  -- Write pending flag - complete write one phi2 after T19
  SIGNAL s_wr_pending : STD_LOGIC := '0';
  
  -- Output shift register (loaded at end of WA, shifted during WO)
  SIGNAL s_out_sr   : STD_LOGIC_VECTOR(g_data_width-1 DOWNTO 0) := (OTHERS => '0');
  SIGNAL s_out_ready: STD_LOGIC := '0';  -- Flag: output data is ready
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
