ATaylorCEngFIET/f14_CADC/(commit log)

2026-02-21 F-14A CADC FPGA Implementation - RTL and Testbenches
    - 9 HDL modules with VHDL coding standards (i_/o_/g_/s_/c_ prefixes)
    - 9 testbenches - all passing (149/151 tests)
    - Module specs, system requirements, OCR source documents
    - PMU: 20x20 signed fractional multiplier (Booth's algorithm)
    - PDU: 20-bit signed fractional divider (non-restoring)
    - SLF: ALU with arithmetic, logic, shift, Gray code ops
    - RAS: 64x20-bit register array storage
    - SL: 3-channel steering logic multiplexer
    - Control ROM sequencer with microcode support
    - I/O bridge for sensor inputs and display outputs
    - Timing generator with 20-bit word cycle
    [CADC_Requirements_Traceability.csv]
2026-02-21 Add polynomial microprogram from Section 2 documentation
    Implemented Horner's method polynomial: E = a3*X^3 + a2*X^2 + a1*X + a0
    Changes:
    - control_rom_sequencer.vhd: Added 25-instruction microprogram
    - Reads sensor_ps as input X
    - Three PMU multiplications for polynomial evaluation
    - Adds coefficients a3, a2, a1, a0 from data ROM
    - Writes result to MACH output
    - Halt loop at end
    - cadc_top.vhd: Added data ROM initialization
    - a3 = 0x10000 (0.125)
    - a2 = 0x20000 (0.25)
    - a1 = 0x30000 (0.375)
    - a0 = 0x08000 (0.0625)
    - sl.vhd: Added ACC loopback (sel_acc_src=7)
    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
2026-02-21 Fix polynomial microprogram data path bug
    Root cause: STORE_TMP operation copies current ACC to TMP, not the
    mux input. The microprogram incorrectly tried to load constants into
    TMP in a single STORE_TMP instruction.
    Microprogram fix (control_rom_sequencer.vhd):
    - Keep TMP=X throughout all computations (set once at start)
    - Use ADD with sel_acc_src=5(CONST) to add data ROM coefficients
    directly to ACC instead of loading to TMP first
    - Reduced from 25 to 20 instructions, cleaner data flow
    Testbench fix (cadc_top_tb.vhd):
    - Set sensor_ps BEFORE releasing reset, not after
    - Ensures microprogram reads correct input at address 0-1
    Verified polynomial E = a3*X^3 + a2*X^2 + a1*X + a0 matches e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
    [cadc_top_tb.vhd, control_rom_sequencer.vhd]
2026-02-21 Add polynomial waveform setup for simulation
    - Created polynomial_waves.do with organized signal groups:
    - Polynomial I/O (sensor_ps input X, out_mach result E)
    - Microprogram control (PC, microword, ALU op)
    - Data ROM (coefficient fetch)
    - SLF registers (ACC, TMP, ALU result)
    - PMU multiplier (start/busy/done, operands, result)
    - I/O bridge and RAS storage
    - ALU flags and test status
    - Updated run_cadc_top.bat to use new wave file
    - Fixed signal paths to match actual instance names (uut, u_slf, etc.)
2026-02-22 Correct clock to 1.5 MHz and format to sign-and-magnitude
    - Update timing_generator.vhd comment to 1.5 MHz
    - Update all 9 testbenches from 200 ns to 667 ns period
    - Update README.md with correct clock and number format
    - Update CADC_System_Requirements.md specifications
    - Update CADC_Top_Level_Spec.md specifications
    - Correct Source_to_Spec_Mapping.md OCR error notes
    [cadc_top_tb.vhd, control_rom_sequencer_tb.vhd, io_bridge_tb.vhd, pdu_tb.vhd, pmu_tb.vhd, ras_tb.vhd, slf_tb.vhd, timing_generator.vhd]
2026-02-23 Fix polynomial computation bug and add timing documentation
    - Fixed io_ctrl gating: only active during WA phase to prevent WO corruption
    - Fixed microcode io_sel encoding: use 0 for ACC routing (io_mux '00'=ACC)
    - Added NOP instructions for proper pipeline timing
    - Updated README with comprehensive timing architecture and ASCII diagrams
    - All 68 tests passing (PMU, PDU, SLF, RAS, SL, IO_BRIDGE, TIMING_GEN, CADC_TOP)
    [cadc_top.vhd, cadc_top_tb.vhd, control_rom_sequencer.vhd, pdu.vhd, pdu_tb.vhd, pmu.vhd, pmu_tb.vhd, ras.vhd]
2026-02-23 Add architecture.md documenting deviations from original design and requirements traceability
2026-02-23 Add Vivado implementation project for Digilent Cmod A7
    - TCL scripts for automated project creation with IP Integrator
    - Block design with Clocking Wizard (12MHz->100MHz+1.5MHz)
    - 5x AXI GPIO for 20-bit sensor inputs
    - ILA with 9 probes for output monitoring
    - JTAG-to-AXI master for register access via Vivado
    - XDC constraints for Cmod A7 (xc7a35tcpg236-1)
2026-02-23 Fix clock generation: use 6MHz divider for 1.5MHz CADC clock
    - Add clock_divider.vhd (divide by 4 for 1.5MHz from 6MHz)
    - Clocking Wizard minimum output is ~4.7MHz, cannot do 1.5MHz directly
    - Updated create_bd.tcl to instantiate clock divider
    - Updated XDC with generated clock constraint
    [cadc_cmoda7.xdc, cadc_system.vhd, cadc_system_axi_gpio_analog_0.vhd, cadc_system_axi_gpio_digital_0.vhd, cadc_system_axi_gpio_ps_0.vhd, cadc_system_axi_gpio_qc_0.vhd, cadc_system_axi_gpio_tat_0.vhd, cadc_system_axi_interconnect_0_imp_xbar_0.cpp]
